Coal56AB/Oscilloscope/README.md

# Oscill — двухканальный осциллограф

Самодельный осциллограф с интерфейсом 1024 × 600, сенсорным экраном и физическими энкодерами. Проект объединяет приложение на C, платформу Zynq-7020, контроллер управления STM32 и основную плату в Altium Designer.

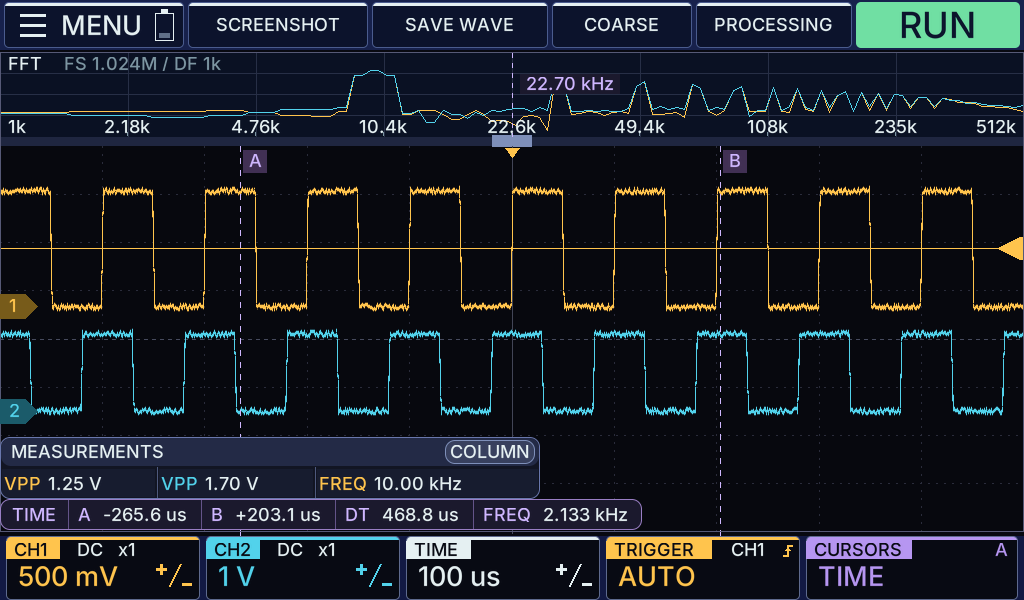
[picture p1: ZYNQ7020/gui/docs/images/preview.png]
Экран осциллографа


## Возможности

- два канала, запуск по фронту, режимы AUTO, NORMAL и SINGLE;
- измерения, курсоры, FFT и увеличение осциллограмм;
- управление касаниями, энкодерами и клавиатурой;
- сохранение и просмотр BMP и CSV;
- настольный симулятор для Windows и Linux.
- служебный задний OLED со страницами состояния по K1 ([описание](docs/HARDWARE.md)).

## Плата

Основная плата с установленным экраном, вид спереди

*3D-модель платы с установленным экраном, вид спереди: два BNC-входа и органы управления под экраном.*

## Состав проекта

- [`ZYNQ7020/`](ZYNQ7020/README.md) — приложение осциллографа, Linux и FPGA.
- [`STM32/`](STM32/README.md) — контроллер кнопок и энкодеров.
- [`TERMINAL/`](TERMINAL/README.md) — ПК-приложение для USB–UART, управления осциллографом и просмотра SD.
- [`PCB/`](PCB/) — схемы, печатная плата и файлы изготовления.

Описание интерфейса — в [README GUI](ZYNQ7020/gui/README.md), устройство платы — в [README PCB](https://github.com/Coal56AB/OscilPCB/blob/eee4854651807f123bbf42ff2ac2b7066b95e3b1/README.md), сборка — в [документации разработчика](docs/BUILD.md).
