Coal56AB/Oscilloscope/docs/CONTROL_PROTOCOL.md

# Панель управления

Панель STM32 передаёт в Zynq действия кнопок и энкодеров, а также получает команды состояния и входных диапазонов. В штатной системе приложение автоматически ищет USB–UART панели и восстанавливает связь после переподключения.

Формат сообщений и правила обмена нужны при изменении прошивки панели или приложения; они находятся в [описании протокола](agents/CONTROL_PROTOCOL.md).
