Coal56AB/Oscilloscope/docs/agents/zynq7020/BOARD.md

# Аппаратный аудит ZYNQ MINI rev B

Источник: [оригинальная схема, 12 листов](../../zynq7020/ZYNQ_MINI_REVB%20Schematic.pdf). Номера ниже — страницы PDF, начиная с 1. Текст сверён с изображениями соответствующих страниц.

## Подтверждённые сведения

| Узел | Схема, компонент, сигналы | Вывод |
|---|---|---|
| Zynq | с. 2–6, U8; символы `xc7z010-clg400`, в DDR-секции `Zynq 7010/7020` | **На фактической плате XC7Z020: подтверждено владельцем 08.10.2026.** В схеме использован символ 7010. Корпус CLG400 указан в схеме; полный суффикс и speed grade не установлены. |
| DDR | с. 6, U1 `MT41J256M16`, U8D; DQ0…15, DQS0/1, DM0/1, A0…14, BA0…2 | 256M × 16 бит = 512 МиБ, одна микросхема, **шина 16 бит**, питание 1,5 В. DQ16…31 Zynq не подключены. Speed bin памяти и настроенная частота не указаны. |
| QSPI | с. 8, U15 `W25Q128FVSIG`; с. 4 U8B MIO1…6 | 128 Мбит = **16 МиБ**, 3,3 В; CS, DQ0…3, CLK. Объём по схеме, JEDEC ID фактической платы ещё не считан. |
| Загрузка | с. 4 SW1, PR7/PR8, MIO4/5; с. 8 подписи TF1/QSPI | Переключатель задаёт boot straps: подписи схемы `10` для QSPI, `11` для TF1; положения ON и порядок битов проверять по схеме/измерению, не по виду переключателя. JTAG — отдельный путь восстановления. |
| PS clock | с. 4 X2 `33.333M/20PPM`, U8B E7 | PS_CLK_33D333M. |
| PL clock | с. 5 X1 `50M/10PPM`, U8G K17 | PL_CLK_50M, bank 35, 3,3 В. Это не подтверждённая частота АЦП. |
| HDMI | с. 5 U8G и с. 11 J1, PR15/16, Q1/Q2 | TMDS прямо из PL. Отдельного ADV7511 или другого передатчика нет. Данные: D0 P/N D19/D20, D1 C20/B20, D2 B19/A20; clock H16/H17. HDMI_OUT_EN H18 управляет питанием J1 через Q1/Q2. |
| HDMI DDC/HPD | с. 11 J1 pins 15/16/19 | DDC CLK/DATA не подключены к Zynq; HPD только через R36 100 кОм на землю. EDID и hotplug нельзя рассчитывать получать по этой схеме. Нужен фиксированный проверенный видеорежим. |
| USB Host | с. 10 U19 `USB3320C-EZK_6`, P3, X6 24 МГц, Q3 AO3407, Q4 AO3400 | PHY ULPI на PS USB0, с. 4 MIO28…39. CPEN U19 pin 17 → USBCP_EN → Q4/Q3 → VCC_USB_5.0. Есть аппаратный путь питания периферии. |
| USB reset | с. 4 U8C MIO46 D16, с. 10 U19 pin 27 | USBPHY_nRSET, active low, R66 к 1,8 В. |
| USB-C особенности | с. 10 P3 CC1/CC2 → USB_ID | Type-C CC подключены к входу ID PHY; отдельного контроллера CC и обычной схемы Rp/Rd не показано. Host Mode и совместимость конкретного переходника/кабеля требуют проверки. Это не свидетельство невозможности работы через подходящий переходник. |
| UART | с. 4 U8C MIO48 B12 TX, MIO49 C12 RX; с. 3 U9/U10 74LVC1T45, U11 CH340E, P1 | PS UART1 имеет уровни 1,8 В; U9/U10 преобразуют к 3,3 В для CH340E. **P1 несёт USB D+/D− CH340E, а не TX/RX UART.** |
| JTAG | с. 3 P2 → U12 FT2232HL → FPGA_TCK/TMS/TDI/TDO | Отдельный USB-интерфейс для JTAG; не PS USB Host и не USB-UART P1. |
| PS Ethernet | с. 4 U8C MIO16…27 (RGMII), MIO52/53 (MDC/MDIO); с. 7 U18 `RTL8211E-VL`, J3 `HR911130A` | Гигабитный порт подключён непосредственно к PS, уровни интерфейса 1,8 В. Для Linux можно использовать встроенный GEM без отдельного Ethernet MAC в PL; подключение и скорость фактической платы требуют проверки. |
| PL Ethernet | с. 5 U8G, bank 35, сигналы `PHY_*_PL`; с. 7 U17 `RTL8211E-VB`, J2 `HR911130A` | Второй гигабитный порт, интерфейс к PL 3,3 В. Не путать с PS-портом U18/J3. |
| TF1 | с. 4 MIO40…45; с. 8 TF1, U14 TXS02612RTWR | SD0, 4-bit, преобразование 1,8 → 3,3 В, загрузочный слот. CMD/SCK/D0…3. У слота нет подтверждённой линии card detect до PS. |
| TF2 | с. 4 MIO10…15; с. 8 TF2 | SD1, 4-bit, 3,3 В, второй слот для пользовательских данных; подпись схемы «не поддерживает загрузку». Сигнал INT слота не выведен к PS. |
| Расширение | с. 9 CAM1 40-pin, с. 5 U8F | 34 PL I/O: пары FPGA_GPIO_8P/N_34…24P/N_34, bank 34, 3,3 В; 6 оставшихся контактов — питание/земля. Это 34 отдельных сигнальных вывода, не 34 пары. |
| Занятые PL I/O | с. 5/7/9/12 | Bank 35: HDMI, PL Ethernet U17, I²C EEPROM U16, OLED J4, кнопки, 50 МГц. Bank 34: CAM1 и отдельные LED. Нельзя считать все выводы корпуса свободными. |

## OLED и служебные кнопки

OLED12864 J4: листы 5/12 подтверждают D0=E18, D1=E19, D/C=F16, RST=F17,
CS на земле. Листы 4/5/9: **K1=FPGA_PS_KEY1, PS MIO0 (E6)**;
K2=FPGA_PL_KEY1 (M20), K3=FPGA_PL_KEY2 (M19). Кнопки active low с
подтяжками PR9. Прежнее назначение K1=M19 было ошибкой чтения схемы;
владелец подтвердил, что этот вход физически переключается K3.
Размер 128×64 следует из обозначения J4; контроллер в схеме
не назван. Служебная индикация использует явный профиль SSD1306 из study;
его совместимость и измерения — отдельная проверка на плате. Реализация —
[STATUS_DISPLAY.md](../STATUS_DISPLAY.md).

## STM32 и АЦП основной платы

В `PCB/AnalExtend/AnalExtend.SchDoc` указаны `AD9288BSTZ-100`; в `Interfaces.SchDoc` — модуль `STM32F103RCT6` с двумя PBD 2×14. Владелец подтвердил STM32F103RCT6; назначения входов панели по схеме и выбранный UART — [STM32.md](../STM32.md). Электрическая связность фактической платы и установленный АЦП ещё не проверены.

[AD9288 Rev. C](https://www.analog.com/media/en/technical-documentation/data-sheets/AD9288.pdf) описывает две 8-битные ветви до 100 MSPS у версии -100. Два AD9288 дают четыре 8-битные шины, то есть 32 линии данных. Интерливинг двух ветвей одного канала при сдвиге тактов на половину периода — целевое решение; сам факт применения -100 не подтверждает корректность фаз, аналоговой полосы или gain/offset alignment.

По текущей основной схеме оставшиеся два I/O — общие CLK_A/CLK_B обеих микросхем. XS1.3/4 соответствуют CAM1.39/2, P15/U15; попарная нумерация XS1 отличается от последовательных рядов CAM1 в PDF. S1=1, S2=0, DFS=0. Полная карта и выбранный приём — [ADC_CAPTURE.md](../ADC_CAPTURE.md). Соединения и фазы на установленной плате измерением ещё не подтверждены. UART панели идёт через USB и контактов CAM1 не занимает.

Владелец подтвердил путь панели: UART STM32 → USB–UART мост на модуле STM32 → USB hub вместе с сенсором → PS USB Host P3 Zynq. Linux включает драйверы CH341, CP210x и CDC ACM, GUI автоматически ищет панель среди USB serial устройств. Точная маркировка моста не установлена. P1 Zynq остаётся загрузочной консолью. Физический обмен панели с Zynq ещё требует проверки на устройстве.

## Перед первым запуском платы

Handoff и FSBL получены из `ZYNQ7020/build.ps1`: DDR ×16, 512 МиБ, заданные 400 МГц; CPU 600 МГц. Режим HDMI — 1024×600, pixel clock 50 МГц, totals 1344×620. Первый тест запускается с TF1 по [BRINGUP.md](../BRINGUP.md).

На плате проверить DDR training и тест памяти; ULPI reset/clock/CPEN и VBUS; USB enumeration и два независимых tracking ID сенсора; видеорежим дисплея. Для последующих аппаратных этапов нужны маркировки U8/U1/U15, подключение STM32, распиновка АЦП и фазы. Резервная копия QSPI нужна перед её изменением. Эти проверки не заменяются успешной компиляцией.

Справочные источники: [AMD UG585](https://docs.amd.com/r/en-US/ug585-zynq-7000-SoC-TRM/Introduction), [параметры HP-портов](https://docs.amd.com/r/en-US/ug585-zynq-7000-SoC-TRM/Performance-Optimization-Summary), [пин-группы Linux Zynq](https://github.com/Xilinx/linux-xlnx/blob/xlnx_rebase_v6.6_LTS_merge_6.6.70/drivers/pinctrl/pinctrl-zynq.c).
