Coal56AB/Oscilloscope/ZYNQ7020/gui/README.md

# OscilGUI

Интерфейс двухканального осциллографа для LCD 1024 × 600. Отрисовка написана на C и формирует готовый кадр RGB888, поэтому её можно встроить в проект прибора или запустить как настольный симулятор в Windows и Linux.

Основной экран OscilGUI

## Возможности

- два канала с независимыми масштабом, положением и связью AC/DC;
- режим XY: CH1 по горизонтали, CH2 по вертикали, включение в DISPLAY → MODE;
- развёртка от 10 нс/дел до 5 с/дел; на приборе в AUTO свыше 100 мс/дел — прокрутка ROLL;
- длина записи 10K–1M точек в PROCESSING с автоматической частотой отсчётов;
- запуск по фронту в режимах `AUTO`, `NORMAL` и `SINGLE`;
- до десяти измерений, временные и амплитудные курсоры;
- FFT с логарифмической шкалой, сглаживание, окраска по плотности и увеличение сохранённого захвата;
- управление с сенсорного экрана, клавиатуры или отдельной панели энкодеров;
- сохранение последних настроек и пять пресетов с выбором состояния при включении;
- измерение АЧХ и независимая амплитудная коррекция каналов;
- просмотр BMP и CSV, сохранение снимков экрана и отсчётов сигнала;
- сглаженный шрифт Inter.

## Управление

Нижние карточки открывают настройки каналов, развёртки, триггера и курсоров. Масштаб и положение меняются энкодерами или жестами на графике. Верхняя панель содержит меню, снимок экрана, сохранение CSV, обработку сигнала и `RUN/STOP`.

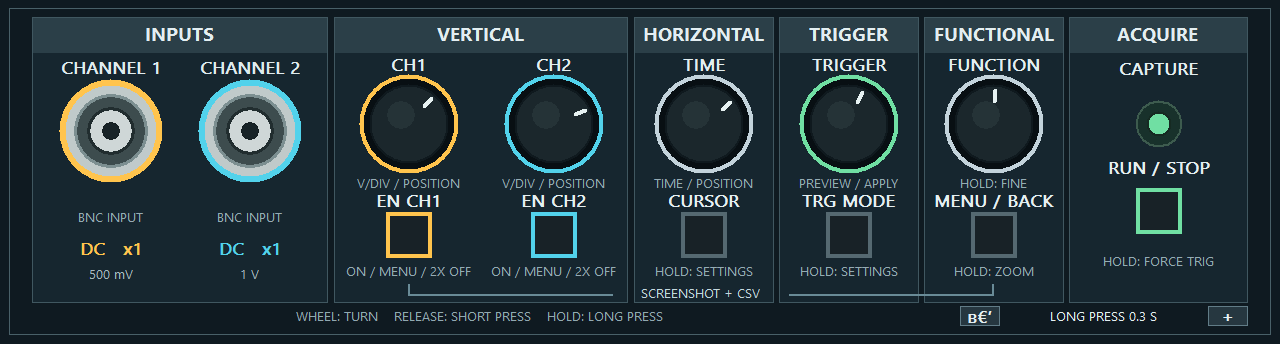
[picture p2: ZYNQ7020/gui/docs/images/panel_preview.png]
Панель энкодеров и кнопок


Короткое нажатие энкодера выбирает действие, удержание вызывает дополнительную функцию. В симуляторе колесо мыши вращает энкодер, а клик имитирует нажатие. Основные действия также доступны клавишами `1`, `2`, `C`, `T`, `M`, `Space`, `Enter`, `F2` и `F3`.

Пресеты находятся в MENU → SETUP → PRESETS, выбор состояния при включении — в SETUP.
Настройки, сохранение и калибровка — в [описании работы с прибором](../../docs/USAGE.md).

## Сборка

### Windows

Нужны [MSYS2](https://www.msys2.org/), UCRT64 и CMake. Сборка использует WinAPI; команды приведены в [документации разработчика](../../docs/agents/BUILD.md#windows).

Приложение автоматически использует отдельный дисплей 1024 × 600, если он подключён в режиме «Расширить». Панель управления остаётся на основном мониторе.

### Linux

Нужны CMake и SDL2. Команды для настольного Linux и ARM — в [документации разработчика](../../docs/BUILD.md).

Флаг `--windowed` принудительно включает оконный режим, а `--kiosk` открывает только LCD на весь экран.

## ASUS Tinker Board

Для Tinker Board собирается переносимый пакет ARM32/ARM64. Распакуйте его на накопитель и запустите `START.desktop` — компилятор на плате не нужен.

Инструкция по самостоятельной сборке находится в [`tinker_board/BUILDING.md`](tinker_board/BUILDING.md).

## Встраивание

Отрисовку интерфейса можно подключить к приложению прибора.

Описание структур данных и пример вызова приведены в [`DEVELOPMENT.md`](DEVELOPMENT.md). Сборка для Zynq — в [документации проекта](../../docs/BUILD.md).
