Coal56AB/Oscilloscope/docs/FPGA_DSP.md

# Обработка сигнала в ПЛИС

В `ZYNQ7020/fpga/` находятся модули подавления шума, сглаживания, измерений, определения фронтов и управления триггером. Они обрабатывают отсчёты АЦП независимо от протокола исследуемого сигнала.

Перенос обработки в ПЛИС выполняется поэтапно. Состав модулей, их подключение и оставшиеся границы обработки описаны в [техническом документе](agents/FPGA_DSP.md).
