Coal56AB/Oscilloscope/docs/agents/ADC_CAPTURE.md

# Захват AD9288 на Zynq

## Запланированные доработки ПЛИС

По поручению владельца от 30.10.2026 следующие задачи сохранены для будущей
реализации. Обе задачи открыты; приведённые ниже требования не описывают
возможности текущего bitstream.

- [ ] **PL-TRIGGER — расширенный аппаратный триггер.** Добавить запуск по
  длительности импульса (короче/длиннее заданной), неполному импульсу
  (runt: пересечение первого порога без достижения второго), выходу из окна
  напряжений и пропаданию импульсов по тайм-ауту. Условия проверять по входным
  отсчётам до прореживания, чтобы событие между сохранёнными точками не
  терялось. Передавать в запись тип события и его положение с однозначной
  привязкой к исходной и сохранённой временным шкалам. До реализации
  определить границы сравнений, полярность, гистерезис, повторный взвод и
  влияние фильтрации. Проверить события на границах DMA-блоков, порогов и
  заданной длительности, а также короткие события внутри интервала
  прореживания; согласовать поведение AUTO/NORMAL/SINGLE, holdoff и FORCE.
- [ ] **PL-PRETRIGGER — аппаратная предыстория на всю выбранную глубину.**
  Реализовать управляемое ПЛИС кольцо записи в DDR с настраиваемой долей
  предыстории, накоплением заданного участка после события и аппаратной
  фиксацией законченной записи. Память выделяет Linux-драйвер; готовая
  запись защищена от перезаписи до возврата владения. ARM получает запись
  с точным положением события, фактическими длинами до/после него и
  признаками неполной предыстории или потери данных. Определить поведение
  события до заполнения предыстории и крайних положений триггера.
  Проверить SINGLE с большой долей предыстории, переход через конец кольца,
  все поддерживаемые глубины и частоты выборки, Peak Detect, RUN/STOP,
  повторный взвод и одновременную работу HDMI.

Эти изменения развивают захват и триггер. Существующее разделение
ПЛИС/драйвер/обработка/GUI сохраняется; аппаратные параметры и достижимые
характеристики подтверждаются расчётом и измерениями при реализации.

## Запуск и DEBUG

Штатный Linux запускает GUI с `--adc /dev/oscill-capture`; путь задаёт
`ADC_DEVICE` в `/etc/default/oscill`. Для настольного Linux остаются прежний
деморежим без аргументов, `--raw-demo` и `--capture FILE`. Windows работает
прежним настольным симулятором.

DEBUG → SIMULATION по умолчанию ON. АЦП тактируются, FPGA принимает их шины,
DMA записывает данные в DDR, драйвер выдаёт завершённый блок. Только после
этого обработчик формирует отдельную запись
симулируемого сигнала. CH1 WAVE, CH2 WAVE и FREQUENCY в GENERATOR действуют
на следующий полученный блок. Выбор формы использует тот же генератор, что
настольный GUI; для периодических форм применяется таблица из 1024 значений.
К периодическим DEBUG-формам добавляется псевдослучайный шум −1/0/+1 код
(при номинальной шкале DEBUG — до ±20 мВ). Шум меняется между отсчётами
и аппаратными блоками; повторная обработка того же блока даёт те же значения.
NOISE остаётся отдельной формой генератора. Закончившийся DMA остаётся
условием каждого нового блока,
но CPU не перечитывает по байту значения, которые будут заменены.

SIMULATION OFF копирует значения АЦП из DMA-памяти в историю для обработки.
Ни отсутствие устройства, ни timeout, ни ошибка DMA не запускают запасной
программный генератор. В STOP удерживается прежняя запись; масштаб, позиция,
ZOOM и FFT работают с ней. Смена SIMULATION/GENERATOR в STOP не меняет её.
FORCE получает новые аппаратные блоки даже в STOP и ждёт полного
экранного интервала.

Клоки АЦП работают постоянно. STOP останавливает получение новых записей GUI,
а не преобразования: драйвер продолжает обмен и может переиспользовать только
блоки, которыми приложение не владеет. AUTO показывает полный интервал без
найденного фронта, NORMAL ждёт пересечения уровня, SINGLE удерживает первый подходящий
интервал. В bitstream с DSP фильтрация и определение фронта выполняются
в ПЛИС, номер события передаётся в TRG1. Приложение собирает запись вокруг
этого номера без повторного поиска. Для прежнего bitstream и специальных
режимов сохраняется программный путь. Аппаратного кольцевого pretrigger
на всю память в этой реализации нет.

RISING требует подтверждённого перехода снизу вверх через шумовую полосу,
FALLING — сверху вниз. Её полуширина — не менее двух кодов АЦП, увеличивается
по соседним разностям отсчётов и ограничена четвертью наблюдаемого размаха и
расстоянием уровня до его границ в программном пути; DSP использует полосу
в два кода после фильтрации. После подтверждения метка остаётся на
пересечении выбранного порога. Короткий возврат на исходную сторону не является
фронтом. При начале разрешённого интервала состояние восстанавливается по
предыдущим отсчётам. В BOTH допускаются оба направления с тем же условием.
Если выбран FILTER канала, поиск использует ту же симметричную фильтрацию,
что и видимая кривая; исходная запись не изменяется.
Если экранный интервал помещается в историю, поиск фронта начинается после
необходимой предыстории. Маркер вычисляется из позиции найденного отсчёта
и экранного интервала, поэтому перемещается вместе с сигналом при PAN и ZOOM.
FFT рассчитывается в потоке обработки при включённом спектре. Используются
первые последовательные отсчёты видимого участка: степень двойки от 1024 до
1048576, не больше доступного участка; короткий участок дополняется нулями.
Окно — Ханна, среднее удаляется;
выборка через всю запись для FFT не выполняется. Шкала начинается с 0 Гц,
переходя к логарифмической по закону `DF × expm1(log1p(Fs/2/DF) × x)`;
DF=Fs/N, подписи, группировка и курсор используют один N. Нули при дополнении
не увеличивают физическое разрешение короткой записи.
Исходные суммы и квадраты кодов сохраняются отдельно для ZERO/NOISE и оценки
шума при калибровке АЧХ. Measurements использует обработанные отсчёты канала.

PROCESSING → CH1/CH2 FILTER сглаживает отсчёты выбранного канала перед
построением экранной кривой. LOW, MEDIUM и HIGH — симметричное скользящее
среднее по 5, 17 и 65 сохранённым отсчётам; окно не зависит от увеличения
остановленной записи. Сглаживаются кривая, её границы, попадания COLORING
и соединения. У фильтра нет фазового сдвига; фронты становятся положе,
короткие импульсы и высокие частоты ослабляются. Это частоты относительно
Fs сохранённой записи, а не постоянная аналоговая полоса.
Нативные Peak Detect экстремумы с неизвестным временем внутри интервала
не накладываются поверх отфильтрованного канала. Исходная запись и FFT
не меняются; измерения напряжения, частота, период и duty вычисляются по
обработанной кривой. OFF полностью возвращает
прежнюю кривую. В STOP смена фильтра пересчитывает ту же запись без захвата.
Длина записи выбирается в PROCESSING → RECORD LENGTH; TIME отсутствует
в главном меню, настройки развёртки открываются нижней карточкой TIME.

Обычный след и INTENSITY COLORING используют реальные попадания сохранённых
отсчётов в каждый пиксель временного окна; при FILTER берутся сглаженные
значения тех же отсчётов. Плотность нормируется по максимуму
канала. В обычном режиме она задаёт яркость жёлтого/голубого; в COLORING
редкие попадания синие, наиболее частые красные. Соединение отсчётов тонкое,
без дополнительного контура, и не увеличивает счётчики. Для аппаратной записи
обработчик отдельно растеризует отрезки между всеми последовательными
сохранёнными отсчётами с пересечением временных границ пикселя. Кривая из
одного выбранного отсчёта на колонку для этого не используется. Покрытие
отрезков задаёт яркость соединения: максимум каждой колонки имеет полную
яркость независимо от сжатия; редкое покрытие ослабляется по корневой шкале
с нижним уровнем 96 из 255. Карта реальных попаданий накладывается
поверх; в COLORING соединение синее и имеет минимальную видимую яркость.
Ни покрытие отрезков, ни Peak Detect не добавляют попаданий в гистограмму.
Сплошной заливки
между минимальным и максимальным шумовым отсчётом нет.

Peak Detect хранит границы двухотсчётных интервалов, но не время и порядок
самих экстремумов. Выходящий за диапазон равномерных отсчётов размах
показывается отдельной полупрозрачной полосой своего интервала. Её яркость
нарастает с величиной пропущенного отклонения и достигает заданного уровня
при четырёх кодах АЦП; малые выбросы сохраняются с меньшей яркостью.
При увеличении полоса плавно ослабевает на трёх двукратных шагах плотности:
полная яркость при четырёх отсчётах на пиксель, две трети при двух,
треть при одном и ноль при половине отсчёта на пиксель. Используется
частота сохранённой записи. Различимые точки соединяются яркой тонкой
линией; фон не перекрывает их на сильном увеличении.
В сжатом виде видны покрытие настоящих отрезков, полоса пропущенного размаха
и сами попадания, без кривой по прореженным опорным точкам и без выдуманных
треугольников. Подавление такой опорной кривой не разрывает реальные фронты.
Равномерные отсчёты и min/max не подменяют
друг друга. Увеличение показывает сохранённые точки; отброшенные до записи
отсчёты по одним min/max восстановить нельзя.
В STOP запись и плотность сохраняются;
ZOOM пересчитывает их из той же записи. BMP/CSV сохраняют прежние форматы.

## Измерения времени и обновление экрана

FREQ, PERIOD и DUTY используют обработанные отсчёты видимого интервала до
экранного сжатия. Уровень находится между 5-м и 95-м процентилями; при узком
импульсе используется полный размах. Переход подтверждается через полосу
не менее двух кодов АЦП или 15% оценённого размаха. Время пересечения уровня
интерполируется между соседними отсчётами, отдельно от момента подтверждения.

Частота усредняется по полным периодам между подтверждёнными нарастающими
фронтами. DUTY — отношение суммарного положительного времени к длительности
этих периодов; незавершённые участки на краях окна исключены. Периоды,
отличающиеся от медианы более чем на 20%, отбрасываются, согласованными
должны быть не менее 75%. При более чем 4096 периодах используется потоковая
оценка среднего и дисперсии с допустимым относительным разбросом 20%; память
оценки ограничена. При недостаточном размахе, отсутствии полного периода или
нерегулярном сигнале выводится `--`. Межкадрового сглаживания чисел нет.
Vpp, RMS, среднее и экстремумы рассчитываются по тем же обработанным
отсчётам видимого интервала, что и кривая, до сжатия до 1024 колонок.
Vpp — разность наибольшего и наименьшего значения, включая видимые выбросы;
он может превышать разность уровней, выбранных курсорами на полках меандра.
MIN/MAX учитывают нативные Peak Detect экстремумы только тогда, когда их
передаёт используемый источник кривой. Для RMS и среднего используются
равномерные отсчёты: неизвестная длительность нативных пиков не выдумывается.
Автоматическое подавление шумовой огибающей решает отдельно для каждого
нативного интервала; объединение интервалов не возвращает подавленные пики.
В STOP смена FILTER пересчитывает числа из удерживаемой записи.

FILTER применяется только к видимому участку с полным запасом соседних
отсчётов для обоих фильтров. Для триггера окно начинается перед ещё не
проверенным интервалом и расширяется вперёд по необходимости; состояние
гистерезиса восстанавливается назад даже через длинный участок внутри полосы.
Автоматическая шумовая полоса оценивается по текущему окну поиска. Фронт
принимается только с полным запасом фильтра за отсчётом подтверждения.

Перед полной фильтрацией поиск проверяет границы кодов порциями по 256
отсчётов. Подавление шума рассчитывается только там, где исходные границы
допускают пересечение уровня; соседние отсчёты берутся с полным запасом.
Оба фильтра сохраняют значение внутри диапазона своих входов, поэтому
отсутствие необходимых уровней позволяет сразу отклонить блок тишины.
Окно поиска начинается у первого возможного перехода. После проверенного
участка можно перейти к следующему кандидату, если нет незавершённого
пересечения; иначе окно расширяется до его подтверждения. Метка события
остаётся меткой исходного пересечения, даже при долгом ожидании выхода
из полосы гистерезиса.

Скрытый канал не строит кривую и карты, но его исходные амплитудные статистики
и запрошенный FFT сохраняются. Плотность хранит только занятые ячейки
гистограммы при расчёте и нормируется общим максимумом канала. Пустые блоки
карт пропускаются растеризатором NEON. Новый захват сначала строит слой графика;
композиция интерфейса запускается после его готовности. Запросы состояния
через remote API не инициируют повторное построение графика.

## Текущие коды и стартовая проверка

DEBUG на HDMI содержит строки ADC CH1 и ADC CH2. На OLED текущие коды
показаны одной строкой `CH1:… CH2:…` на существующей странице Capture.
Значения 0…255 берутся из последней пары полученного DMA-блока до
подмены SIMULATION. Масштаб, положение луча и щуп их не меняют.
До первого блока, при ошибке и спустя три секунды без новых данных
показывается прочерк. В STOP новые блоки не считываются; удерживаемая
осциллограмма не используется для обновления диагностических кодов.

При запуске с `--adc` проверяются заданная USB-панель, карта
данных при `--require-data-device`, затем физические такты и поток АЦП.
При отказе показывается причина и проверка повторяется; осциллограф и remote API
запускаются после успеха. Сенсор необязателен, его поиск и переподключение
выполняются во время работы GUI.
Порядок, частоты и границы этой проверки — [STARTUP_CHECKS.md](STARTUP_CHECKS.md).

## Вертикальный масштаб

Для SIMULATION OFF коэффициент кодов АЦП задаёт аппаратная ступень реле,
подтверждённая панелью STM32. Общая таблица — `input_range.h`; номинальный
пересчёт равен `0,004 × (1 МОм + Rниж) / Rниж` В/код до учёта щупа.
Значение 0,004 следует из номинальных 1,024 Vpp и 256 кодов AD9288;
сопротивления и ступени описаны в [STM32.md](STM32.md). Это расчёт по схеме,
без калибровки незавершённого аналогового тракта.

Измеренный в CALIBRATE → ZERO ноль вычитается при совпадении аппаратной ступени
и щупа. Поправка меняет метаданные представления записи: исходные коды и их
номинальный ноль сохраняются. Кривая, измерения и поиск триггера используют
одну поправку. В STOP переключение APPLY CALIBRATION пересчитывает ту же запись,
сохраняя измеренные нули и шум для последующего включения.
При измерении ZERO/NOISE используются коды до этой поправки, поэтому повторная
калибровка нуля не измеряет остаток предыдущей.
Для каждой из трёх рабочих ступеней хранится отдельная калибровка. Автоматическое
сглаживание по измеренному шуму применяется перед ручным FILTER. Оно учитывается
Measurements; FFT и отдельная исходная статистика калибровки не сглаживаются.
Описание прохода и обработки — [CHANNEL_RESPONSE.md](CHANNEL_RESPONSE.md).

В/дел отдельно задаёт вертикальное увеличение записи. В пределах одной
аппаратной ступени увеличение В/дел уменьшает высоту прежних кодов на экране,
сохраняя их напряжение. Щуп ×10 меняет единицы напряжения, сохраняя высоту
следа в RUN. В STOP применяется коэффициент сохранённой записи; переключение реле
не переписывает уже принятые отсчёты. DEBUG сохраняет собственную шкалу генератора.

## Подключение

Источники: `PCB/AnalExtend/AnalExtend.SchDoc` и листы 5/9
`docs/zynq7020/ZYNQ_MINI_REVB Schematic.pdf`. XS1 основной платы имеет
попарную нумерацию, CAM1 в PDF — последовательную по каждому ряду:
`XS1 2*k = CAM1 k`, `XS1 2*k-1 = CAM1 41-k`. Соответствие проверено по
питанию: XS1 1/2 — 5 V/GND, 37/38 — GND, 39/40 — 3,3 V.

Пины ниже перечислены от D0 до D7. ADC0 соответствует CH1, ADC1 — CH2.

| Шина FPGA | Сети схемы | Контакты XS1, D0…D7 | Выводы Zynq, D0…D7 |
|---|---|---|---|
| adc0_a | ADC0_D0B…D7B | 11, 12, 9, 10, 7, 8, 5, 6 | Y19, W18, Y18, V18, V17, U17, V15, W15 |
| adc0_b | ADC0_D0A…D7A | 14, 13, 16, 15, 18, 17, 20, 19 | U19, W19, U14, N17, Y14, W14, V16, P16 |
| adc1_a | ADC1_D0B…D7B | 27, 28, 25, 26, 23, 24, 21, 22 | R18, W20, W16, R17, T16, T17, R16, U18 |
| adc1_b | ADC1_D0A…D7A | 30, 29, 32, 31, 34, 33, 36, 35 | V20, P19, U20, P18, T20, N18, P20, N20 |

`adc_clk_a` подключён к CLK_B схемы: XS1.3 → CAM1.39 → P15;
`adc_clk_b` — к CLK_A: XS1.4 → CAM1.2 → U15. Имена A/B в FPGA обратны
обозначениям схемы одновременно для данных и тактов. Это различие имён само
по себе не означает перепутанные такты и данные. В диагностике чётные отсчёты
обозначены FPGA A (физическая B), нечётные — FPGA B (физическая A).
В частности, `adc0_b[5]` — физический ADC0_D5A, XS1.17, W14 Zynq;
по таблице выводов AD9288 это вывод 42 АЦП.
ADC0_D3A проходит через вывод 40 АЦП, XS1.15 и N17 Zynq. Эти две линии
различаются по исходной схеме разъёма MINI: CAM1.32 — GPIO8P/W14,
CAM1.33 — GPIO23P/N17. Связность всех 32 линий данных сверяется отдельно
от логических имён ветвей.

Два общих выхода PL тактируют обе микросхемы. В схеме DFS=0, S1=1, S2=0:
offset binary, обе ветви включены, выравнивание выходов отключено.

## Такты и данные

По [AD9288 Rev. C, таблица 1 и раздел Timing](https://www.analog.com/media/en/technical-documentation/data-sheets/AD9288.pdf)
версия -100 рассчитана на 100 MSPS на ветвь; выход обновляется после фронта
её собственного encode. FPGA задаёт A/B 100 МГц со сдвигом 180° через ODDR.
Приёмные регистры IOB тактируются фазой 148,5° и её противоположным фронтом;
следующая ступень соединяет пару A/B в хронологическом порядке.
Конфигурация даёт целевые 200 MSPS на канал, 400 МБ/с полезных данных.
Это заданные частоты, не измеренная производительность платы.

В XDC учтены tV(min)=2 нс и tPD(max)=6 нс из datasheet и расчётный запас
1,5 нс на путь по платам. Захватывается слово предыдущего периода encode:
setup проверяется через 14,125 нс, hold — относительно следующего encode.
Выходы такта настроены LVCMOS33, DRIVE 4, SLEW FAST; фаза выбрана с учётом
задержек ODDR/OBUF и входных IOB. Задержки и перекос реальной разводки не измерены.
DEBUG проверяет загрузку цифрового тракта; подмена значений сама по себе
не подтверждает правильность принятых кодов, фазовое согласование аналогового
интерливинга или точность входного тракта.

Диагностическое деление encode сохраняет приёмный такт 100 МГц. Пару A/B
разрешает положение счётчика `(period/2 + 3) & (period - 1)`: дополнительные
циклы учитывают передачу такта к АЦП, его tPD и возврат данных к входным
регистрам. Изменение encode само по себе не увеличивает эту задержку.
Тест `ad9288_settle_tb` проверяет принадлежность A/B одному циклу при
возвратной задержке 6 и 13 нс для всех семи частот encode. Эти задержки —
модели проверки, а не измерение электрических задержек платы.

`ad9288_input` → `axis_capture_decimate` → упаковка 32→64 бит → FIFO 2048 × 64 → `axis_capture_frame` → AXIS CDC →
AXI DMA S2MM/SG → PS HP0 → DDR. HDMI продолжает читать через HP2.
FIFO отдаёт до 64 бит за такт при среднем входе 32 бита за такт: после
вставки заголовка накопившиеся отсчёты передаются с удвоенной скоростью.
При включении потока reset снимается с AXIS IP сразу после синхронизации
enable; отсчёты начинают передаваться через 32 такта. За это время
преобразователь ширины, FIFO и CDC выходят из reset и поднимают READY.
Переполнение входа защёлкивается и останавливает публикацию корректных
данных до повторного открытия устройства. Драйвер обнаруживает флаг либо
отсутствие завершений в течение секунды и возвращает ошибку.
Первую причину ошибки драйвер записывает в `dmesg` с префиксом `capture:`:
overflow, отсутствие завершений, ошибка DMA, неверный заголовок или
невозможность поставить буфер в очередь.

## Память и измерения

Драйвер выделяет 16 × 2 МиБ coherent DMA-памяти; CMA задана 64 МиБ.
Шаг между буферами фиксирован, длина передачи — 64 байта заголовка и
8…1 048 576 байт payload. GUI выбирает размер не более 40 мс сигнала.
Аппаратное прореживание уменьшает поток в DDR, не останавливая такты АЦП.

TIME задаёт длину записи на канал: 10K, 50K, 100K, 500K или 1M точек;
по умолчанию 100K. Частота автоматически выбирается из ряда 200, 100, 50,
20 MSa/s и далее 1–2–5 до 100 Sa/s. Для обычной развёртки запись вмещает
не менее двух видимых интервалов, для ROLL — один. В TIME показана фактическая
частота. При прореживании каждая опорная точка — среднее всех исходных
A/B за соответствующий интервал. Делитель 1…1 000 000 задаёт от 2 до
2 000 000 входных отсчётов на точку. Остаток деления переносится в следующую
точку, исключая постоянное смещение от округления. Обе фазы АЦП имеют
одинаковый вес. Режим 200 MSa/s передаёт
исходные A/B без усреднения. Рядом с двумя опорными точками FPGA сохраняет
min/max обоих каналов за весь соответствующий интервал исходных A/B. Поэтому длинная
развёртка сохраняет размах меандра и короткие выбросы между выбранными точками.
Прямоугольное усреднение N точек имеет характеристику
`|sin(πNf/Fadc)/(N*sin(πf/Fadc))|`, где Fadc=200 МГц и N=2*divider.
Это ограничивает полосу до прореживания; для независимого белого шума RMS
уменьшается примерно в sqrt(N) раз до влияния квантования. Фильтр не является
идеальной защитой от alias: сигналы выше новой частоты Найквиста всё ещё
могут влиять на FFT и измерение частоты. Нативные экстремумы не усредняются.

Диапазон развёртки — 10 нс/дел…5 с/дел. В AUTO длиннее 100 мс/дел включается
ROLL: новые отсчёты приходят справа, история заполняется за реальное время.
NORMAL и SINGLE сохраняют привязку к триггеру; завершённый интервал требует
накопления предыстории и участка после события. Обычная развёртка, включая
10/20/50/100 мс/дел, обновляется целым кадром после накопления полного
интервала. До этого сохраняется предыдущий кадр; правило действует также
после пропуска данных и смены масштаба. При ZOOM сначала накапливается
полный основной интервал. STOP сохраняет исходные
отсчёты для PAN/ZOOM. Пустая часть при начальном заполнении ROLL или выходе за
границы остановленной записи не подменяется повторением сигнала.

DEQUEUE/RELEASE защищают leased-блоки от DMA. Драйвер поддерживает очередь
дескрипторов, переиспользуя самые старые READY-блоки, когда обработчик
отстаёт. Пропуски обнаруживаются по аппаратному sequence/first_sample;
DEBUG сохраняет эти метаданные и подменяет значения только после завершения
DMA. Перед чтением payload проверяется аппаратная сводка: диапазоны исходных
значений и окон из 17 точек, а при поддержке MMX3 — возможность достижения
обеих сторон порога тем же адаптивным подавлением шума. Тихие блоки не
распаковываются целиком; хвост контекста сохраняется. Возможный фронт вместе
с необходимой предысторией проходит общий программный детектор без привязки
к протоколу сигнала. Точная проверка остаётся программной. В обычной развёртке
история вмещает выбранную глубину и один дополнительный payload;
при DSP нужны два payload из-за задержки заголовка события и posttrigger.
DSP удерживает до пяти тихих блоков контекста, вместе с текущим — до шести leases.
Если событие уже вышло из истории, оно учитывается в `capture_dsp_missed`
и выполняется новый взвод. Программный поиск читает непрерывное
кешируемое представление истории без полного снимка. После принятия события
копируется только выбранная глубина вокруг него; пары Peak Detect выровнены.
ROLL хранит только выбранную глубину. История, три принадлежащие обработчику
записи и рабочая память DEBUG ограничены 24 194 304 байт суммарно
(поровну отсчёты и экстремумы), плюс до 32 МиБ кешируемой распаковки leased DMA-блоков и около 8 МиБ кадров отображения (три слота обработчика и кадр GUI). Для обзора ZOOM временно выделяется ещё один кадр около 2 МиБ. При разрыве последовательности история начинается заново,
чтобы не склеивать несмежные интервалы времени. Генератор DEBUG поддерживает
1 Гц…1 МГц; для проверки длинных развёрток подходят низкие частоты.

AUTO, NORMAL и SINGLE проверяют триггер после каждого блока DMA.
Ограничение свободного хода AUTO до одного представления за 40 мс применяется
после поиска и не пропускает поиск событий. Захват и поиск выполняются отдельно
от обработки принятой записи через общее кольцо с заменой ожидающего кадра.
Обработка удерживает собственную запись для STOP; DMA lease возвращается
до поиска и построения графика. На Cortex-A9 суммы, квадраты и экстремумы
обрабатываются NEON; накопители ограничены по размеру порции,
целочисленные результаты совпадают с переносимым расчётом.

AXI DMA выдаёт IRQ после каждого блока. Возвращённые дескрипторы добавляются
к активной SG-цепочке с обновлением tail, пока последующие блоки ещё принимаются.
Ожидание окончания всей партии перед запуском следующей создаёт паузу,
которую FIFO 16 КиБ при расчётных 400 МБ/с покрывает лишь примерно на 41 мкс.
Патчи драйвера хранятся в `linux/board/patches/linux/`; таймауты ожидания
регистров используют задержку 1 мкс между чтениями.

ПЛИС вычисляет границы равномерных кодов одновременно с передачей блока
и помещает результат в следующий заголовок. Acquisition использует их
как необходимое условие фронта, до чтения и распаковки полного payload.
Тихий контекст удерживается до решения о следующем блоке; возможное
событие проверяется общим фильтрованным детектором с предысторией и
posttrigger. Эта ступень не меняет глубину записи или поток DMA в DDR.

Коэффициент реальных данных — номинальные восемь делений выбранного масштаба
на 256 кодов, zero=128, с учётом щупа. Это пересчёт по номиналам, не
индивидуальная калибровка. Debug использует собственный коэффициент
генератора; его вольты не относятся к входному тракту.

Для проверки на плате включить `DIAGNOSTICS=1`, наблюдать blocks, dropped,
source_error и время обработки при включённом HDMI. Затем выключить
SIMULATION и проверить коды от известного сигнала или постоянного уровня.
Короткие проверки на плате подтвердили непрерывный приём около 400 МБ/с
и неизменность удерживаемого буфера; условия и пропуски читателя описаны
в [TESTING.md](TESTING.md). Длительная нагрузка и достоверность аналоговых
кодов остаются отдельными проверками. Формат ABI и заголовка —
[CAPTURE_INTERFACE.md](CAPTURE_INTERFACE.md).
