Coal56AB/Oscilloscope/docs/agents/CHANNEL_RESPONSE.md

# Калибровка каналов

Удерживайте кнопку CH1 или CH2 и выберите CALIBRATE. В нём три раздела:
ZERO, NOISE и FREQUENCY RESPONSE. Все действия доступны энкодером этого канала
и FUNC; удержание энкодера или BACK возвращает на предыдущий уровень.

Для ZERO замкните вход щупа на его землю и нажмите MEASURE ZERO.
Прибор автоматически переключит три рабочие ступени реле, усреднит по четыре
новые записи на каждой и применит соответствующее смещение к кривой,
измерениям и уровню поиска триггера. APPLY CALIBRATION → OFF отменяет её применение,
сохраняя измеренные нули; ON возвращает ту же поправку.
Применение и сброс работают также в STOP над сохранёнными исходными отсчётами.
Подписи 100/200 мВ, 500 мВ/1/2 В и 5 В используют соответственно три аппаратные
ступени; повторно измерять одинаковое положение реле для разных В/дел не нужно.
После завершения или отмены восстанавливается исходный диапазон.

С тем же замкнутым входом NOISE → MEASURE NOISE независимо измеряет RMS собственного шума по четырём
новым записям на каждой из тех же трёх ступеней. После полного прохода включается
автоматическое сглаживание по измеренной мощности шума: плато сглаживаются,
выраженные фронты сохраняются. Ручной FILTER в настройках канала применяется отдельно
после него. Слабые детали на уровне шума тоже могут ослабляться.
Измеренный шум также учитывается при сборе АЧХ. APPLY CALIBRATION → OFF в NOISE
отключает автоматическое сглаживание и учёт шума при сборе АЧХ. ON повторно
применяет сохранённые результаты всех ступеней без нового прохода.
Применение нуля и шума переключается независимо для каждого канала и сохраняется
в последних настройках и пресетах; измеренные данные остаются общими для пресетов.
Отмена незавершённого прохода сохраняет все прежние результаты.
Завершённое новое измерение автоматически включает его применение.
При отсутствии соответствующей калибровки переключатель серый.

Ноль и шум привязаны к аппаратной ступени диапазона и коэффициенту
щупа. При другом коэффициенте нулевая поправка не применяется; в её разделе
показано OTHER RANGE / MEASURE. Для измерения АЧХ шум нужно измерить на текущей
ступени либо отключить его применение.

FREQUENCY RESPONSE открывает график АЧХ выбранного канала. START запускает
набор точек; RUN или короткое нажатие FUNC останавливает и возобновляет его.
MENU открывает управление этим режимом; BACK возвращает в CALIBRATION.

Подайте синус и меняйте его частоту, сохраняя амплитуду на входе прибора.
Первая принятая точка задаёт 0 дБ. Каждая следующая показывает подъём или спад
относительно неё; повторные измерения близкой частоты уточняют ту же точку.
В начале график пуст. Прибор добавляет точки по мере получения пригодных записей.
STOP сохраняет кривую, следующий START продолжает её уточнение.
Красная CLEAR POINTS удаляет точки для нового прохода.

CLEAR POINTS сохраняет измеренные ноль и шум.

Выберите развёртку, на которой помещается несколько периодов входного сигнала.
Если точек пока нет, проверьте TIME и амплитуду: перегруженный вход, шум без
выраженного тона и частота ниже разрешения текущего FFT не принимаются.
В режиме калибровки частота определяется по основному спектральному пику;
используется окно Ханна и уточнение положения пика по соседним значениям.
Изменение амплитуды самого источника тоже попадёт в измеренную АЧХ.

После набора хотя бы двух частот можно включить AMPLITUDE CORRECTION.
Коррекция применяется к кривой, её измерениям и FFT в пределах измеренного
диапазона; за его пределами усиление остаётся единичным. Между точками
используется интерполяция в логарифмическом масштабе частоты. Предельная
поправка — ±24 дБ. Подъём ослабленной полосы усиливает и находящийся в ней шум.
Во время набора АЧХ коррекция обходится, чтобы измерять исходный тракт.

Это относительная амплитудная калибровка. Она не измеряет фазу и не заменяет
калибровку абсолютного напряжения. Для каждого канала сохраняется своя кривая;
измеренные кривые, ноль и шум общие для пресетов, а включение коррекции входит
в пресет. Ноль и шум сохраняются при выключении прибора.

## Проверка в SIMULATION

При включённой SIMULATION режим сам перебирает 13 частот от 100 Гц до 1 МГц.
Для CH1 моделируется ФНЧ с частотой среза 100 кГц, для CH2 — 300 кГц.
На плате измерение проходит через обычный генератор отсчётов и обработчик захвата;
настольный симулятор использует тот же закон ослабления. После набора кривой
модель канала сохраняет это ослабление, и включение коррекции позволяет увидеть
его компенсацию на обычном сигнале генератора.

Кривые, ноль и шум SIMULATION хранятся отдельно от реальных данных обоих каналов.
Переключение SIMULATION останавливает текущий набор; тестовый проход не заменяет
измеренную характеристику. Обе пары кривых сохраняются при выключении прибора.

## Обработка

Канал хранит до 96 частотных точек; попадания в пределах 2% уточняют существующую
точку. Калибровка принимает выраженный тон, содержащий не менее трёх периодов
на интервале FFT, ниже 0,4 частоты отсчётов и без насыщения кодов АЦП.

Ноль и шум каждой ступени определяются по среднему и сумме квадратов четырёх
различных записей; повторно показанный кадр не увеличивает число измерений.
Переключение ждёт подтверждения панели после установки реле; кадры прежней
ступени не считаются новым измерением. Промежуточные диапазоны прохода
не заменяют пользовательский диапазон в сохраняемых настройках.
Автоматическое сглаживание использует локальные среднее и дисперсию окна
17 отсчётов и измеренную шумовую мощность. При локальной дисперсии не менее
девяти шумовых мощностей отсчёт сохраняется. FFT, исходная запись и статистика
ZERO/NOISE и калибровки АЧХ не проходят через это сглаживание. Measurements
и триггер используют обработку кривой. Отдельные raw_mean/raw_rms кадра
сохраняют несглаженную оценку для калибровки независимо от FILTER.
Сильные нативные Peak Detect выбросы с размахом более восьми RMS шума сохраняются,
чтобы автоматическое сглаживание не скрывало неразрешённый быстрый сигнал.
При оценке тона постоянная составляющая удаляется до FFT, поэтому смещение
нуля не становится частотной поправкой. Для RMS шума σ и FFT из N отсчётов
из квадрата амплитуды вычитается оценка шумовой мощности 6σ²/N для окна Ханна.
Это оценка для некоррелированного шума, а не удаление отдельных помех или
гармоник источника. Записи с дисперсией не выше 1,25σ² не добавляют точку АЧХ.

Коррекция выполняется обработчиком захвата над производной копией всей записи.
Данные дополняются отражением концов, преобразуются общим radix-two FFT,
умножаются на обратную амплитудную характеристику и возвращаются обратным FFT.
Исходная запись и источник триггера сохраняются; STOP и ZOOM пересчитываются
из той же записи. Затем применяется выбранный FILTER. У интервалов Peak Detect
неизвестно время экстремумов, поэтому они не проходят через частотную коррекцию
и не накладываются поверх исправленного следа.
