Coal56AB/Oscilloscope/docs/agents/FPGA_DSP.md

# Поточная обработка сигнала в ПЛИС

## Общий численный код

`signal_number_finite` проверяет binary32 по экспоненте IEEE-754.
Это исключает различие флагов Windows fpclassify и библиотеки HLS:
NaN/Inf не становятся допустимыми значениями при синтезе. Для double
на ПК сохраняется стандартный isfinite. Проверка общая для фильтров,
измерений и параметров аппаратного задания.

`signal_filter_trace` применяет тот же Wiener и ручной FILTER плитками по
256 отсчётов с полным соседним контекстом. Границы плиток не становятся
границами фильтра: учитываются радиусы обеих последовательных стадий.
Вход допускает коды со stride либо физические значения, выход всегда в
физических единицах. Рабочая память ограничена размером плитки, включая
записи 1M. `SignalNumber` выбирает double на ПК и float при синтезе.
Сдвиг окна добавляет и удаляет по одному отсчёту; обратные размеры окон
1..65 заданы константами. Циклы оценивания конвейеризованы без изменения
порядка накопления и правила сохранения фронтов.
Число элементов окна хранится в uint8_t: после удаления уходящего отсчёта
оно не превышает 65. Сумма байтов Wiener хранится в uint16_t;
даже промежуточное окно до удаления содержит не более 18×255=4590.
Длина всей записи и индексы от этих ограничений окна не зависят.

`SignalIndex` оставляет size_t в настольном API и использует uint32_t при
аппаратном повторном проходе. Синтез на 64-битном Windows не расширяет
индексы ограниченной записи до 64 бит. Целые моменты амплитуды сохраняют
uint64_t, а положение фронта по-прежнему вычитается до перехода во float.

`signal_measure.h/c` задаёт независимый от GUI API для экстремумов,
среднего, RMS, частоты и duty. `SignalTrace` описывает байтовые отсчёты
со stride и калибровкой либо массив значений в физических единицах.
Память рабочих периодов предоставляет вызывающая сторона; внутри
численного ядра нет malloc, qsort и указателей на функции.
Детектор из `signal_edges.h` сохраняет исходную пару пересечения и
вычисляет дробное время только после подтверждения фронта.

Настольная модель использует double. Для аппаратного повторного прохода
`SIGNAL_NUMBER_FLOAT` выбирает float в том же алгоритме: исходные моменты
сначала центрируются в целых числах относительно калиброванного нуля,
а суммы физических значений используют компенсированное накопление.
Это сохраняет малые уровни и RMS при ограниченном ресурсе ПЛИС.
В измерениях времени целые номера пересечений вычитаются до добавления
дробных частей. Абсолютный номер около 1M не округляется во float;
компенсированное накопление периодов и длительностей предотвращает дрейф duty.

`record_measure.c` синтезирует этот же численный модуль в ядро повторного
прохода по DDR. Явный формат выбирает uint8 со stride либо float в физических
единицах; адрес ноль не служит признаком формата. Ядро возвращает min/max,
среднее, RMS, частоту, duty, clipping и признак завершённого расчёта.
Нулевая частота выборки запрашивает только амплитудные статистики.
Операция FILTER возвращает Wiener и ручной FILTER в том же ядре,
используя общий `signal_filter_trace`. Первые восемь float результата
сохраняют заголовок завершения, затем следуют физические значения записи.
`record_trace` загружает байтовый блок 1024 байта либо 256 значений float
перед арифметическим циклом. Смешанная разрядность портов общего AXI
отключает автоматические burst для байтовых кодов; загрузка плитки
не гарантирует объединения этих чтений в burst. Состояние детектора и сумм сохраняется
между блоками, кэш сбрасывается для каждой новой записи.
Коды, физические значения и результат используют один AXI master к HP1:
ядро загружает плитку, обрабатывает её и записывает результат последовательными
фазами. SmartConnect с одним входом согласует ширину и AXI4/AXI3 без
арбитража трёх интерфейсов. Захват использует HP0, HDMI — HP2.
Частота ядра 100 МГц; карта регистров и численные операции не меняются.
Компаратор float имеет явную задержку 3 в HLS: регистры разделяют
сравнение и последующую управляющую логику. Значение 1 недостаточно для
этого ядра 2019.1 и оставляет сравнение комбинационным.

`depth=4096` задаёт размер адаптера RTL-стенда, чьи записи не превышают
1000 отсчётов. Это не ограничение адресов DDR или длины задания: runtime
и UAPI поддерживают прежние 1M. Полные записи отдельно проверяются
в C-модели и на устройстве.

Сборка `ZYNQ7020/build.ps1` сначала создаёт HLS IP, затем полную схему и FSBL.
Отдельное сравнение C/RTL запускается через
`vivado_hls -f ZYNQ7020/fpga/synthesize_measure.tcl -tclargs <build> xc7z020clg400-1 verify`.
Обычная сборка выполняет C-модель и синтез без повторной RTL-симуляции.
`package_hls.tcl` ограничивает переполненную календарную ревизию упаковщика
2019.1 в сгенерированном Tcl; установленный Vivado не изменяется.

Драйвер `/dev/oscill-analysis` предоставляет BEGIN/FINISH и совместимый
синхронный MEASURE для одной записи до 1M отсчётов. BEGIN копирует вход
в coherent arena до возврата, FINISH получает результат после IRQ.
Между ними CPU готовит экранную проекцию; численные результаты и график
публикуются вместе. Один дескриптор удерживает одну задачу до FINISH или
close, повторный BEGIN возвращает EBUSY даже после завершения аппаратуры.
Коэффициенты и результаты — биты IEEE-754 binary32, вычислений с float
внутри Linux нет. Закрытие fd дожидается незавершённой задачи; arena
принадлежит устройству и не освобождается при аппаратном тайм-ауте.
Перед первым MMIO драйвер проверяет capability bits 2/3 capture GPIO:
ядро повторного прохода и амплитудный режим без частоты. Старый bitstream
возвращает ENODEV. Банк управления — `0x43c20000`, IRQ —
F2P[2]. `analysis_zynq` подключает ядро к численному интерфейсу обработчика
кадра. Измерения исходной записи и видимой обработанной кривой выполняются
на ПЛИС; преобразование double/float относится к передаче данных.
Отсутствующее ядро сохраняет прежний программный режим. Ошибка активного
аппаратного расчёта завершает обработку с source_error без подмены расчётом CPU.

Capability bit 4 capture GPIO добавляет FILTER_RECORD. Его ioctl содержит
исходный trace, адрес выходных float, уровень и мощность шума через RMS.
Рабочая coherent arena занимает 16 MiB: коды в начале, физический вход
со смещения 2 MiB, заголовок и выход со смещения 6 MiB. Массив входа
полностью скопирован до запуска, поэтому пользовательские вход и выход
могут совпадать. Копирование выхода остаётся под блокировкой владельца.
Фильтрация синхронная; BEGIN/FINISH остаются численным асинхронным API.
Поле operation очищается при каждом MEASURE/BEGIN. Старый bitstream
не получает обращений к отсутствующим дополнительным регистрам.
GUI передаёт фильтрацию видимого интервала вместе с соседним контекстом
аппаратному executor. Его ошибка не заменяется программным фильтром.

Вычислительные модули находятся в `ZYNQ7020/fpga/`. Они работают в кодах
АЦП и не зависят от масштаба GUI, напряжения на щупе и протокола сигнала.
`valid` обозначает принятый входной отсчёт или группу. Паузы не добавляют
отсчётов; reset очищает историю и отменяет результаты в конвейере.
Настройки фильтров постоянны до следующего reset.

## Подавление шума

До формирования равномерного прореженного потока `axis_capture_decimate`
усредняет весь интервал исходных A/B. Деление суммы выполняется восемью
конвейерными шагами; глобальная остановка сохраняет все незавершённые точки.
Остаток переносится между результатами, поэтому дробный средний код не
создаёт сдвига нуля. Независимые min/max исходных точек передаются прежним
форматом Peak Detect. При полной частоте входные A/B остаются неизменными.

`signal_wiener` принимает uint8-код центра, сумму 17 точек и величину
`17*sum(x*x)-sum(x)*sum(x)`. Шумовая мощность имеет формат Q16.16,
результат — Q8.16. Для дисперсии не выше шумовой мощности используется
среднее. При дисперсии не ниже девяти шумовых мощностей сохраняется
исходный отсчёт. Между ними применяется тот же вес Wiener, что в
`signal_filter_denoise_u8`; вес вычисляется с 24 дробными разрядами.
Модуль принимает один отсчёт за такт, без изменения последовательности.

## Ручной FILTER

`signal_boxcar` принимает две или четыре последовательные точки одного
канала в Q8.16 и абсолютный номер первой точки. Уровни 0…3 означают
длины окна 1, 5, 17 и 65. В истории сохраняются предыдущие точки,
скользящая сумма обновляется для каждой точки группы. Выходной номер
уменьшен на радиус окна: аппаратная задержка не смещает время сигнала.
Точки без полного левого контекста исключаются маской `result_mask`.
Оставшиеся значения округлены к ближайшему разряду Q8.16.

`signal_mean` выполняет деление суммы на выбранную длину окна. Общий
конвейер radix-4 используется всеми четырьмя точками группы; каждая точка
имеет отдельный экземпляр делителя. Непрерывный поток не ожидает окончания
деления предыдущей группы.

## Фронты и взвод триггера

`signal_edges` подтверждает переход через обе стороны гистерезиса,
сохраняя исходную пару точек пересечения уровня. До четырёх событий группы
выдаются по порядку. Время события представлено точной дробью
`base + numerator/denominator`. Долгое пребывание внутри полосы не меняет
первоначальное пересечение. Разрыв абсолютных номеров очищает состояние;
пауза передачи при смежных номерах его сохраняет.

`signal_trigger` соединяет Wiener, ручной FILTER и поток фронтов одного
выбранного канала. Новый `arm_id` разрешает одно событие выбранного
направления с номером не меньше `minimum_sample` и с учётом holdoff от
предыдущего принятого события. Пересечение округляется к ближайшему
исходному отсчёту. Результат удерживается до нового взвода; более поздние
фронты его не заменяют. Кандидаты несут ID взвода через конвейер, поэтому
результат старого взвода не может завершить новый.

## Настройки DSP

`capture_dsp_config` содержит восемь staging-регистров AXI-Lite. Они задают
режим, шумовую мощность, уровень, гистерезис, начальный отсчёт и holdoff.
Запись нового `arm_id` в COMMIT фиксирует все восемь слов и переносит их
в домен АЦП одним обновлением. Пока подтверждение не вернулось, повторный
COMMIT отвергается; редактирование staging не меняет уже передаваемый набор.
Каналы адреса и данных AXI принимаются независимо.

Linux UAPI `OSC_CAPTURE_SET_DSP` передаёт этот набор без изменения DMA-буферов
и допускает взвод при существующих leases. Перед доступом к дополнительному
банку драйвер проверяет capability bit 1 прежнего capture GPIO. Старый
bitstream оставляет его нулевым: дополнительного MMIO-чтения не происходит,
а ioctl возвращает ENOTTY. Отображение MMIO само по себе не обращается к PL.

`axis_capture_frame` подключает этот тракт к статистике входного потока.
При включённом DSP заголовок TRG1 содержит ID взвода, его настройки и
зафиксированный номер первого разрешённого пересечения. Заголовок целиком
фиксируется до передачи первого слова и не смешивает разные взводы.
Банк AXI-Lite расположен по `0x41220000`; capture GPIO и DMA сохраняют адреса.

В аппаратном режиме acquisition использует номер из TRG1 без программного
поиска фронтов. Тихие payload удерживаются как контекст; перед показом
распаковывается полная выбранная запись с предысторией и участком после фронта.
Взвод следующего события не останавливает DMA. Две стадии подготовки и показа
не позволяют следующему событию заменить ещё не показанное.
Если выбранная глубина больше payload, перед первым массовым декодированием
удерживается достаточная смежная цепочка encoded leases. Проверяются sequence,
абсолютные номера, Fs и формат пиков; уже декодированная смежная история
тоже учитывается. Это исключает бесконечный срыв неполной записи, когда
распаковка одного payload медленнее прихода следующего. AUTO и FORCE
используют тот же сборщик полной аппаратной записи.

MMX1/2/3 и программный детектор остаются для прежнего bitstream, настольных
источников и специальных режимов. Основные численные Measurements подключены
к ядру DDR replay вместе с Wiener/FILTER принятой записи. Расширение экстремумов
native Peak Detect, коррекция АЧХ, FFT и экранная проекция пока остаются
на ARM. Наличие аппаратного триггера и измерений не завершает весь перенос.
