Coal56AB/Oscilloscope/ZYNQ7020/gui/DEVELOPMENT.md

# Интерфейс отрисовки

`scope_screen_render(uint32_t *pixels, int stride, const ScopeScreen *screen)` рисует весь кадр. `stride` — количество 32-битных пикселей в строке, минимум 1024. Слово пикселя имеет формат `0x00RRGGBB`; для контроллера с другим порядком байтов нужен перевод при передаче кадра.

Каждый массив `ch1_samples` и `ch2_samples` содержит ровно `SCOPE_PLOT_WIDTH` (`1024`) значений `int16_t`. Элемент соответствует одному горизонтальному пикселю области графика. Значение 0 находится у её верхней границы, `SCOPE_PLOT_HEIGHT - 1` (`479`) — у нижней. Значения за границами при отрисовке прижимаются к краям. Указатель может быть `NULL`, если сигнал ещё не получен. Флаги `ch1_enabled` и `ch2_enabled` управляют видимостью каналов. `ch1_min_samples`/`ch1_max_samples` и аналогичные поля CH2 задают диапазон Y каждого столбца. При наличии обоих массивов рендерер рисует вертикальный отрезок диапазона и соединяет только непересекающиеся соседние диапазоны; отдельная линия средних значений не добавляется. В raw-процессоре минимум и максимум берутся из всех исходных отсчётов интервала столбца, включая неполные интервалы по краям. Демо-генератор вычисляет диапазон непрерывной формы по границам интервала и её экстремумам, поэтому медленная развёртка не требует перебора множества периодов. ZOOM сохраняет диапазоны вместе с обзорным кадром.

Строковые поля структуры должны существовать до завершения вызова. Рендерер поддерживает латинские заглавные буквы, строчные `u s k z m x n` для единиц измерения, цифры и знаки `. : - + / * _ %`. Остальные строчные буквы отображаются заглавными. Поле `font_index` выбирает `SCOPE_FONT_PIXEL` или `SCOPE_FONT_INTER`. Сглаженный атлас Inter встроен в `src/scope_font_smooth.h`; исходный TTF и лицензия лежат в `src/fonts/`, а `src/fonts/generate_font.py` пересоздаёт заголовок. При работе на устройстве нужны только готовый заголовок и C-рендерер. `src/demo_signal.c` создаёт демонстрационные данные и хранит текущую логику меню и управления; приложение Zynq использует эту логику через SDL frontend.

Рендерер использует стандартную библиотеку C без вызовов Windows. Он получает готовое состояние каналов, меню, курсоров и триггера через `ScopeScreen`. Оконное приложение и изображение физических органов управления находятся в `src/preview_win32.c` и `src/panel_win32.c`; `src/demo_signal.c` моделирует их действия и создаёт демонстрационные отсчёты. Win32-приложение принимает прямые события WM_POINTER на LCD и оставляет мышь для панели управления и настольной проверки касаний. Оно ищет отдельный неосновной дисплей ровно 1024×600, размещает на нём окно LCD без рамки, а окно управления — на основном мониторе. Win32 frontend и панель не входят в приложение Linux; `demo_signal.c` остаётся частью его интерфейса. Измерения и аппаратные данные в интерфейс передаёт вызывающая сторона.

`trigger_y` задаёт применённый уровень. Пока `trigger_preview` установлен, `trigger_preview_y` показывается пунктиром и применяется нажатием энкодера TRIGGER или отпусканием касания указателя справа. `trigger_source_channel` выбирает цвет обеих линий, а `trigger_edge_falling` и `trigger_edge_both` — знак фронта в карточке триггера. `trigger_locked` указывает, что фронт найден и выровнен по `trigger_marker_x`; без него в AUTO индицируется свободный ход. `cursor_a` и `cursor_b` относятся к горизонтальным координатам в режиме времени и к вертикальным в режиме напряжения; напряжение рассчитывается для обоих каналов.

`menu_labels` и `menu_values` содержат до `SCOPE_MENU_ITEMS` строк при открытом меню; `menu_options`, `menu_option_count` и `menu_option_selected` задают варианты в сегментированных переключателях, а `menu_stepper` отмечает числовой пункт с кнопками изменения. `menu_x` и `menu_y` задают фактическую позицию перетаскиваемого окна. Каждое открытие меню или подменю центрирует окно по его текущей высоте. Перетаскивание действует до следующего открытия; настройки и подтверждения рисуются после графика, измерений и обеих панелей.

`measurement_menu` разворачивает каталог на всю область графика. `measurement_count`, `measurement_labels` и `measurement_values` задают до `SCOPE_MEASURE_SLOTS` (10) измерений каналов в переносимой таблице. `measurement_clear_confirm` и `measurement_clear_choice` управляют подтверждением очистки списка. `measurement_hidden` закрепляет шапку таблицы снизу, сохраняя набор выбранных измерений и прежнее положение развёрнутой таблицы. Её координаты и компоновку задают `measurement_x`, `measurement_y` и `measurement_horizontal`; `scope_screen_measurement_bounds()` возвращает фактический прямоугольник с учётом краёв. `scope_screen_measurement_bottom()` ограничивает низ таблицы верхом строк курсоров только при пересечении по горизонтали. Справа от них таблица опускается до `SCOPE_MEASURE_BOTTOM_Y`; при расширении поднимается над курсорами. Вертикальная таблица ограничена шириной содержимого, горизонтальная занимает ширину графика при пяти измерениях, при меньшем числе сжимается и распределяет доступную ширину пропорционально содержимому столбцов. `cursor_measurement_count` и `cursor_measurement_labels` задают столбцы, `cursor_measurement_rows` — число строк, а `cursor_measurement_values[row][column]` — значения. В режиме напряжения выводится общая таблица из двух строк CH1/CH2 с A, B и ΔV, общей внешней рамкой, внутренним разделителем и узкой первой колонкой с подписями CH1/CH2; в режиме времени — одна с A, B, ΔT и частотой 1/ΔT. Первая колонка содержит TIME либо CH1/CH2; подписи и линии курсоров имеют единый фиолетовый цвет. Режим напряжения в интерфейсе называется VERTICAL. `scope_screen_cursor_measurement_bounds()` возвращает общий прямоугольник строк для отрисовки и hit zones; ширина столбцов одинакова в обеих строках и учитывает самое длинное значение. `cursor_selected` выбирает A, B или FFT. При включённом FFT короткое нажатие FUNC проходит цикл A → B → FFT → A, иначе A → B → A. Вращение двигает выбранный курсор; для FFT шаг составляет 8 позиций, в FINE — одну. При выключении FFT или курсоров выбор FFT возвращается к A. В карточке сохраняется режим TIME/VERTICAL, отдельно справа от заголовка отображается выбор A/B/FFT. Касание спектра перемещает и выбирает существующий курсор FFT; курсоры A/B остаются независимыми. Числовые показания A/B, ΔT/ΔV и частоты выводятся с четырьмя цифрами и подходящей единицей: `2.000 us`, `22.00 us`, `222.0 us`, `0.625 V`. При нулевой разности времени частота остаётся `--`.

`fine_mode` замедляет относительные перемещения энкодерами и сенсором, но не меняет шаг выбора пунктов меню или масштаба. `status_visible` включает краткое сообщение `status_message`; `status_warning` задаёт красный цвет ошибки, а `status_alpha` — прозрачность при исчезновении. Минимальный масштаб шрифта интерфейса — `SCOPE_MIN_TEXT_SCALE`. Поля `ch_position_mode`, `time_position_mode` и `horizontal_position` управляют индикацией режима энкодеров и положения захвата.

Для окраски по плотности `history_ch1_samples` и `history_ch2_samples` указывают на последовательные кадры по `SCOPE_PLOT_WIDTH` отсчётов; `history_count` задаёт их число. При `intensity_coloring` рендерер строит для каждого столбца взвешенную гистограмму по высоте из накопленных кадров. Необязательные `history_ch1_min_samples`/`history_ch1_max_samples` и поля CH2 содержат диапазоны в том же порядке кадров. Вес максимален внутри диапазона (либо в точке отсчёта без этих массивов) и линейно снижается снаружи в радиусе 18 пикселей; вертикальные перепады тоже вносят небольшой вклад. Значение гистограммы нормируется на число кадров и отображается палитрой от синего для редких участков до красного для частых. В режиме ZOOM `capture_ch1_samples` и `capture_ch2_samples` указывают на полный кадр, а `ch1_samples` и `ch2_samples` — на текущий увеличенный фрагмент. Координаты `zoom_window_start` и `zoom_window_end` задают выделение в верхнем обзоре полного кадра. Все массивы содержат `SCOPE_PLOT_WIDTH` отсчётов. При `fft_enabled` верхняя область использует `fft_ch1_bins` и `fft_ch2_bins` по `SCOPE_FFT_BINS` значений 0–255 и девять подписей `fft_frequency_labels` поверх нижней части графика без выделенной полосы, привязанных к делениям оси частот. Логарифмическая ось частот идёт от Fs/1024 (первой положительной частотной точки FFT) до Fs/2; DC в эту ось не входит. Подписи содержат число и приставку (`1k`, `2.18k`, `512k`). `demo_signal_set_fft_range()` задаёт предел и строку `fft_sampling_info`: FS — частота дискретизации, DF — расстояние между частотными точками FFT, равное Fs/1024. Для демо Fs = 1024 / (10 × time/div), для raw-захвата адаптер использует фактическую частоту дискретизации. При 100 us/div демо показывает 1k–512k, FS 1.024M и DF 1k. Если заданная основная частота демо-генератора достигает Fs/2, появляется отметка ALIAS; увеличение скорости развёртки повышает предел. Это условие относится к основной частоте, не ко всем гармоникам формы. Общий `spectrum_bins.h` задаёт логарифмические позиции шкалы и распределяет все 512 положительных частотных точек между 128 отображаемыми позициями. Внутри каждой группы берётся максимум, поэтому узкие пики не теряются. Когда промежуток между позициями меньше шага FFT, используется ближайшая частотная точка.

В режиме TIME курсор FFT вертикальный: `fft_cursor_x` задаёт позицию, частота вычисляется по той же логарифмической шкале; подпись располагается сверху справа или слева от линии. В режиме VERTICAL курсор горизонтальный: `fft_cursor_level` задаёт уровень 0–255, соответствующий −80…0 dB; подпись располагается у правого края. `scope_screen_fft_level_at()` преобразует экранную координату Y в уровень по геометрии спектра. `fft_cursor_visible` вычисляется из включённого FFT и режима курсоров TIME/VERTICAL: линия появляется вместе с курсорами и скрывается при OFF. Касание при OFF её не включает. `fft_cursor_value` задаёт показание с четырьмя цифрами. Линии занимают всю высоту/ширину области FFT. При касании и перетаскивании вызывается `demo_signal_ui_move_fft_cursor()`; разделитель, таблицы и открытое меню сохраняют приоритет. Для демо амплитуда FFT вычисляется как 20 log10(A/Amax) отдельно для каждого канала, где 0 dB — максимум его спектра. Для raw 0 dB соответствует полной шкале АЦП, окно Ханна учитывается в нормировке. Среднее значение удаляется до FFT, поскольку DC не отображается. `split_height` задаёт высоту верхней области от начала графика и используется для ZOOM и FFT; приложение ограничивает её 70–250 пикселями. FFT рассчитывается по 1024 отсчётам с окном Ханна и radix-2 FFT: в `src/demo_signal.c` — по текущим демо/CSV-отсчётам, в `capture_processor.c` — по первым 1024 raw-отсчётам выбранного окна, с дополнением нулями короткого окна. DF обозначает шаг FFT, а не гарантированное разрешение двух близких пиков; окно и объединение частотных точек влияют на их разделение.

В подписях `measurement_labels` префиксы `CH1 ` и `CH2 ` определяют цвет измерения, но не выводятся в переносимой таблице. Расчёт ширины столбцов использует эту же сокращённую подпись. В каждом столбце ширина области названия берётся по самому длинному названию; значения начинаются на одной вертикали без видимого разделителя.

Просмотр BMP использует `browser_visible`, `browser_title` и `browser_pixels` размером 1024×600. Пиксели копируются без масштабирования, а нижняя строка содержит кнопки перелистывания и выхода. CSV загружается в `DemoWaveCapture` через `wave_file_read()`, затем `demo_signal_ui_show_wave()` показывает его в обычном режиме осциллографа с остановленным захватом. `waveform_loaded` переключает подпись RUN на BACK; исходные отсчёты остаются в `loaded_wave`, а экранные отсчёты пересчитываются при перемещении, масштабировании и ZOOM. Смещение CSV хранится в пикселях экрана и переводится в координаты исходных отсчётов с учётом текущего масштаба. Нажатие BACK возвращает снимок состояния живого режима, сохранённый Windows-приложением перед открытием файла. Развёртка выбирается по ряду 1–2–5 от 500 ns/div до 1 s/div. При открытии CSV физическое значение `time_us_per_div` определяет масштаб независимо от прежнего индекса `time_index`. `wave_file_write()` сохраняет отсчёты и метаданные; чтение также принимает прежний CSV с одним заголовком и строками отсчётов. Меню PC CONNECTION в симуляторе не открывает транспорт и всегда показывает `NO LINK`.

`channel_zero_y[0]` и `[1]` задают координаты меток 0 В на левой кромке графика. Они не вычисляются из отсчётов сигнала: при изменении фазы метки остаются неподвижными, а вертикальное смещение канала передаётся вызывающей стороной через эти координаты.

Демо-генератор предлагает 1, 2, 5, 10, 20, 50, 100, 200, 500 kHz и 1 MHz для обеих форм каналов.

В симуляторе `src/demo_signal.c` при наличии пересечения применённого уровня выбранным фронтом формирует окно вокруг этого пересечения и ставит фронт на `trigger_marker_x`. Уровни сглаживания в `src/demo_signal.c` применяют скользящее среднее отдельно к CH1 и CH2; история из восьми кадров даёт данные для окраски по плотности. К отсчётам при каждом новом захвате добавляется детерминированный шум в пределах ±3 пикселей; при остановке массивы не меняются. В режиме AUTO без пересечения осциллограмма идёт без синхронизации; NORMAL и SINGLE оставляют предыдущий кадр и ждут. Принудительный запуск формирует один несинхронизированный кадр. В ZOOM отсчёты берутся из полного кадра, который обновляется во время RUN, а положение его триггера сохраняется отдельно. Демонстрационный каталог содержит 16 расчётов по каналам в двух колонках; одновременно можно добавить десять. Амплитудные статистики вычисляются из текущих отсчётов, временные и курсорные — из параметров развертки и положения курсоров; частота, период и заполнение соответствуют заданному генератору прямоугольного сигнала.

## Zynq и исходные выборки

Переносимые raw источники, кольцо, обработчик, UART и Linux backend описаны в [архитектуре устройства](../../docs/agents/ARCHITECTURE.md). API и форматы — в [CAPTURE_INTERFACE.md](../../docs/agents/CAPTURE_INTERFACE.md) и [CONTROL_PROTOCOL.md](../../docs/agents/CONTROL_PROTOCOL.md). Обязательные данные платы и границы подтверждённых функций — в [BOARD.md](../../docs/agents/zynq7020/BOARD.md) и [DECISIONS.md](../../docs/agents/DECISIONS.md).

Linux frontend сохраняет рассчитанные демо/CSV min/max при отсутствии raw capture; перед отрисовкой он привязывает соответствующие массивы вместо перехода к одиночным точкам. Это же поведение проверяется через `draw_all()` на 10 ms/div, включая возврат из raw frame.

`linux_storage.c` отвечает за доступ к каталогу экспорта. В штатном Linux-запуске `--require-data-device` требует файловую систему на присутствующем блочном устройстве: каталог в initramfs/tmpfs не подходит. Открытый directory fd удерживается на всё сохранение; BMP/CSV открываются через `/proc/self/fd/`, поэтому размонтирование не перенаправляет запись в подлежащий каталог RAM. После закрытия файлов выполняется `syncfs()`; успех показывается только после него. Без носителя выводится `NO DATA CARD`, при ошибке записи — `SAVE FAILED`. Обычный SDL-предпросмотр без этого флага сохраняет в выбранный каталог, Windows не затронут.

## Скругление и заставка

`SCOPE_PANEL_RADIUS` задаёт 5 px для карточек верхней и нижней панелей, `SCOPE_WINDOW_RADIUS` — 10 px для окон, их серых заголовков и кнопок. `rounded_box.c` сохраняет фон только в углах виджета. После обычной отрисовки содержимого применяется маска с 8×8 субпиксельным покрытием и однопиксельная рамка. Рамка и цветные полосы используют геометрию всего виджета; координаты содержимого и hit zones от радиуса не меняются. Вложенный виджет завершается раньше родительского. Радиус ограничен половиной ширины/высоты, максимум 32 px. RUN/STOP полностью заполняются зелёным/красным, BACK при просмотре CSV — жёлтым.

Исходное положение Measurements и начало строки Cursor — x=0; переносимая таблица по-прежнему свободно перемещается. При изменении геометрии строки hit zone в обоих frontend должна совпадать с `scope_screen_cursor_measurement_bounds()`.

`logo/boot_splash.c` рисует логотип на фоне `BOOT_SPLASH_BACKGROUND` без выделения памяти и платформенных вызовов. Один модуль используется FSBL и Windows-предпросмотром. FSBL запускает видео в `FsblHookAfterBitstreamDload()` после снятия reset PS/PL, до чтения U-Boot; повторный вызов перед handoff не перезапускает VDMA/VTC. На время заполнения framebuffer включается D-cache, затем данные сбрасываются в DDR и восстанавливается исходное состояние кеша. Маркер `SPLASH_READY` в UART обозначает готовый видеопоток; время обнаружения HDMI самим монитором измеряется отдельно. Исходный PNG сохранён без изменений в `logo/boot-logo.png`; `logo/generate_logo.py` с Pillow компилирует маску в `logo/boot_logo_data.h`. Обычная C-сборка не требует Python/Pillow и не обращается к исходному PNG.

Для визуального сравнения Windows frontend принимает `--windowed`, `--fft`, `--cursors`, `--menu main|debug|measurements|processing|ch1`, `--snapshot <путь.bmp>` и `--splash`. Повторный `--cursors` включает режим напряжения с двумя строками. `--splash` показывает заставку 3 секунды перед GUI; с `--snapshot` сохраняет заставку сразу. Эти параметры не меняют обычный запуск с отдельным LCD.

Курсор FFT в FINE перемещается касанием в четыре раза медленнее; дробный остаток движения сохраняется до следующего события. Первое касание выбирает курсор без скачка к пальцу. Общий расчёт в demo_signal_ui_drag_fft_cursor используется WinAPI и SDL; энкодер сохраняет шаг 1 вместо 8.
