Coal56AB/Oscilloscope/TERMINAL/requirements-build.txt

-r requirements.txt
Nuitka==2.8.10
ordered-set==4.1.0
zstandard==0.21.0
