Coal56AB/Oscilloscope/docs/PERFORMANCE.md

# Производительность

Скорость обновления зависит от частоты выборки, глубины записи, режима обработки и частоты событий триггера. Уменьшение видимого участка по времени само по себе не означает уменьшения всей записи или потока данных.

Расчёт пропускной способности и памяти находится в [техническом бюджете](agents/PERFORMANCE.md), условия и результаты выполненных замеров — в [журнале проверок](agents/TESTING.md). Расчётные пределы и аппаратные измерения в этих документах указаны отдельно.
