Coal56AB/Oscilloscope/docs/agents/TESTING.md

# Выполненные проверки

## 27.10.2026 — ширина ROLL и повторная матрица режимов

На приборе при 500 мс/дел и 100K начальное заполнение выросло до 1024
валидных колонок. Положения −420/−210/0/210/420 и 12 быстрых перемещений
между краями сохранили все 1024 колонки, без source_error и новых пропусков
DMA во время перемещений. Снимки обоих крайних положений просмотрены.
Аппаратный mock воспроизводит разрыв последовательности и запрещает замену
полного кадра коротким хвостом; после накопления истории вывод возобновляется.
Проверены также начальное заполнение, смещение и STOP на сохранённой записи.

Linux Release: 17/17; Windows Release: 9/9. ASan/UBSan фильтров и анализа,
затем аппаратного backend прошли. После добавления проверки граничных
значений time_position повторно прошли frontend и backend.

После исправления NaN два полных прохода на приборе включали все пять
глубин, 20/50/100/200 мкс/дел, четыре FILTER, CH2, FFT и RUN/STOP.
FILTER → OFF после смены глубин в обоих проходах не завис. Возврат FILTER
в STOP восстановил тот же экранный CSV. source_error оставался нулевым.
Снимки четырёх развёрток просмотрены: прежнего резкого увеличения шума
на промежуточном масштабе не наблюдалось.

При 100K, CH1, FILTER MEDIUM, FFT OFF и NORMAL/FALLING средний интервал
показа за отдельные 10 секунд без промежуточного опроса составил:
20 мкс/дел — 111,98 мс; 50 — 141,19 мс; 100 — 116,16 мс; 200 — 111,22 мс.
Это измерение текущего входного сигнала, не гарантия для любого режима.
Цель не более 100 мс на всех развёртках ещё не достигнута; DMA-пропуски
на старших частотах остаются, аппаратные задания анализа не пропускались.

## 27.10.2026 — классификация float в HLS

Проверка binary32 заменила Windows isfinite в общем численном коде.
Отдельный набор, воспроизводивший распространение NaN, прошёл C/RTL;
полный набор из 24 транзакций тоже прошёл. Он включает отказ NaN/Inf
в параметрах и постоянный уровень с пропусками в 0/255/256.
Полная реализация при 100 МГц: setup +0,075 нс, hold +0,013 нс,
43 686 LUT после размещения.

На плате FILTER_RECORD прошёл оба канала, все уровни, форматы raw/physical,
1..1M, края плиток, NaN в 255/256/4096 и DC. Максимальная ошибка относительно
независимой double-модели — 9,918105e−7 В; на DC ошибка нулевая.
После FILTER_RECORD прежний набор Measurements прошёл 1K..1M, оба канала,
малый DC, дробный duty 64,352943%, BEGIN/FINISH, владение и повторное открытие.

## 27.10.2026 — конвейер сравнений и ограничение окна

После FCmp latency=3 и ограничения размеров окна полная реализация
дала setup +0,147 нс и hold +0,014 нс при прежних 100 МГц. Размещение —
43 980 LUT. Предыдущие варианты с setup −0,206 и −0,475 нс отклонены.
17 прежних C/RTL транзакций прошли, на плате Measurements прошли
1K..1M, оба канала, физический вход, малый DC и асинхронное владение.

Аппаратная проверка FILTER_RECORD обнаружила NaN вне исходного пропуска:
на физическом входе 257 точек с NaN в 255/256 уже точка 247 стала NaN.
Добавленный отдельный RTL-набор с постоянным 0,125 и пропусками 0/255/256
тоже не прошёл, тогда как C-модель прошла. Макрос Windows isfinite
использует бит 0x0100 результата fpclassify; классификация библиотеки HLS
имеет другие значения. Исправление этой проверки проверяется отдельно.

Проход развёрток и глубин прошёл; при первом переключении FILTER OFF
после глубин не было трёх новых показов за 8 с. Отдельный повтор OFF
дал непрерывные показы без source_error. Причина единичного останова
не подтверждена; полную матрицу необходимо повторить после исправления NaN.

## 27.10.2026 — общий AXI интерфейс ядра записи

Вариант с единым record_memory прошёл C/RTL для всех 17 транзакций:
сырые коды, физические значения, Measurements, Wiener и четыре FILTER.
Карта управления сохранена. Полная схема с тремя интерфейсами после
уменьшения индексов разместилась в 46 753 LUT, но маршрутизация осталась
сильно перегруженной; её запуск остановлен до получения bitstream.
Объединение интерфейсов проверяется полной реализацией отдельно.

## 27.10.2026 — разрядность индексов и конвейер окон

Первая полная реализация FILTER_RECORD не разместилась: при размещении
понадобилось 56 765 объединённых LUT и 1367 control sets. Такой bitstream
не загружался. В аппаратном повторном проходе индексы отделены от size_t
Windows; окна обновляются одним добавлением и удалением, коэффициенты
1/count берутся из таблицы для допустимых размеров 1..65.

Повторное C/RTL сравнение — PASS для всех 17 транзакций. В этом наборе
максимальная задержка сократилась со 159 869 до 57 269 тактов; это
симуляция, не замер скорости экрана. Отдельный синтез ядра дал 17 725 LUT
вместо 20 583. Linux Release — 17/17; ASAN фильтра и аппаратного backend —
2/2. Полная реализация и замеры прибора проверяются отдельно.

## 27.10.2026 — фильтрация принятой записи в ядре DDR replay

FILTER_RECORD соединяет общий Wiener и ручной FILTER в ПЛИС. C/RTL
сравнение завершило 17 транзакций, включая прежние Measurements и оба
формата фильтра. Регистры operation/level/noise в экспортированном IP:
0x58/0x60/0x68. Рекламирование legacy/Measurements/FILTER и синхронный
overflow проверены отдельным capture_status_tb.

На ПК сопоставлены значения обоих каналов, записи до 1M, края плиток,
NaN, малый DC, Peak Detect, плотность, обработанный физический вход и
отказ фильтра. Численные допуски прежние; для координат фильтрованного
сигнала допускается один пиксель при попадании float по другую сторону
целочисленной границы. Нефильтрованные координаты совпадают точно.
Linux Release — 17/17, Windows Release — 9/9, ASAN — 15/15.
Аппаратные замеры FILTER_RECORD фиксируются отдельно после загрузки ядра.

## 27 октября 2026 — непрерывное обновление AUTO на 1M

Строгий проход режимов выявил остановку показов на 1M/AUTO/200 MSa/s:
за 12 с счётчики входных блоков росли, новых кадров не было. Декодирование
отдельного неполного payload приводило к потере следующих блоков и сбросу
истории раньше набора полной записи. Теперь перед массовой распаковкой
удерживается смежная цепочка leases достаточной длины; разрывы не склеиваются.

В mock добавлены пропуски входных sequence после каждого большого decode.
Полная запись 1M собирается в AUTO/FORCE, raw/peak; прежние проверки первого
фронта, предыстории, позднего фронта и старого источника проходят. Выбранная
серия ASan/UBSan прошла. На плате 1M/AUTO при 200 MSa/s за 12 с дал около
44 новых показов, source_error=0; это устранение остановки, не 100 мс на 1M.
Повторный проход всех пяти глубин, четырёх развёрток, FILTER, CH2 и FFT
дожидался трёх новых показов и нужной Fs с правильным raw/Peak Detect.
STOP → FILTER OFF/HIGH/OFF вернул побайтово тот же CSV, RUN возобновился.

## 27 октября 2026 — параллельные измерения и подготовка графика

BEGIN/FINISH проверены в C-модели обработчика: проекция выполняется между
запуском и получением результата, вход остаётся действителен до FINISH.
Проверены исходные/обработанные массивы до 1M, ошибки запуска и получения,
без нового кадра и без программной подмены. Linux 17/17, Windows 9/9,
ASan/UBSan 15/15. На плате запуск 1M вернулся за 4,6 мс; изменение входного
массива после BEGIN не повлияло на результат. Повторные BEGIN/MEASURE до
FINISH дают EBUSY, лишний FINISH — EAGAIN, close дожидается своей задачи.

Четыре десятисекундных интервала при 100K дали 111/122/114/106 мс
на 20/50/100/200 мкс/дел против 112/145/126/111 мс синхронного пути.
source_error=0; на 200 MSa/s отмечено три dsp_missed. Цель ≤100 мс во всех
этих режимах пока не достигнута, захват всех событий не подтверждён.
Шесть DMA-прогонов параллельно с двенадцатью полными сериями вычислений:
399,62–400,14 МБ/с при 200/100 MSa/s и 200,06–200,07 МБ/с при 50 MSa/s.
Leases неизменны, аппаратный overflow не установлен; первый прогон
200 MSa/s содержит 6 sequence gaps, остальные пять — без пропусков.

## 27 октября 2026 — точность duty на полной обработанной записи

Дополнительный случай 1M с FILTER выявил 64,368370% вместо 64,352941%
в модели double. Целые позиции пересечений теперь вычитаются отдельно
от дробных частей, суммы периодов, ширин и квадратов накапливаются
с компенсацией. Полный случай прошёл интеграционное сравнение float/double;
отдельный C-стенд с дробным фронтом на 1M также прошёл с допуском 0,0001%.
Полная Linux-серия после исправления — 17/17. Дополнительное сравнение
C/RTL с дробным фронтом прошло; полная FPGA дала WNS 0,018 нс, WHS 0,024 нс.
На плате для 1M получено duty 64,352943% при ожидаемом 64,352941%.

## 27 октября 2026 — ядро повторного прохода по DDR

HLS C-модель и RTL co-simulation сопоставлены на DC, меандре 11 кГц/33%,
сыром и независимом обработанном массиве, частоте Найквиста, большом числе
периодов, шумовом входе, пустом диапазоне и недопустимой длине. Для RTL
используются 1K точек, C-модель дополнительно охватывает 10K. После
возврата из RTL численные проверки C повторно прошли; один статус
симулятора без сравнения результатов не считается подтверждением.
Штатный HLS-путь без co-simulation также сформировал IP и ready-маркер,
включая локальное исправление переполненной календарной ревизии 2019.1.

Linux с новым драйвером запущен на плате с прежней ПЛИС: открытие
`/dev/oscill-analysis` вернуло ENODEV, захват продолжил работу. После
перезагрузки и восстановления PL USB-панель потребовала переподключения
драйвера ci_hdrc.0 через sysfs; после этого перечисление USB и GUI
восстановились. Это обслуживание отладочной смены PL, не изменение
пользовательского запуска. При 100K общий численный модуль дал интервалы
115/128/115/108 мс на 20/50/100/200 мкс/дел за десятисекундные замеры,
source_error=0; на двух старших частотах по одному dsp_missed.

Первая полная реализация ядра измерений прошла timing WNS 0,147 нс,
WHS 0,019 нс. На плате получены правильные min/max, среднее, RMS,
11 кГц, duty 33/67% для двух каналов и независимого обработанного массива
на всех глубинах 1K/10K/100K/1M. Проверены малый калиброванный DC,
пустой диапазон, границы ioctl, exclusive open, IRQ и повторное открытие.
Измеренная задержка этой первоначальной реализации — 123–142 мс на 100K
и 1,23–1,34 с на 1M: индивидуальные чтения DDR ограничивали скорость.
После блочного доступа C/RTL co-simulation снова прошла. Полная схема
дала WNS 0,047 нс, WHS 0,018 нс. На плате с остановленным GUI правильные
результаты повторены на 1K…1M: 100K занимают 36,2–36,5 мс для кодов,
54,4 мс для физических значений и 3,65 мс без поиска периодов. Для 1M
получены 360/540/36 мс соответственно. Условия нагрузки отличаются от
первоначального замера с работающим GUI; сравнение полного показа приведено ниже.

GUI с аппаратными измерениями проверен на Windows 9/9, Linux 17/17 и
санитайзерной сборке 15/15. Float-модель ядра включена в интеграционную
проверку: оба канала, 1K/100K/1M, четыре FILTER, подавление шума, малый DC,
clipping, скрытый канал и пустой видимый участок. Числа совпадают в заданных
допусках, координаты кривой и исходные коды неизменны. Отказ ioctl в pipeline
даёт source_error без нового кадра и без программного повторного расчёта.
На приборе за десятисекундные интервалы при 100K получены 112/145/126/111 мс
на 20/50/100/200 мкс/дел, source_error=0, dsp_missed=0. Синхронный расчёт
в ПЛИС пока последователен с подготовкой графика и не ускоряет весь показ.

## 27 октября 2026 — общий численный модуль измерений

После выделения `signal_measure` и общего детектора: Windows Release 9/9,
Linux Release 16/16, санитайзерная сборка 14/14; изменённые модули
скомпилированы ARMv7/NEON. Сохраняются проверки стабильной частоты,
напряжений, узких импульсов, шумового входа и больших записей.

## 27 октября 2026 — шум на переходах развёртки

Прореживание проверено общей серией из 20 RTL-стендов и отдельным сквозным
стендом decimator → статистика → Wiener/FILTER → TRG1. Проверены все
19 прореженных частот, максимальные суммы, дробный DC, обе ветви АЦП,
экстремумы и остановки потока; сквозной стенд охватывает оба канала,
направления, четыре уровня FILTER и наличие/отсутствие шумовой мощности.
На независимом тестовом шуме RMS для divider 1/2/5/10/20/50/100/200 равен
6,70/4,67/2,92/2,07/1,47/1,03/0,76/0,62 кода. Timing: WNS 0,147 нс,
WHS 0,012 нс без ослабления ограничений. Санитайзерная сборка прошла
14 тестов; большой mock-захват требует большего ожидания под инструментированием.

На приборе при прежнем подключении CH1 соседняя медианная разность
при 50/20 MSa/s уменьшилась с 12/3 до 8/1 кодов. В четырёх framebuffer-кадрах
с FILTER MEDIUM при 20/50/100/200 мкс/дел медианная толщина жёлтого следа
на плато составляет 10/8/6/4 пикселя. Это оценка экранного следа, не аналоговый
RMS: отбрасывались колонки с фронтами и чрезмерным вертикальным размахом.
Среднее обновление за отдельные трёхсекундные интервалы — 110/130/112/112 мс
при 100K; source_error=0. На 200 MSa/s отмечено одно событие без нужной истории,
поэтому отсутствие потерь всех триггеров не подтверждено.

При остановленном GUI восемь трёхсекундных DMA-прогонов: 200 и 100 MSa/s
при 100K — около 400,12–400,14 МБ/с, 50 MSa/s при 100K и 1M — около
200,06–200,07 МБ/с. Пропусков sequence нет, удерживаемые leases неизменны.
Четыре выходных файла прошли проверку BOOT/FIT/QSPI; GUI, извлечённый из FIT,
совпадает с ARM-сборкой, работающей на приборе.

## 27 октября 2026 — аппаратный триггер DSP

Linux Release: 16/16 CTest, Windows Release: 9/9. В аппаратном mock-источнике
проверены все пять глубин, оба канала и направления, события у начала payload,
сборка 1M из нескольких блоков и сохранение первого кадра до показа.
В этих сценариях вызов программного поиска фронта завершает тест ошибкой.
Общая RTL-серия из 18 стендов завершилась успешно; отдельный стенд TRG1
проверил смену arm_id посреди передачи заголовка, raw/peak и паузы DMA.

Полная реализация xc7z020clg400-1: WNS 0,147 нс, WHS 0,015 нс; ограничения
тактов и внешнего АЦП сохранены. На подключённом приборе с глубиной 100K,
100 мкс/дел, 50 MSa/s за 300 опросов получено 4926 DSP-блоков и 129 кадров:
медианный интервал 123,3 мс при активном опросе, source_error и dsp_missed — 0.
Есть пропуски непрерывного потока, поэтому это не подтверждает захват всех
событий и не является замером без нагрузки от удалённого опроса.

До изменения прореживания измерены исходные коды CH1 на том же подключении:
медианная соседняя разность 5/7/12/3 кода при 200/100/50/20 MSa/s.
Проверка выявила зависимость структуры шума от выбора пар A/B; стабильность
шума на переходах развёртки этим вариантом ещё не обеспечена.

## 26 октября 2026 — направление FUNC для курсоров VERTICAL

- В режиме VERTICAL положительный шаг FUNC поднимает выбранный курсор A/B,
  отрицательный опускает. Проверены обычный и точный шаг, оба курсора и
  остановка у верхней/нижней границ. Направление TIME и FFT проверено
  существующими и дополненными тестами.
- Linux x86-64 Release: 16/16 CTest; Windows x64 Release: 9/9 CTest.
  Изменённый модуль GUI скомпилирован для ARMv7 Cortex-A9 штатным toolchain.
  По указанию владельца прибор не перепрошивался; физическое вращение
  энкодера с этим исправлением на приборе не проверено.

## 26 октября 2026 — вертикальный сдвиг при смене Time/div

- На подключённом приборе до исправления средние коды CH1 при 200 MSa/s
  составили A = 137,430 и B = 132,149; при 100 MSa/s обе опорные точки
  имели среднее около 137,487. Выбор только A при прореживании менял
  постоянную составляющую относительно полного потока. При неизменных
  5 V/div и позиции +40 среднее экранных точек CH1 менялось примерно
  с 223 до 200 пикселей. Это измерение текущего входа, не проверка
  абсолютной точности напряжения или калибровка нуля.
- RTL-тест до исправления не прошёл проверку опорных точек A/B. После
  исправления прошли все девять тестов `simulate.tcl`: дополнительно
  проверены сохранение среднего при различных нулях фаз, нечётные суммы,
  делители 1/2/5/100, исходные экстремумы и непрерывная передача /2.
- Linux x86-64 Release: 16/16 CTest; Windows x64 Release: 9/9 CTest.
  Затем новая проверка `scope_filter` отдельно прошла на обеих платформах:
  постоянный сигнал сохраняет координату при интерполяции и сжатии,
  дробном нуле, всех уровнях фильтра, с шумоподавлением и без него,
  Raw/Peak Detect, в картах плотности и соединений.
- Полная сборка FPGA, FSBL, ARMv7 GUI и Linux завершена. Vivado:
  WNS = 0,147 нс, WHS = 0,015 нс, нарушений setup/hold нет.
  Проверены заголовок Zynq, длина FIT и состав QSPI без области настроек.
- BOOT.BIN и image.bin записаны через UART с проверкой чтением. После
  перезагрузки SHA-256 обоих файлов повторно совпали с содержимым QSPI;
  GUI и захват запустились. Контрольная сумма документа настроек и текущие
  параметры перед записью сохранены. В ходе проверки временно менялись
  развёртка и CH1 V/div, затем восстановлены последние настройки владельца.
- После записи среднее CH1 в полном потоке — 134,521 кода, при
  100/50/20 MSa/s — 135,007/135,011/134,969; CH2 — 127,323 против
  127,331/127,386/127,330. Опорные точки больше не выбирают только A.
  Повторная проверка при 5 V/div, позиции +40 и прежнем фильтре дала
  средние координаты CH1 222,46 и 220,24 пикселя при двух проходах
  200 MSa/s; 221,36 при 100 MSa/s, 220,52 при 50 MSa/s и 221,51 при
  5 MSa/s (по три кадра). Прежний скачок около 23 пикселей отсутствует;
  наблюдаемый разброс порядка двух пикселей остаётся и без смены частоты.

## 26 октября 2026 — редкие пачки при 100 мкс/дел

- До исправления тест `scope_zynq_capture` воспроизвёл пропуск одиночной
  пачки в середине настоящего по размеру DMA payload при глубине 10K.
  После исправления проверены все глубины 10K/50K/100K/500K/1M и режимы
  AUTO/NORMAL/SINGLE: пачка в середине блока, на стыке и в конце с ожиданием
  участка после события из следующего блока. Проверяются точная метка
  триггера, её положение, полный интервал без пустых столбцов и Peak Detect.
  Дополнительно проверены оба крайних положения маркера и нечётная позиция
  фронта в паре Peak Detect.
- Linux x86-64 Release: 16/16 CTest; Windows x64 Release: 9/9 CTest.
  Тест аппаратного адаптера также прошёл с ASan/UBSan без ошибок.
  ARMv7 GUI и Linux FIT собраны штатным Buildroot toolchain. Обновлены
  `image.bin` и `qspi.bin`; проверены заголовок Zynq, длина FIT, состав
  разделов QSPI и отсутствие области настроек. На плату эти образы
  не записывались; задержка обновления экрана на Zynq не измерялась.

## 24 октября 2026 — полный кадр AUTO и шум DEBUG

- `scope_zynq_capture` с подменой драйвера воспроизводил публикацию неполной
  истории до исправления. Теперь для 10/20/50/100 мс/дел проверяет отсутствие
  нового кадра до полного интервала и наличие данных во всех столбцах после
  накопления. Те же условия проверены после пропуска блоков, для основного
  интервала ZOOM и после расширения развёртки. Существующие проверки
  NORMAL/SINGLE, FORCE, STOP и ROLL проходят.
- `scope_runtime` проверяет шум периодического DEBUG в пределах ±1 кода,
  изменение между отсчётами и sequence, повторяемость того же блока,
  независимость каналов, сохранение отдельной формы NOISE, обработку хвоста
  и границы выходного буфера. Подмена не изменяет аппаратные метаданные.
- Linux x86-64: 11/11 CTest; Windows x64 Release: 5/5 CTest. Это программные
  проверки; поведение обновлённого образа на Zynq ещё не проверено.
- ARMv7 Release собран штатным Buildroot toolchain. Обновлены `image.bin`
  и `qspi.bin`; проверены заголовки, размеры, размещение и совпадение
  составляющих QSPI с исходными образами. FPGA и ядро этим изменением не менялись.

## 24 октября 2026 — глубина записи, ROLL и обработка на Cortex-A9

На плате с FPGA `16f0ac3b430c` и Linux #14 проверены все 27 развёрток
10 нс/дел…5 с/дел при 100K точек. Частота записи менялась аппаратно;
DEBUG заменял значения после настоящего DMA. В AUTO свыше 100 мс/дел
история заполняет экран за реальное время. При 5 с/дел проверены все
глубины 10K/50K/100K/500K/1M: после накопления все 1024 столбца содержат данные.

Ниже короткие измерения счётчиков приложения за 3–5 секунд после заполнения
истории. «Графики» — новые обработанные записи, GUI — отрисованные кадры;
это разные счётчики. Время отдельного кадра меняется под нагрузкой.

| Режим | Графики/с | GUI, кадров/с |
|---|---:|---:|
| 100K, все развёртки, FFT OFF | 16–25 | 27–48 |
| 1M, 200 мкс/дел, DEBUG | 13,6 | 27,0 |
| 1M, 1 мс/дел, FFT | 13,0 | 30,8 |
| 1M, 100 мс/дел, FFT и послесвечение | 15,6 | 28,2 |
| 1M, 100 мкс/дел, два NOISE, FFT и послесвечение | 12,2 | 21,2 |
| 1M, 5 с/дел, ROLL и FFT | 10,8 | 42,6 |
| 1M, 200 мкс/дел, SIMULATION OFF | 13,2 | 28,8 |
| 100K, 100 мкс/дел, SIMULATION OFF | 23,8 | 41,6 |

В перечисленных прогонах `source_error=0`, экран заполнен по ширине.
SIMULATION OFF подтверждает обработку кодов из DMA, но не точность
аналогового тракта: он не распаян. Пропуски читателя на быстрых режимах
учитываются отдельно; это не длительная непрерывная запись без потерь.

После оптимизаций повторно проверены RUN/PAN (маркер x=512/352/672),
STOP/PAN с сохранёнными отсчётами, ожидание NORMAL при недостижимом уровне,
FALL и остановка SINGLE. Linux CTest 11/11, Windows Release CTest 5/5,
RTL 7/7. Отдельный ARM runtime-тест выполнен на Zynq: скалярный контроль
сумм, RMS, частоты и скважности на 1 000 003 точках; импульсы у границ
столбцов, SIMD-порций и конца записи; положительный, отрицательный и
нулевой gain. Обнаруженная задержанная публикация программного источника
после STOP устранена повторной проверкой состояния перед публикацией.

Окончательные BOOT (2 997 880 байт) и FIT (7 221 060 байт) записаны
через вкладку прошивки Oscill Terminal, COM3, 1 000 000 бод, без бэкапов.
Каждый записанный блок проверен чтением. После перезагрузки из QSPI
подтверждены FPGA `16f0ac3b430c`, Linux #14 и SHA-256 установленного GUI:
`44c20b2bdfbb215acce939b4a90b995c22c7c82ce51bc6f1d9b864be95014400`.
Счётчик IRQ DMA вырос 3429 → 3626 за примерно две секунды, статус
`0xADC30000`, сообщений `capture:` в dmesg нет. Повторно проверены полный
экран ROLL, STOP с переносом и изменением масштаба без изменения записи;
возвращены RUN, AUTO, 100K и 100 мкс/дел.

В асинхронном тесте смены частоты ожидание учитывает допустимый промежуточный
кадр сохранённой записи: тест ждёт первый кадр с новой частотой DMA.
Linux suite прошёл 11/11, затем этот тест прошёл 20 последовательных повторов.

## 23 октября 2026 — перенастройка аппаратной записи

На FPGA `16f0ac3b430c`, Linux #14 после дополнительного сброса S2MM
проверены 200M, 100M, 1M, 10K и 100 Sa/s. На каждой частоте выполнены
два прогона по три секунды с повторным открытием; повреждений заголовка
и изменения удерживаемого lease нет. Закрытие занимает 14–89 мс.
На 200 MSa/s доставлено 399,42–399,44 МБ/с, по два READY-блока пропущены
читателем во время проверки lease. На остальных частотах пропусков нет.
HDMI работает во время теста. Это короткая проверка реального DMA;
аналоговый тракт, точность кодов и длительная запись без потерь не проверены.

## 23 октября 2026 — скорость просмотра и маркер триггера

- На подключённой плате, DEBUG SIMULATION, два меандра, 100 мкс/дел,
  FFT OFF: до изменения обработка блока занимала 235–271 мс, поступало
  около 4 новых графиков/с, GUI рисовал около 20 кадров/с. После изменения
  короткий десятисекундный замер дал 50–57 мс, около 19 новых графиков/с
  и около 30 кадров GUI/с. Это измерение конкретного режима, не гарантия
  такой частоты при любой глубине записи, FFT или форме NOISE.
- В RUN через реальный GUI проверены позиции 0, +160 и −160: маркер
  находился в x=512, 352 и 672, фронт — в пределах двух экранных столбцов
  от маркера. На этой развёртке вся ширина заполнена отсчётами, включая
  предысторию. STOP сохраняет запись при горизонтальном переносе;
  NORMAL с заведомо недостижимым уровнем ждёт без смены кадра, FALL привязывает спад,
  SINGLE останавливается после захвата. Статус FPGA `0xADC20000`.
- Linux CTest 10/10 и Windows Release CTest 4/4: дополнены проверки
  координат триггера, PAN/ZOOM удерживаемого блока, диапазона обзора,
  предыстории, отключения FFT и статистики при положительном, отрицательном
  и нулевом коэффициенте преобразования. ARM GUI и FIT собраны;
  BOOT/FIT/QSPI прошли проверку структуры и размеров.
- При UART-передаче на 1 Мбод зарегистрирован `input overrun`: повреждённая
  команда завершилась синтаксической ошибкой до записи flash. Терминал
  повторяет такую ошибку для блока с фиксированным смещением, максимум
  четыре попытки; команда записи flash остаётся однократной. Тесты
  терминала 20/20, включая единичный сбой и исчерпание повторов без flash.

## 23 октября 2026 — UART-обновление и непрерывная очередь DMA

- Плата обновлена через вкладку прошивки Oscill Terminal на COM4, 1000000 бод.
  Перед записью сохранены и проверены полные копии QSPI; BOOT и FIT переданы
  отдельными файлами, каждый записанный блок прочитан обратно. После загрузки:
  `fpga=ca8de307a67b`, Linux `#11 SMP PREEMPT Fri Oct 23 21:29:24 MSK 2026`.
- В `capture_smoke.c` выполнены два аппаратных прогона по 3,003 с: по 571
  полученному блоку, 398,74 и 398,73 МБ/с доставленного payload. По два
  READY-блока были переиспользованы, пока читатель считал хеш удерживаемого
  блока; это пропуски читателя, не заявление о без потерь сохранённом потоке.
  Удерживаемая LEASED-память оставалась неизменной. Закрытие захвата заняло
  1545 и 1547 мс; повторное открытие прошло.
- После возврата GUI счётчик DMA вырос с 14861 до 16778 за примерно 10,04 с;
  статус FPGA `0xADC20000`, сообщений об overflow или ошибке DMA нет.
  Короткий прогон подтверждает приём около 400 МБ/с с работающим HDMI,
  но не длительную нагрузку или запас пропускной способности DDR.
- Через управление GUI проверены STOP, смещение CH1 и смена развёртки с
  повторным построением удерживаемой записи. Получен снимок физического
  framebuffer с работающими DEBUG-графиками. Завершение GUI — 2,125 с.
  Аналоговый входной тракт и точность кодов АЦП этими проверками не оценивались.
- Linux CTest 10/10, Windows Release 4/4, RTL 5/5. Стенд RTL включает
  Xilinx FIFO, преобразователь ширины и CDC. Текущая FPGA: WNS 0,147 нс,
  WHS 0,010 нс. BOOT/FIT/QSPI прошли проверку структуры и размеров.
- Терминал: 19 тестов протокола, загрузки, проверки файлов и GUI; отдельный
  EXE запускается без Python с пятью вкладками. Проверены отказ записи при
  неверном SHA, ожидание нового login после reboot и сохранение bootargs
  при RAM-загрузке. BACKUP выводится после остановки GUI перед чтением QSPI.

Аппаратный тест собирается ARM-компилятором с include-каталогом `gui/src`
из `linux/tests/capture_smoke.c`; запускать при остановленном GUI.

## 23 октября 2026 — консоль 1 Мбод и выбор 2 Мбод

- Linux CTest **9/9**, Windows MSVC Release **4/4**. Проверка UART через PTY
  проходит 115200 → 1000000 → 2000000, отклоняет неподдерживаемую скорость
  и сохраняет предыдущий выбор при ошибке открытия порта.
- Vivado принимает настройку 1000000, но ps7_init содержит делители 124/6
  для 115200. В FSBL добавлена явная установка 20/4 для UART clock 100 МГц;
  ARM-сборка и дизассемблирование подтверждают вызов и запись регистров.
  Проверены CONFIG_BAUDRATE=1000000 в собранном U-Boot, таблица скоростей
  до 2000000, bootargs/stdout-path DT и getty со скоростью 0 (сохранение).
- FPGA собрана вместе с исправлением старта AXIS: WNS=0,147 нс,
  WHS=0,019 нс, нарушений setup/hold нет. ARM GUI, ядро, U-Boot и FSBL
  собраны; проверка BOOT/FIT/QSPI прошла. В выдаче только четыре файла.
- Обмен на 1/2 Мбод через установленный CH340E и устранение capture error
  на физической плате после этой сборки ещё не проверены.

## 23 октября 2026 — запуск приёмного AXIS после reset

На плате владелец получил `PL=0xADC20001`, `enable=1`,
`S2MM_DMACR=0x00107003`, `S2MM_DMASR=0x00100008`, счётчик IRQ DMA=0.
Это подтверждает защёлкнутое переполнение входа при включённом потоке;
аппаратные биты ошибок DMA в этом снимке не установлены.

В `ad9288_input_tb` подключён настоящий `axis_dwidth_converter` Xilinx
1.1 вместо всегда готового получателя. До исправления стенд воспроизводит
остановку с `ADC not read`: первый TVALID совпадал со снятием reset, когда
IP ещё не выставил READY. После отделения reset от 32-тактовой выдержки
прошли все четыре RTL-стенда, включая порядок слов после преобразования,
намеренный overflow и повторный запуск. Повторная проверка исправления
на установленной плате ещё требуется.

## 23 октября 2026 — AD9288 и DEBUG после DMA

- Linux CTest **9/9**, Windows MSVC Release **4/4**. Дополнительно расширен
  `scope_zynq_capture`: read-only mmap, несколько leases, границы payload,
  отсутствие кадров DEBUG без завершения DMA, смена режима на следующем блоке,
  сохранение записи STOP, NORMAL, FORCE в STOP, SINGLE и повторное взведение,
  ошибка источника без перехода на программный генератор.
- XSim: **4/4** стенда. Проверены упаковка, заголовки, sequence/first_sample,
  порядок A/B и каналов, backpressure/TLAST, остановка при overflow и повторный
  запуск. Непрерывный тест передаёт 256 блоков с паузами получателя через FIFO
  на 32 слова; максимальное заполнение — 6 слов, потерь нет. Это модель RTL,
  а не измерение AXI/DDR на плате.
- Buildroot собрал ARM GUI, ядро с `oscill_capture` и Device Tree. Проверены
  `CONFIG_XILINX_DMA=y`, CMA 64 МиБ и автозапуск с `/dev/oscill-capture`.
  Три теста QSPI-layout прошли.
- Vivado 2019.1 собрал bitstream и FSBL для `xc7z020clg400-1`. После
  трассировки WNS=0,147 нс, WHS=0,018 нс, нарушений setup/hold нет;
  все 32 входа АЦП имеют min/max input delay. Это STA с бюджетом платы,
  не измеренный запас. Проверка готовых BOOT.BIN/FIT/QSPI прошла;
  выдача содержит только BOOT.BIN, image.bin, qspi.bin и fsbl.elf.
- Физический захват, правильность кодов АЦП и скорость с HDMI пока не
  измерены. Порядок проверки и расчётные параметры — [ADC_CAPTURE.md](ADC_CAPTURE.md).

## 23 октября 2026 — масштаб времени в STOP за пределами записи

- Linux CTest **9/9**, Windows MSVC **4/4**. Проверены изменение развёртки
  энкодером, сенсорным API и меню в STOP, сжатие записи вдвое/впятеро,
  пустые области по краям, возврат исходного изображения, неизменность source,
  sequence и временной привязки. ZOOM после сжатия использует правильный шаг.
- Новый тест renderer сравнивает пустые области и внутренний разрыв с фоном
  без канала: ни обычная линия, ни min/max, ни послесвечение не рисуют там
  ложный сигнал. Фильтр не заполняет отсутствующие точки, Vpp не включает
  маркер пропуска. CSV прежнего формата сохраняет пропуски при повторном чтении,
  позволяет сжать сохранённую запись и вернуть исходный вид.
- Raw processor проверен с экранным интервалом шире памяти, частичным столбцом,
  полностью отсутствующим пересечением и невалидными параметрами. Импульс остаётся
  на физическом месте. Потоковый pipeline после STOP меняет отображение без
  новых блоков и без смены sequence. В статистику входят только реальные точки.
- На изображениях настоящего renderer 1024×600 визуально проверены исходная
  запись 100 мкс/дел, сжатие до 500 мкс/дел и горизонтальное перемещение:
  десять периодов занимают пятую часть сетки, за границами запись отсутствует.
  Это программная проверка; на физической плате изменение ещё не испытано.

Изменение затрагивает GUI Zynq/Windows/Linux, исходники STM32 не менялись.
Buildroot собрал ARM GUI и итоговый FIT; `image.bin` и `qspi.bin` обновлены.
Проверены исходники ARM build, вложенный rootfs и побайтное совпадение ELF
из конечного `image.bin` с установленными файлами сборки. BOOT/FIT/QSPI payload
и резервные области прошли `verify_release.py`. BOOT.BIN и FSBL не изменялись;
для обновления достаточно `image.bin` по адресу QSPI `0x520000`.

## 23 октября 2026 — температура STM32 и простые страницы OLED

- STM32 CTest **6/6** на Linux GCC и Windows MSVC. Проверены раздельные
  ADC9/16/17, выбор ранга/времени выборки, Poll без ожидания, ошибки настройки,
  старта, опроса и таймаут через wrap uptime. Расчёт температуры проверен для
  разных VDDA, нуля, отрицательных значений, верхней границы и ошибочных raw.
- Сквозной PTY-тест с настоящим serial worker прошёл в обоих режимах
  `STM32_STANDALONE_DEBUG=0/1`: отрицательная температура доходит в snapshot,
  INT32_MIN отменяет значение, после перезапуска transport оно не сохраняется.
  Частичные записи/EAGAIN и прежние команды масштабов/RUN продолжают работать.
- Keil Arm Compiler 6.19 слинковал HEX/AXF: **0 ошибок, 0 предупреждений**.
  `check_project.py` — PASS. Периферия CubeMX не изменялась; новые измерения
  добавлены в существующий прикладной драйвер ADC.
- GUI Windows CTest **4/4**, Linux **9/9**. Общий кодек принимает TEMPERATURE,
  отрицательные значения и sentinel, отбрасывает неверный ID/диапазон.
  Frontend передаёт температуру и её возраст в status IPC. OLED проверен на
  свежесть ровно 3000 мс, истечение на 3001 мс, сумму возрастов и UINT64_MAX,
  отсутствие/ошибку замера, нулевую температуру и пагинацию с зарезервированной
  строкой STM32. Во всех страницах проверено отсутствие STALE/UNAVAILABLE/N/A/AGE.
- Реальные SDL GUI и отдельная служба прошли heartbeat, SIGSTOP/TIMEOUT,
  восстановление SIGCONT и штатное завершение. Настоящие буферы OLED 128×64
  всех восьми страниц и температуры без данных просмотрены визуально; значения
  тестовые, это не показания платы. Подписи помещаются, число заменяется `-`.
- Buildroot собрал ARM-приложение, службу и FIT. Выдача обновлена в
  `ZYNQ7020/output/linux/`; проверки заголовка BOOT/FIT, длины, payload и
  резервов QSPI прошли. Исходники в ARM build сверены с рабочими файлами.
  ARM-приложение и служба, извлечённые из initramfs внутри итогового FIT,
  побайтно совпали с установленными ELF из этой сборки.

Новая телеметрия требует обновления и STM32, и Zynq. Автоматической прошивки
нет. Физическая температура, точность типовых коэффициентов и работа ADC на
установленной плате в этой сессии не измерены; тесты на ПК этого не доказывают.

## 23 октября 2026 — запуск энкодера между щелчками и настоящая K1

- Владелец воспроизвёл мёртвую зону после включения с энкодером между фиксациями.
  Предыдущая привязка к стартовому снимку была недостаточна. Добавленный сценарий
  с физической опорой 11 и стартом в 00 провалился на первом обратном щелчке.
  Теперь `Encoder_Init` получает фазу отдельным параметром; в прошивке задана
  программная опора 11. Тесты проходят для четырёх опор и четырёх начальных
  состояний, обоих направлений доводки/реверса, дребезга и 2/4 переходов на шаг.
  STM32 CTest **6/6** на Windows и Linux. Keil 6.19: HEX/AXF слинкованы,
  **0 ошибок, 0 предупреждений**. Конкретная фаза механических фиксаций на
  установленной детали ещё не измерена; значение 11 — настройка, не измерение.
- Визуально повторно проверены листы 4/5/9 оригинальной схемы: K1 — PS MIO0/E6;
  K2 — PL KEY1/M20; K3 — PL KEY2/M19. Старый код читал M19, что соответствует
  наблюдению владельца о реакции на K3. Новый транспорт K1 выбирает gpiochip с
  label `zynq_gpio` и запрашивает только line 0 как input/active-low. Тест
  подтверждает пропуск PL-контроллера, правильные offset/flags, нажатие/отпускание,
  занятую линию, потерю устройства, закрытие fd и повторное открытие.
- Linux GUI/служба собраны, CTest **9/9**. Интеграционный тест реальной службы и
  SDL GUI прошёл heartbeat, SIGSTOP/TIMEOUT, SIGCONT и штатное завершение.
  В текущем ядре проверены GPIO_ZYNQ, GPIO_CDEV и GPIO_CDEV_V1; последние два
  параметра добавлены явно в kernel.fragment. FPGA/FSBL для исправления K1
  не меняются. Физическое переключение страниц новой прошивкой ещё не испытано.
- Новый транспорт K1 собран отдельно с `-std=c11 -Wall -Wextra -Werror`, тест
  прошёл. Windows GUI собран, CTest **4/4**; проверка структуры CubeMX/Keil
  `check_project.py` — PASS. Buildroot собрал ARM-службу и итоговый FIT;
  в штатной выдаче обновлены BOOT.BIN, image.bin и qspi.bin, сохранён fsbl.elf.
  Проверены BOOT/FIT, размещение payload и резервов QSPI; служба, извлечённая
  из initramfs внутри FIT, побайтно совпадает с установленной ARM-службой.

## 23 октября 2026 — реверс энкодеров и удержание кнопок меню

- Новый `stm32_encoder` воспроизвёл прежнюю ошибку: скачок сразу обеих фаз,
  несколько полных шагов вперёд, затем полный шаг назад без события. С фиксацией
  границы детента к начальной фазе тест проходит. Проверяются четыре начальные
  фазы, оба направления, реверс каждого щелчка, дребезг, частичный поворот с
  возвратом, повреждение на каждом участке цикла и восстановление в обе стороны.
  Режимы 1/2/4 перехода проверены; настройка платы 4 перехода сохранена.
- STM32 host CTest **6/6** на Windows MSVC и Linux GCC. В Keil Arm Compiler
  6.19 полностью слинкован `STM32/output/oscill_controls.hex`: 0 ошибок,
  0 предупреждений. Изменён общий декодер в субмодуле `AllLibs/PeriphGeneral`;
  SCALE/POSITION и физическая карта GPIO этим исправлением не менялись.
- Для CH1, CH2, CURSOR, TRG MODE и MENU/BACK проверено закрытие открытого меню
  удержанием отдельной кнопки, включая незавершённое редактирование триггера.
  SDL frontend проверяет порог и отпускание всех пяти кнопок: после удержания
  нет короткого действия, переключения канала, курсоров, режима триггера или ZOOM.
- DOUBLE CLICK по умолчанию **300 мс**: оба канала выключаются на границе
  300 мс и остаются включёнными при 301 мс. Долгое нажатие очищает последовательность
  двойного клика. Старый сценарий включения ZOOM из открытого меню обновлён:
  первое удержание MENU закрывает меню, следующее включает ZOOM.
- Итоговые GUI CTest: Windows **4/4**, Linux **8/8**. Buildroot пересобрал
  ARM GUI и FIT с этими изменениями и значением 300 мс; в штатной выдаче обновлены
  `BOOT.BIN`, `image.bin`, `qspi.bin`, сохранён соответствующий `fsbl.elf`.
  Проверены заголовки, размеры, резервные области и вложенные payload QSPI;
  исходники сборки совпадают с рабочими файлами, GUI, извлечённый из FIT/initramfs,
  побайтно совпадает с установленным ARM-приложением.
- Проверки электрических последовательностей выполнены через fake GPIO с
  настоящим библиотечным `Encoder_Update`; измерения A/B на панели не проводились.
  В первой версии фаза при инициализации считалась положением фиксации;
  это ограничение устранено в следующей проверке выше. Точное исполнение
  EC11E и число переходов на щелчок требуют проверки установленной детали.

## 23 октября 2026 — энкодеры, DEBUG и остановленный кадр

- После настольных проверок пересобран пакет GUI в Buildroot 2025.02.12,
  rootfs/initramfs и FIT; обновлены `ZYNQ7020/output/linux/BOOT.BIN`, `image.bin`
  и `qspi.bin`, рядом сохранён `fsbl.elf`. FPGA/FSBL не изменялись, повторная
  упаковка BOOT сохранила его SHA-256. В выдаче только четыре штатных файла.
  Проверены заголовок BOOT, длина FIT, размеры разделов, payload и заполнение
  QSPI. Исходники пакета GUI сравнены с рабочими файлами; GUI, извлечённый из
  initramfs внутри FIT, побайтно совпадает с установленным ARM-приложением и
  содержит LONG PRESS / DOUBLE CLICK. Keil Arm Compiler 6.19 собрал полную
  прошивку `STM32/output/oscill_controls.hex` / `.axf`: 0 ошибок, 0 предупреждений.
  Устройства не прошивались.
- Windows MSVC Release: GUI собран, CTest **4/4**. Linux GCC 7.5 / SDL2 2.0.8
  с framebuffer/Zynq adapters: GUI собран, CTest **8/8**; после добавления
  проверки удержания повторно выполнен `scope_linux_frontend` — PASS.
- Проверены обратное направление SCALE обоих каналов и прежнее направление
  POSITION; DEBUG со скрытым выбором шрифта, шаг/границы LONG PRESS и DOUBLE CLICK,
  интервал двойного клика на границе и на 1 мс позже. SDL frontend проверяет
  удержание до/на пороге 800 мс, отпускание с пропущенным timer tick и отсутствие
  короткого действия после длинного. Изменение порогов действует до перезапуска.
- При STOP применение уровня через кнопку TRIG, сброс уровня удержанием,
  смена источника и фронта сохраняют исходные отсчёты, обе кривые и min/max
  побайтно; проверки повторяются с ZOOM. Смена развёртки в STOP не создаёт
  новую запись; FORCE получает новый кадр. Прежний тест адаптивной записи
  теперь явно вызывает FORCE для проверки новой частоты дискретизации.
- STM32 host-тесты **5/5**; сквозной PTY-обмен с настоящим serial worker — PASS
  в обычном и автономном вариантах. Изменённый `panel_state.c` скомпилирован
  Arm Compiler 6 для Cortex-M3 в обоих вариантах с `-Wall -Wextra -Werror`.
- ARM Linux Cortex-A9 GUI с framebuffer/Zynq adapters полностью собран и
  слинкован Buildroot GCC 13.3.0. Это проверки на ПК и кросс-компиляция;
  управление физическими энкодерами и работа на плате в этой проверке не испытаны.

## 22–23 октября 2026 — служебный OLED

- Windows MSVC 19.29 / VS2019: Release GUI и переносимые OLED/страницы собраны;
  CTest **4/4**. Linux GCC 7.5 / SDL2 2.0.8, framebuffer и Zynq adapter:
  Release собран, CTest **8/8**. Новые Linux-модули службы отдельно собраны с
  `-std=c11 -Wall -Wextra -Werror` без предупреждений.
- Проверены версия/размер datagram, отказ oversized-пакета, отсутствие и
  перезапуск получателя, неблокирующий отказ при полной очереди; GUI heartbeat,
  таймаут запуска/зависания, новый старт, K1 с дребезгом и без повтора при
  удержании, температурные подстраницы и исчезновение датчиков, устаревшее питание.
- Температурные fixtures: hwmon, IIO raw с индивидуальными и общими scale/offset,
  готовый IIO input с приоритетом над raw, thermal, отрицательные значения и
  ошибка чтения. CPU/MemAvailable и отсутствие отдельного накопителя проверены
  независимо от реальной платы. Отдельный frontend-тест подтверждает возраст
  напряжения по CLOCK_MONOTONIC UART, а не по SDL_GetTicks.
- `test_status_service.py` запускает настоящий SDL GUI с dummy video и отдельную
  службу: READY → SIGSTOP созданного GUI → GUI TIMEOUT → SIGCONT → восстановление
  → штатный STOP. Служба остаётся работающей, после завершения убирает сокет.
- Serial OLED transport проверен по фронтам SCLK: первый полный кадр 1024 байта,
  неизменный кадр не передаётся, изменение строки отправляет только её диапазон.
  Реальный PBM framebuffer 128×64 от службы просмотрен визуально; текст и
  инверсный заголовок помещаются без обрезания.
- Vivado 2019.1: полный проект с OLED/PL-кнопками K3/K2 собран, timing проходит:
  **WNS 1,114 нс, WHS 0,021 нс**. SDK 2019.1 собрал FSBL и diagnostic;
  OLED запускается после снятия PS/PL reset, перед инициализацией HDMI.
- В собранном Linux ядре подтверждены `CONFIG_UIO`, `CONFIG_UIO_PDRV_GENIRQ`,
  `CONFIG_IIO`, `CONFIG_XILINX_XADC`. В DTB проверены имя UIO `oscill-oled` и
  bootarg привязки драйвера; shell-синтаксис init/post-build проверен.
- Полный Buildroot 2025.02.12 с ARM hard-float toolchain собран. Хеши исходников
  модели, frontend и sysfs-сборщика в локальном пакете совпадают с рабочей копией.
  ARM-модель страниц/heartbeat/K1/OLED прошла в `qemu-arm -cpu cortex-a9`;
  ARM-служба запущена с `--once --text`. Старый qemu-user сообщает о неподдержанных
  новых syscalls, но эти два прогона завершаются успешно; это не проверка загрузки
  полной системы или аппаратного GPIO.
- Итоговая выдача в `ZYNQ7020/output/linux/` содержит только `BOOT.BIN`
  (2 431 872 байта), `image.bin` (7 148 476), `qspi.bin` (16 777 216),
  `fsbl.elf` (1 025 772). `verify_release.py` прошёл: checksum заголовка Zynq,
  длина FIT, соответствие payload, расположение разделов и резервные области
  QSPI. Запас FIT-раздела — 3 206 212 байт. Запись на плату не выполнялась.

Физическая работа OLED/K1, показания температур и напряжения в этой сессии
не проверены. Компиляция и программные fixtures не являются измерениями платы.
Реализация и схема страниц — [STATUS_DISPLAY.md](STATUS_DISPLAY.md).

## Предыдущие проверки

Проверки выполнены 8 октября 2026 на Windows, Intel Core i5-14600KF (14 cores / 20 logical processors). Доступа к работающей Zynq/STM32 и сенсорному контроллеру в сеансе нет. Результат ARM compilation не является проверкой на устройстве.

## Сборки и функциональные тесты

| Проверка | Результат |
|---|---|
| Корневой CMake, Release, llvm-mingw 20240619 / Clang 18.1.8 | Windows WinAPI frontend и все переносимые targets собраны |
| CTest Windows | 4/4: `scope_simulator`, `scope_runtime`, `stm32_controls`, `stm32_controls_uart` |
| Windows MSVC 19.29 / VS 2019, текущая интеграция Linux | Release собран; CTest 4/4 |
| Linux GCC 11.4 / SDL2 2.0.20, framebuffer backend | Release собран; CTest 5/5, включая `scope_linux_touch` |
| Evdev с подменой системных вызовов | Single touch, один и два MT слота, поворот, чтение нескольких пакетов за кадр, SYN_DROPPED, отпускание при disconnect и восстановление активного контакта при reconnect; pointer-устройство отклоняется |
| Linux display/touch `-Wall -Wextra -Werror` | Без предупреждений |
| Раздельные каталоги результатов | GUI Windows собран в `ZYNQ7020/gui/output/windows`, CTest 2/2; STM32 host-тесты собраны в `STM32/output/tests/windows`, CTest 2/2; Keil output проверен скриптом проекта; Linux BOOT после переноса совпадает по SHA-256 |
| CubeMX 6.12.1 / STM32CubeF1 1.8.7 | Проект F103RCT6 сгенерирован; повторная генерация сохраняет USER CODE, прикладные файлы, группы/пути Keil, compiler и output |
| `python STM32/tests/check_project.py` | PASS: MCU, SWD, UART, clock, точки подключения приложения, исходники/include Keil и каталог результатов |
| Keil MDK 5.38 / Arm Compiler 6.19 | Все C-модули компилируются без предупреждений; assembler не запускается из-за `A9555E / R207(3): REGISTRY READ ERROR`, итогового Keil HEX/AXF нет |
| GNU Arm 15.2.1, Cortex-M3, `-Wall -Wextra -Werror` | Все C-файлы из Keil-проекта скомпилированы и слинкованы с официальным GCC startup F103xE; ELF/HEX созданы отдельно для проверки, это не результат линковки Keil |
| ARM Linux GCC 8.2.0, Cortex-A9 / NEON / hard-float | SDL frontend, runtime, Zynq adapter и evdev собраны и слинкованы в вариантах DRM и framebuffer; framebuffer собирается без libdrm |
| Target SDL2 2.30.12 | ARM static library собрана из исходников |
| Target libdrm 2.4.124, Meson 1.7.2 | ARM static library собрана из исходников |
| `readelf -h -A scope_preview` | ELF32 ARM little-endian, EABI5 hard-float, ARMv7-A, VFPv3, NEON |
| DRM/framebuffer/evdev translation units, ARM `-Wall -Wextra -Werror` | Скомпилированы |
| Vivado 2019.1, полный PS/VDMA/VTC/TMDS проект | Синтез, размещение и разводка завершены; WNS 1,298 нс, WHS 0,029 нс, timing проходит |
| SDK 2019.1, FSBL и диагностическое приложение | Собраны из полученного handoff; `BOOT.BIN` содержит FSBL, bitstream и приложение |
| U-Boot 2024.10, Bootlin GCC 13.3.0 | Собран `u-boot.elf` с Device Tree платы; запуск в QEMU 10.2.0 Zynq: 496 МиБ RAM, UART1, два SD-контроллера, адреса скрипта, два чтения и сравнение 16 МиБ эмулированной QSPI |
| ELF/BOOT layout | FSBL расположен в OCM, диагностическое приложение ниже 32 МиБ; magic и checksum Zynq boot header проверены, диапазоны разделов укладываются в файл |
| Vivado 2019.1, `axis_capture_pack_tb` | PASS: 32 AXI beats, порядок, TLAST, удержание при backpressure |
| `python ZYNQ7020/linux/tests/test_qspi.py` | 3/3: exact fit, превышение границы на байт, A/B budget, пустой image |
| `bash -n` | Linux build/start/card scripts и сохранённый Tinker build script проходят syntax check |
| `git bundle verify` | Полная сохранённая история GUI, bundle исправен |
| PCB working tree | Чистое |
| Документация и миграция | Оба исходных ТЗ сохранены целиком; исходные GUI файлы и PNG сохранены; локальные ссылки разрешаются |
| Buildroot 2025.02.12 / Bootlin GCC 13.3.0 | Полная сборка U-Boot, Linux 6.6.70, DTB, SDL2, ARM GUI и SquashFS завершена на Debian build host |
| QEMU 10.2.0, загрузка с SD и QSPI | U-Boot исполняет штатные скрипты, Linux монтирует SquashFS, создаёт framebuffer 1024×600 и автоматически запускает GUI; QSPI запуск выполнен без SD-устройства |
| ARM GUI в Linux | Процесс работает с `--fb /dev/fb0 --touch auto`; кадр прочитан из framebuffer и визуально проверен |
| `tests/verify_release.py` и чтение FAT32 через mtools | PASS: Zynq header/checksum, CRC скриптов, MBR/FAT32, все загрузочные файлы, rootfs, payloads и свободные области QSPI |

`scope_runtime` проверяет CRC16 known vector, фрагментацию/ресинхронизацию UART, duplicate/sequence wrap/gaps, queue overflow, правила владения raw buffers, все три full policies, сохранение узкого импульса min/max при уменьшении до экранных столбцов, raw read/write и CRC corruption, threaded acquisition/processing, STOP и смену масштаба после STOP. STM32 тест проверяет приём DOWN/UP и шагов энкодера, переполнение timestamps и TX overflow. Assertions в новых тестах действуют и в Release.

В timing report нет внутренних endpoints без ограничений или registers без clock. Внешние задержки приёмника HDMI не заданы; сигнал на разъёме ещё не измерен. В текущей сборке VDMA MM2S работает на 100 МГц, отдельный AXI clock converter передаёт поток в видео 50 МГц. Сборка `ZYNQ7020/oscill.xpr` после этого изменения прошла: WNS 1,307 нс, WHS 0,020 нс; SDK собрал FSBL и диагностический BOOT из нового HDF. Диагностический тест DDR использует отдельные адресные биты 2…28, walking data и два полных прохода 464 МиБ; перед чтением результатов выполняется ARM `dsb`.

Комплект с экранным журналом загрузки проверен в QEMU 6.2: U-Boot ELF читает FIT из полного QSPI-образа без SD, проверяет три SHA-256, Linux распаковывает initramfs и автоматически запускает штатные демосигналы с UART diagnostics. Для SD исполнен штатный `boot.scr` с корнем SquashFS. В обоих случаях активная консоль GUI — tty2; `S99oscill stop` завершает процесс и возвращает tty1. Кадры 1024×600 прочитаны из памяти framebuffer; визуально проверены сообщения ядра/rcS перед запуском GUI и сам QSPI GUI с двумя демосигналами. BootROM, FSBL, PL и USB-сенсор этот прогон не проверяет.

`stm32_controls_uart` проверяет HAL busy, неизменность активного буфера,
подтверждение только после TX complete, повтор ошибки с тем же пакетом,
потерянный IRQ, переполнение tick и callback во время запуска HAL.
ARM-проверка STM32 использует Flash 256 КиБ / SRAM 48 КиБ; аппаратных результатов
для панели, частоты HSI и USART пока нет.

## STM32 и двусторонний UART — 21 октября 2026

| Проверка | Результат |
|---|---|
| Keil MDK / Arm Compiler 6.19, полный Rebuild | Созданы `STM32/output/oscill_controls.hex` и `.axf`; 0 ошибок, 0 предупреждений. Прежнее ограничение assembler в этом запуске отсутствует |
| GNU Arm 15.2.1, Cortex-M3 | Полная компиляция и линковка обычного и `STM32_STANDALONE_DEBUG=1` вариантов; прикладные модули проверены с `-Wall -Wextra -Werror`. Предупреждения существующих субмодулей не скрывают ошибок приложения |
| CubeMX 6.12.1, повторная генерация | Сохранены прикладные `.c/.h`, USER CODE, группы/пути Keil, ADC9, реле и каталог выдачи; `check_project.py` проходит |
| MSVC / Windows, STM32 host-тесты | 5/5: события, UART TX/RX, масштабы, автономный режим, аппаратный adapter GPIO/ADC с fake HAL |
| MSVC / Windows, GUI | Сборка WinAPI frontend, CTest 3/3 |
| Linux GCC 11.4, SDL/framebuffer | Сборка GUI и всей переносимой части, CTest 13/13 |
| Linux PTY, настоящий serial worker + `panel_state` | В обоих вариантах `STM32_STANDALONE_DEBUG` проверены инициирование от STM32, отсутствие двойной обработки шага, абсолютный запрос масштаба, RUN, режим позиции, питание и восстановление масштабов после перезапуска transport. Принудительные частичные записи и EAGAIN не повреждают команды |
| Автопоиск USB serial, Linux PTY | Запуск без порта, подключение панели, чужой порт с неверным CRC без исходящих команд, DOWN/UP и RUN, отключение, смена ttyUSB и новая эпоха sequence |
| Автономный режим | Начальный запуск без GUI, штатные RUN/позиция при связи, переход к местному управлению через две секунды, восстановление связи, некорректные команды и переполнение tick |
| ARM Linux / Cortex-A9 | Текущий GUI с двусторонним transport собран и слинкован существующим ARM toolchain |
| Buildroot 2025.02.12 | Пересобраны ядро и ARM GUI; в итоговой конфигурации CH341/CP210x/CDC ACM включены в ядро, в rootfs установлен `SERIAL_DEVICE=auto` |
| Итоговые образы Zynq | `BOOT.BIN`, `image.bin`, `qspi.bin`; рядом в `output/linux/` находится `fsbl.elf` для SDK Program Flash. После переноса FSBL его SHA-256 сохранён, Bootgen и сборка QSPI выполнены повторно; `verify_release.py` проходит. Тесты QSPI-layout — 3/3. Проверены заголовки, длины, payload и свободные области |

Тесты проверяют границы масштаба, выбор каждой линии GPIO, замену цели во время
паузы реле, переполнение миллисекундного счётчика, RX-фрагменты/CRC/дубли/переполнение
кольца, восстановление приёма, отсутствие ожидания ADC и отказ замера.
Реальные GPIO, контакты реле, направление энкодеров, напряжение опоры и установление
аналогового тракта на устройстве в этом сеансе не проверялись. Таблица делителя —
расчёт по схеме, преобразование ADC использует заданное VREF+, а не измеряет его.

После удаления `WFI` владелец подтвердил обычное подключение и прошивку через ST-Link
без дополнительных действий.

## Направление энкодеров — 22 октября 2026

Инверсия TIME для масштаба и FUNC для выбора пунктов меню проверена в Windows
(3/3 CTest) и Linux (13/13). Проверки сохраняют прежнее поведение позиции,
курсоров, редактирования значений и сенсорного управления. Buildroot пересобрал
ARM GUI и образы; `verify_release.py` проходит. На устройстве направление
после этой правки ещё не проверялось.

## Сохранение изображения исходного GUI

Исходный GUI `16c10c6` и текущий WinAPI frontend собраны одним Clang toolchain. BMP получены отдельными тестовыми запусками `--snapshot` и `--panel-snapshot`; чужие работающие окна не закрывались. Пары совпадают побайтно по SHA-256:

- LCD: `C9DD4111EE8C02CF1F5B72BF9478FF0D0048E6812CC76F888C2B7A6824207B67`.
- Panel: `354536A0154A7EF9EB1BE7CC8C248545011C8998F08C584F7C93BB4457C65C5B`.

Это проверка начального состояния и отрисовки, а не всех интерактивных последовательностей. Исходный simulator regression suite также проходит.

## Программная нагрузка на ПК

Release `scope_benchmark RATE 3`: отдельные producer/processor/render потоки, 8 × 1 МиБ, producer копирует заранее подготовленный шаблон, processor выполняет raw statistics/min-max/FFT, renderer рисует CPU кадр. Память повторно используется и может находиться в cache. Здесь нет PL, DMA, USB или HDMI scanout. Частота захвата в metadata не является фактически выполненным ADC sampling.

| Цель, МБ/с | Опубликовано, МБ/с | Обработано, МБ/с | Блоки обработано/всего | Overwrite | Drop | Peak | FPS | Среднее processing, мс | CPU, % одного ядра |
|---:|---:|---:|---:|---:|---:|---:|---:|---:|---:|
| 100 | 100,31 | 99,95 | 287/287 | 0 | 0 | 1 | 60,00 | 2,887 | 25,9 |
| 200 | 200,28 | 199,70 | 573/573 | 0 | 0 | 1 | 59,67 | 2,724 | 40,5 |
| 400 | 400,21 | 398,35 | 1145/1145 | 0 | 0 | 2 | 59,67 | 2,539 | 95,9 |
| 500 | 499,82 | 412,15 | 1186/1430 | 244 | 0 | 7 | 60,00 | 2,541 | 99,9 |

Средняя отрисовка: 0,461–0,509 мс; максимальная: 0,785–1,052 мс. Максимальный промежуток между началами кадров: 17,588–17,836 мс. Нагрузка 500 МБ/с превышает возможности данного processor на этом ПК; overwrite ожидающих READY учитывается, CPU-owned блоки защищены. Processed rate включает время drain после завершения producer, published rate делится на заданные 3 с. FPS относится к вызовам CPU renderer, не к предъявлению HDMI кадров.

`corrupt=0` во всех четырёх прогонах — выборочная проверка байтов через 4096 байт, а не CRC всего потока. Полный CRC payload проверяется отдельно в файловом тесте. Для измерений DDR/DMA нужен аппаратный PL test pattern с sequence и проверкой полного payload.

## Невыполненные аппаратные и системные проверки

FSBL, HDMI bitstream и полный Linux-комплект собраны. GUI запущен в ARM Linux в QEMU с SD и QSPI. Эмулятор запускает U-Boot ELF напрямую на одном CPU: BootROM/FSBL/PL, реальная DDR, второй CPU, HDMI-разъём и USB3320/HID сенсора этим прогоном не проверяются. USB PHY в модели не отвечает; это не результат проверки USB платы. Tinker ARM32/ARM64 package не пересобирался; source list и shell syntax обновлены.

На устройстве предстоит проверить:

1. DDR handoff, UART console, восстановление и загрузку QSPI без карты.
2. HDMI mode/pixel clock и длительную работу около 60 Hz. Первый Linux-комплект копирует кадры в одну framebuffer-поверхность; page flip относится к отдельному DRM backend.
3. USB Host/VBUS, фактический HID single touch или multitouch, pinch при наличии двух контактов и отсутствие mouse duplicates; reconnect/SYN_DROPPED.
4. Физический UART STM32, последовательности encoder/down/up/hold/chord, повреждения и разрыв связи.
5. DMA PL pattern сначала без видео, затем с HDMI и обработкой: 100/200/400 МБ/с, повышенная нагрузка и soak. Полный контроль payload, FIFO/SG/queue counters и cache coherency.
6. STOP/pretrigger/posttrigger, масштабирование всей сохранённой raw записи, реальную задержку реакции интерфейса.
7. Raw export, SD speed/full/eject/reinsert и сохранность файлов.

До этих проверок нет подтверждения 400 МБ/с на Zynq с HDMI и 20–30% запасом. Расчёт потенциального DDR bottleneck — [PERFORMANCE.md](PERFORMANCE.md), оставшаяся реализация — [DECISIONS.md](DECISIONS.md).

## Скругление и заставка

`scope_rendering` проверяет сохранение фона снаружи углов, симметрию верхних и нижних углов, промежуточное покрытие пикселей, сохранение светлой рамки, выход виджета за границы кадра и рендер меню/карточек/просмотра файлов с фиксированными радиусами 5/10 px во всех режимах курсоров. Дополнительно проверяются симметрия BOTH, половинная ширина и центрирование RISING/FALLING, полная заливка RUN/STOP/BACK, отрисовка меню поверх нижних карточек, подписи оси FFT с графиком под ними, общая рамка таблицы курсоров, единый цвет CH1/CH2, диапазон и параметры шкалы FFT, положение подписи курсора FFT у обоих краёв, полная длина линий и горизонтальный режим dB, сохранение подписи TIME/VERTICAL при выборе A/B/FFT во всех шрифтах и обеих компоновках карточек и строчная `n` в обоих шрифтах. В `scope_simulator` проверяются диапазон 500 ns–1 s, масштаб старого CSV, две строки курсоров CH1/CH2, пристыковка Measurements справа от курсоров и подъём при расширении, центрирование меню после повторного открытия, четыре цифры курсоров на масштабах ns/us/ms и min/max фактически захваченных демо-отсчётов на медленной развёртке, частоты генератора до 1 MHz, спектральный пик синуса 1 MHz и отметка ALIAS при недостаточной частоте дискретизации, позиция и показания курсора FFT по логарифмической шкале при смене диапазона и выходе за границы, цикл FUNC A/B/FFT, автоматическое появление курсора FFT при включении FFT и курсоров в любом порядке, скрытие при OFF и отсутствие активации касанием или FUNC при OFF, FINE и уровни −80…0 dB. `scope_runtime` дополнительно проверяет одиночные импульсы в начале, конце и на границах интервалов при сжатии 4093 исходных отсчётов в 1024 столбца, полное покрытие положительных частот FFT и сохранение пиков между отображаемыми позициями вплоть до частоты Найквиста.

Для текущих исходников выполнены Windows Release (3/3 CTest) и Linux Debug с framebuffer/Zynq adapters (5/5, включая touch и SDL frontend). Windows-снимки текущего интерфейса находятся в `ZYNQ7020/gui/output/validation/interface/`, заставки — в `ZYNQ7020/gui/output/validation/rounding/splash.png`. Проверки simulator, rendering и runtime выполняют assert также в Release. Синтаксис GUI и видеозапуска проверен ARM Linux и bare-metal компиляторами. После просмотра Windows-версии владельцем пересобраны FSBL с логотипом, ARM GUI и Linux-образы; проверены заголовки, содержимое SD/QSPI, лимиты разделов, manifest SHA-256 и CRC архива. В доступном QEMU 6.2 прямая загрузка текущего ядра/initramfs доходит до login; framebuffer-модель не готова для запуска GUI, а параметр boot-mode для полной проверки QSPI этой версией не поддерживается. Сохранение заставки во время реальной загрузки, управление на плате и время старта пока не проверены.

`scope_linux_frontend` проверяет сохранение min/max на 10 ms/div в реальном `draw_all()` SDL frontend, восстановление привязки после raw frame, отказ экспорта BMP/CSV в tmpfs с сообщением `NO DATA CARD`, а также обычное сохранение и чтение файлов в настольном режиме. Ранний FSBL hook и работа D-cache проверены компиляцией и порядком вызовов в ELF; выигрыш времени и обнаружение HDMI требуют измерения на плате.

## Масштабирование исходного сигнала

`scope_runtime` проверяет сжатие одиночных импульсов и повторное построение увеличенного участка из того же raw-буфера, включая интерполяцию между исходными отсчётами и неизменность записи. `scope_simulator` проверяет сетку демо-шума на быстрой основной развёртке 500 ns/div, ограничение записи до 8192 отсчётов на канал, уменьшение частоты захвата при увеличении времени основной развёртки, изменение min/max шума между кадрами RUN и неизменность исходного буфера при ZOOM. `scope_rendering` проверяет цветной штрих толщиной 1 px при обычной развёртке и разных высотах окна ZOOM. Эти проверки выполняются на ПК; реальный захват АЦП ими не подтверждается.

## Диагностика UART

После пересборки с `DIAGNOSTICS=0` значение проверено в SquashFS и initramfs. Проверка `verify_release.py` прошла для SD/QSPI образов. В QEMU 6.2 выполнена прямая загрузка ядра, DTB и initramfs: подтверждены работа GUI, отсутствие `--diagnostics` в аргументах процесса и периодических строк `render_ms`/`touch_connected` в UART за шесть секунд наблюдения. Параметр эмулятора `mem=496M` оставляет верхние 16 МиБ для framebuffer, поскольку при прямой загрузке QEMU заменяет размер памяти из DTB. Этот прогон не проверяет загрузку через U-Boot, SD/QSPI и запуск на плате.

## Время загрузки

В конфигурациях удалены паузы U-Boot 2 секунды и запуска GUI 4 секунды; `loglevel=4` сохраняет вывод предупреждений и ошибок ядра в UART. QSPI-команда читает заголовок FIT, получает `totalsize`, проверяет пределы 40…0x9e0000 байт и читает только образ. Для собранного FIT размером 7 112 320 байт это исключает чтение 3 242 368 байт заполнения. Скрипт сборки обновляет Device Tree ядра/U-Boot и `boot.scr` также при повторной сборке.

Buildroot пересобрал ARM GUI, U-Boot и DTB; проверены параметры в U-Boot, DTB и SquashFS, shell syntax, три теста QSPI-layout и `verify_release.py`. В QEMU 6.2 U-Boot загружает Linux с SD и из FIT, GUI автоматически работает с `START_DELAY=0` и без периодической диагностики. Для FIT проверены чтение 40-байтового заголовка, получение длины, отклонение значений меньше заголовка и больше раздела, загрузка через `bootm` с проверкой SHA-256 всех трёх payload. В FIT-прогоне чтение выполняется из эмулированной SD: физический QSPI этим прогоном не проверяется.

Первоначальное наблюдение владельца при загрузке из QSPI: около 4 секунд от FPGA DONE до логотипа и ещё 5–6 секунд до GUI. После удаления программных пауз изображение появляется около `oscill login`; предоставленный UART-журнал содержит `FPGA Done!` и затем `SPLASH_READY` до передачи управления U-Boot, но не содержит временных отметок.

09.10.2026 владелец остановил загрузку на приглашении U-Boot: логотип появился без запуска Linux, примерно через те же 4 секунды. Это подтверждает работу заставки FSBL на плате и исключает необходимость Linux для её появления. Дисплей питается от отдельного источника; при reset платы его питание сохраняется. При отключении и повторном подключении HDMI уже работающего GUI изображение возвращается примерно через 2,5 секунды без reset платы. Дисплей вносит заметную задержку восстановления изображения; время выполнения FSBL и момент начала корректного HDMI-сигнала ещё не измерены. Оценки владельца приблизительные: разность этих двух наблюдений не является измерением времени FSBL.

## 24 октября 2026 — стартовые тесты и исходные уровни АЦП

- Linux CTest 11/11, Windows Release 5/5. Проверены обновление кодов до SIMULATION, чтение последней пары до RELEASE, независимость от содержимого освобождённого DMA-буфера, прочерки до первого блока и при ошибке, сроки актуальности OLED, передача через IPC и отсутствие редактирования новых строк DEBUG.
- Проверка АЦП проходит все семь физических частот в mock-драйвере; отдельно проверены прекращение подъёма при ошибке настройки на 25 МГц, ошибке DMA на 50 МГц и постоянном предельном коде CH2-B на первой ступени. Числа частот в этих тестах задаются моделью, а не измеряются на плате.
- На настоящем SDL frontend с dummy video проверены отсутствующий ADC device, отсутствие данных USB-панели и каталог в RAM вместо карты. Во всех случаях остаётся диагностическое состояние, remote socket не открывается; SIGTERM завершает приложение с ошибкой. На временной ФС проверены запись/чтение/удаление пробного файла и отказ записи в read-only каталог.
- RTL 8/8 в Vivado 2019.1, включая реальные Xilinx width/FIFO/CDC IP и новый стенд физического encode: семь частот 1,5625…100 МГц, непрерывные клоки в STOP, по одной новой стабильной паре A/B на период. Это симуляция, а не измерение выводов платы.
- FPGA синтезирована и разведена: итоговые WNS 0,147 нс, WHS 0,017 нс, все заданные timing constraints выполнены. Управление делителем регистрируется в домене encode перед декодированием; setup/hold входных шин не ослаблялись. ARM GUI, status service, Linux-драйвер и FSBL собраны; структуры BOOT/FIT/QSPI, размеры и заполнение разделов проверены `verify_release.py`.
- HDMI DEBUG, стартовый экран ошибки и строка CH1/CH2 существующей OLED Capture отрисованы программно и просмотрены. Эти изображения не подтверждают физический HDMI/OLED и реакцию аналогового тракта.
- Образы записаны в QSPI через UART штатным backend TERMINAL. После перезагрузки SHA-256 прочитанных BOOT.BIN и image.bin совпали с исходными; Linux сообщил FPGA `651edbe4413b`, регистр PL — `0xADC40000`.
- На плате стартовая проверка прошла USB-панель, сенсор и запись/чтение карты, затем остановилась с `ADC CH1-A AT 255 / 1.5625 MHz`. Владелец подтвердил отказ на первой ступени. Отдельное чтение через тот же драйвер на этой частоте получило четыре последовательных DMA-блока по 1 МиБ; во всём payload каждой из четырёх ветвей CH1-A/B и CH2-A/B оказалось по 1 048 576 кодов 255 без других значений. Флаг overflow отсутствовал. Частота взята из конфигурации, физические такты и уровни на выводах не измерялись; причина постоянных единиц не установлена. Повышение частоты после отказа не выполнялось.

## 24 октября 2026 — повторение стартовой проверки

- Linux CTest 11/11, Windows Release 5/5. В тесте SDL frontend USB-панель появляется после первой неудачной шестисекундной попытки, затем по одному разу отказывают проверка карты, проверка АЦП и создание захвата. Тот же процесс доходит до рабочего состояния только после успеха всех проверок, удаляет накопленные команды панели и допускает завершение ожидания флагом остановки или событием закрытия окна. Время и отказы задаются моделью; автоматическое восстановление на плате ещё не проверено.
- ARM GUI и Linux FIT пересобраны; `verify_release.py` подтвердил заголовок BOOT, длину FIT, содержимое и заполнение разделов QSPI. Образы сохранены в `ZYNQ7020/output/linux/`; в рамках этого изменения прошивка платы не выполнялась.

## 24 октября 2026 — необязательный сенсор

- Сенсор исключён из обязательной стартовой последовательности; поиск и восстановление оставлены в рабочем цикле GUI. Linux Debug с framebuffer/Zynq adapters: 12/12 CTest, включая повторение старта после ошибок и существующие проверки evdev; Windows Release: 5/5. ARM GUI и FIT пересобраны, состав BOOT/FIT/QSPI проверен `verify_release.py`.
- Плата прошита через COM4 штатным `FirmwareJob` из TERMINAL. После перезагрузки SHA-256 BOOT.BIN и image.bin, прочитанных из MTD, совпали с исходными; хеш `/usr/bin/scope_preview` совпал с ARM-сборкой. При пустом `/proc/bus/input/devices` и единственном внешнем USB-устройстве CH341 стартовая проверка прошла все семь ступеней АЦП. `oscill-remote ping` ответил `OSCILL REMOTE 1`, состояние GUI — `running:1`. Это проверка запуска без сенсора на плате; физическое переподключение сенсора в этом прогоне не выполнялось.

## 24 октября 2026 — вертикальный масштаб реального АЦП

- Тест SDL frontend проводит одинаковые коды через настоящий адаптер запроса и обработчик изображения на всех шести диапазонах. Проверены уменьшение высоты вдвое при переходах 100→200, 500→1000 и 1000→2000 мВ/дел, постоянство напряжения внутри ступени реле и сохранение высоты при щупе ×10. Linux CTest 12/12, Windows Release 5/5, STM32 host CTest 6/6; проверка проекта CubeMX/Keil прошла.
- ARM GUI и FIT пересобраны; BOOT/FIT/QSPI проверены `verify_release.py`. Keil собрал STM32 с нулём ошибок и предупреждений.
- Zynq прошит через COM4. После перезагрузки SHA-256 BOOT.BIN и FIT, прочитанных из MTD, совпали с исходными. В RUN с SIMULATION OFF, развёрткой 100 мкс/дел и частотой из состояния GUI 50 MSa/s получено по пять CSV экранных координат CH1 на 0,5/1/2 В/дел. Средний RMS относительно среднего следа: 8,428/4,553/2,338 пикселя; средний размах: 50,2/22,4/12,4 пикселя. Все три диапазона используют одну ступень реле; изменение высоты подтверждено на реальных кодах АЦП. Это проверка отображения шума незавершённого тракта, не калибровка входного напряжения. Исходный диапазон CH1 восстановлен, SIMULATION оставлена OFF.
- Две попытки Download STM32 в Keil завершились `ST-LINK USB communication error` до сообщений об успешной записи/проверке. Windows определяет один STM32 STLink без ошибки устройства. Новая прошивка панели собрана, её запись не подтверждена; аппаратные маски реле в общем модуле совпадают с прежними.

## 24 октября 2026 — TIME с панели, reset STM32 и фронты триггера

- Linux 12/12 и Windows Release 5/5. Проверены подписи длинной развёртки без суффикса при сохранённом режиме прокрутки, открытие TIME последовательностью MENU/BACK → поворот FUNC → нажатие FUNC и возврат назад. Обновлены проверки компоновки главного меню и меню сохранённой записи.
- Тест поиска фронта воспроизводит шумовые положительные переходы на спаде и проверяет RISING/FALLING/BOTH, а также начало разрешённого интервала после предыдущего пересечения. Дополнительно 32 реализации штатного шумного DEBUG-синуса 1 кГц при заданной частоте 1 MSa/s проверены по знаку производной исходной формы: без гистерезиса встречается неверный склон, с двумя кодами RISING и FALLING всегда выбирают нужный. Это программная проверка генератора и алгоритма.
- После подключения панели Keil успешно записал и проверил STM32. Reset and Run с включённой пакетной Debug Description давал сообщение Application running, но команда диапазона не подтверждалась панелью. После отключения Debug Description выполнены два отдельных Download с reset/run; оба раза GUI получил от STM32 подтверждение нового диапазона. Исходный диапазон восстановлен. Проверка настройки Keil включена в `check_project.py`.

## 24 октября 2026 — плотность, Peak Detect, FFT и увеличение STOP

- Linux Debug CTest 12/12, Windows Release 5/5, переносимые тесты STM32 6/6; `check_project.py` прошёл. Проверены распределение 7:1 по реальным пикселям без вымышленных попаданий внутри min/max, суммирование совпавших физических строк при разделении экрана, сохранение записи и увеличение без растянутых экстремумов, синее соединение точек coloring, отсутствие цифр в батарее и переключение SIMULATION одним нажатием. Фронты, FFT 10 кГц при Fs 50 MSa/s и нормировка плотности проверены численно.
- RTL 8/8, включая обе ветви АЦП, экстремумы отброшенных отсчётов, backpressure и непрерывный поток при делении на 2. FPGA собрана с WNS 0,147 нс и WHS 0,021 нс, все заданные timing constraints выполнены. ARM GUI, драйвер и FIT собраны; BOOT/FIT/QSPI проверены `verify_release.py`.
- На Zynq FPGA `df2d658da758`, ID `0xADC50000`: два трёхсекундных прогона на 200 MSa/s и два на 100 MSa/s с Peak Detect дали 399,42–399,44 МБ/с. В каждом прогоне читатель пропустил два READY-блока при удержании lease; удерживаемая память не менялась. На 10 MSa/s с Peak Detect получено 40,01 МБ/с без пропусков. Это проверка DMA, не аналоговой точности и не непрерывной записи без потерь.
- В DEBUG SINE 1 кГц, NORMAL CH1, уровень 0,6 В восемь кадров RISING имели нужный знак наклона около маркера, восемь FALLING — противоположный. В STOP при Fs 10 kSa/s проверено увеличение 50 мс/дел → 20 мкс/дел с coloring OFF/ON; частота сохранённой записи не изменилась. Возврат на исходный масштаб дал побайтно тот же экранный CSV. Снятые framebuffer просмотрены: вместо широких прямоугольников между редкими отсчётами остаётся соединяющая линия.
- При 1M, 10 мс/дел, Fs 5 MSa/s, DEBUG SQUARE 10 кГц, FFT 65536 и coloring отдельные обработки занимали 858–886 мс. При этом 100 локальных запросов ping дали среднее 78,50 мс, p95 132,39 мс, максимум 138,24 мс; 100 изменений уровня — 78,99/127,57/138,84 мс. Это время полного обмена remote API через два прохода GUI, а не измерение задержки физической кнопки. Средняя отрисовка в диагностике — 29,8–30,5 мс. В этом нагруженном режиме счётчик пропусков DMA рос; непрерывность захвата при такой обработке не заявляется.
- В SIMULATION OFF три последовательных чтения экранных координат дали разные SHA-256 и значения. Панель после Download/reset/run подтвердила команду диапазона; передавала свежие значения питания 0–3 мВ с возрастом 212–327 мс. Эти показания объясняют пустое заполнение индикатора при временной шкале 3,3–4,2 В; напряжение на физическом входе STM32 в этом прогоне не измерялось. Настройки после проверки восстановлены.
- Финальные BOOT.BIN (3 129 464 байта) и image.bin (7 231 212 байт) записаны через COM4. После перезагрузки SHA-256 чтения MTD совпали с исходными: BOOT `3b79a08534ef0a3829ce8603693df497d73420f852e1cccebe802f386f9702ad`, FIT `ed3b43beb701ace6fc68685da7b6e17a27cd6f18033486a1e521f4291af2a893`. SHA-256 запущенного GUI — `5ef73d2f578affe104110c7439377c3ff2185296fed59cc4e02cce3fac980c0c`, совпадает с ARM-сборкой. После этого STM32 снова прошита с Verify OK и reset/run; команда диапазона подтверждена GUI. В итоговом состоянии RUN=1, сенсор отсутствует, источник работает без ошибки.

## 24 октября 2026 — непрерывность вида при увеличении Peak Detect

- На присланной остановленной записи GUI сообщил Fs 200 kSa/s и глубину 10K. При 1 мс/дел в окно попадает 2000 равномерных отсчётов, при 500 мкс/дел — 1000; прежний порог один отсчёт на колонку объясняет резкое исчезновение всей огибающей.
- Linux CTest 12/12, Windows Release 5/5. Новая проверка проецирует середины интервалов независимо от алгоритма редукции на десяти масштабах, включая 1025/1024/1023 отсчёта на ширину экрана. При 2000/1000/64 отсчётах отображаются соответственно 1000/500/32 отдельные метки min/max. Одиночный скрытый выброс остаётся шириной в одну колонку при увеличении. Значения min/max измерений сохраняются, а экстремумы не прибавляют вымышленных попаданий к карте coloring. Дополненные проверки повторно пройдены на Linux и Windows.
- Программно отрисованы и просмотрены виды одной записи при 2 мс, 1 мс, 500 мкс, 200 мкс и 20 мкс/дел. ARM GUI/FIT собраны; состав BOOT/FIT/QSPI проверен. FPGA, драйвер и формат данных не менялись.
- На плате с SIMULATION OFF захвачена новая запись 10K при 2 мс/дел и Fs 200 kSa/s, затем в STOP пройдены 1 мс/500 мкс/200 мкс/20 мкс. Частота записи оставалась 200 kSa/s. Снятые framebuffer на 1 мс, 500 мкс, 20 мкс и 500 мкс с coloring просмотрены: размах экстремумов сохраняется на пороге, на сильном увеличении видны отдельные тонкие метки и соединённые отсчёты. Возврат к 2 мс дал идентичный CSV, SHA-256 `d2d5a9966e16f6e0fb70de1c057e0a078f28def55f3b5211f43f2d4971df4e03`. Исходные настройки восстановлены; GUI оставлен в STOP на 500 мкс/дел с coloring OFF.
- Zynq прошит через COM4; после перезагрузки чтением сверены BOOT и FIT. Новый FIT — 7 232 368 байт, SHA-256 `fd50d6bf917e6022239d4771f7ad8ad9d030f4d55db59d93dbb79d1df84829b4`; BOOT сохранил `3b79a08534ef0a3829ce8603693df497d73420f852e1cccebe802f386f9702ad`. SHA-256 запущенного GUI `4ab245d57c454d493676e0cc49594ffc4016a8be79e7921a9a42345c90b44519` совпал с ARM-сборкой. STM32 после обновления сброшена и запущена через ST-Link; команда диапазона получила подтверждение.

## 24 октября 2026 — ломаная через пропущенные пики

- Linux Debug CTest 12/12, Windows Release 5/5; ARM GUI/FIT собраны, BOOT/FIT/QSPI прошли `verify_release.py`. FPGA и формат захвата не менялись.
- На синусе, нарастающей и спадающей пиле, меандре и шуме с min/max, покрываемыми сохранёнными отсчётами, три массива экранных координат совпали с обычной отрисовкой побайтно. Проверены десять масштабов, включая 1025/1024/1023 отсчёта на экран, отрицательный коэффициент канала и пустые поля за границами записи.
- Для постоянных отсчётов с широкими скрытыми min/max проверены амплитуда на десяти масштабах, аналитическая форма соединения на увеличении и отсутствие полноразмерных вертикальных меток. Одиночный пропущенный выброс соединён внутри своего двухотсчётного интервала. Добавленные вершины не создают density hits; FFT, среднее, RMS и частота совпали с расчётами без экстремумов.
- В отдельной численной модели синус размахом 120 кодов АЦП проверен на 32 фазах. Peak Detect получал 32 исходных преобразования на сохранённый отсчёт, экран увеличен до 128 отсчётов на 1024 колонки. Максимальное изменение линии относительно интерполяции равномерных отсчётов: при 64/32 отсчётах на период — 0 кодов; при 20 — 1 код (0,83% размаха), при 10 — 3,875 кода (3,23%), при 4 — 18,25 кода (15,21%). Это результат данной модели и набора фаз, не универсальная погрешность восстановления и не измерение аналогового тракта.
- Zynq прошит через COM4. После перезагрузки SHA-256 чтения MTD совпали с BOOT `3b79a08534ef0a3829ce8603693df497d73420f852e1cccebe802f386f9702ad` и FIT `6375cad768d771c26c1f5f2fb7482d3879bcdd4413f678292f866175b67f0b2d` (7 234 092 байта). Запущенный GUI `6637bc33c6ffb8dd6c6ea82eedf0405fd478435b416e03be9688ef2549a937e6` совпал с ARM-сборкой. STM32 записана с Verify OK и reset/run; GUI получил подтверждение команды диапазона.
- На плате с SIMULATION OFF захвачена запись 10K при 2 мс/дел, Fs 200 kSa/s; в STOP пройдены 2 мс/1 мс/500 мкс/200 мкс/20 мкс/2 мкс. Fs оставалась 200 kSa/s, возврат к 2 мс дал идентичный CSV, SHA-256 `1d621bdadac83c814e1d89bfa89f2141047f44512428a33e814fbd19601f7df2`. Снятые framebuffer на 500 мкс, 2 мкс и с coloring просмотрены: на сильном увеличении пропущенные пики соединены наклонными отрезками. Исходные настройки и STOP восстановлены. Первый прогон не засчитан: между запросами состояние изменилось со STOP на RUN; причина не установлена, повторный полный прогон прошёл без этого изменения.

## 24 октября 2026 — яркость шума вместо толстого штриха

- Linux Debug CTest 12/12 и Windows Release 5/5. В обычном режиме с выключенным COLORING проверены разные яркости частого и редкого попадания, отсутствие сплошной заливки между ними и отсутствие контура вокруг однопиксельного соединения. При добавлении настоящего скрытого диапазона появляется отдельная полоса. Проверки выполнены в общем рендерере; существующие варианты разделения экрана, батареи, истории, пустых интервалов и курсоров прошли.
- На десяти масштабах min/max аппаратного интервала отделены от временных координат. Малый пропущенный выброс не отбрасывается, отображается слабее сильного; исходные равномерные точки сохраняются. Прежняя проверка синуса на 32 фазах теперь требует точного совпадения линии равномерных отсчётов независимо от наличия пиков. Карта coloring не получает вымышленных попаданий, а расчёты FFT и измерений не изменены.
- Программно просмотрены SINC и SIN с штатным шумом при Fs 200 MSa/s, увеличение до 100 отсчётов на экран и полностью алиасированный SIN при Fs 1 kSa/s. Шум показан точками и тонким соединением с разной интенсивностью; недоразрешённый размах — отдельной полосой, без условных треугольников.
- На плате проверены SINC и SIN 10 кГц с штатным шумом при Fs 200 MSa/s, обычной яркости и выключенном COLORING. В STOP увеличение 20 мкс/дел → 2 мкс/дел → 50 нс/дел сохранило Fs и запись; возврат дал прежний CSV, SHA-256 `15d9360b373c5d9734dfc0f6e517403316c430774e4616adc53b43b7ac4cb71e`. Это проверка программного DEBUG через работающий DMA, не аналогового входа.
- По присланному примеру дополнительно захвачена SINC-запись 100K при 10 мс/дел и Fs 500 kSa/s. В STOP проверены 1 мс/500 мкс/200 мкс/10 мкс/2 мкс; на просмотренном framebuffer 10 мкс/дел ступенчатой подложки нет, точки соединены тонкой линией. Возврат к исходному масштабу дал тот же CSV, SHA-256 `6d81a95c35eaf7605855185f3f07f907f88167fcf164817692fe5f752d330631`. Общий рендерер проверяет постепенное ослабление полосы на 4/2/1/0,5 отсчёта на пиксель, сохранение кривой и отсутствие подложки при дальнейшем увеличении.
- На 1M, 5 мс/дел, Fs 10 MSa/s, DEBUG SIN 10 кГц без FFT сто локальных запросов ping дали 200,00/290,76/309,91 мс (среднее/p95/максимум); сто изменений уровня — 208,38/280,82/316,35 мс. Измерен полный обмен через remote API, а не задержка физической кнопки. В этом режиме остаются задержки интерфейса до примерно 0,3 с; гарантированная реакция менее 100 мс не подтверждена.
- На окончательном образе повторён DEBUG SIN 10 кГц с Fs 5 kSa/s: при 100 мс/дел виден сохранённый аппаратный размах, при увеличении STOP до 50 мкс/дел остаётся тонкое соединение сохранённых точек без подложки. Снимки framebuffer просмотрены; обратный переход дал идентичный CSV, SHA-256 `888eb84145b56fcbd642936b3f4630c0997c55f7bfa79ba81ed561279cb16de9`. Первая автоматическая оценка стенки требовала заполнения более 95% области, включая шумовой диапазон обычных отсчётов; она дала 93% и не прошла. После проверки снимка области разделены: скрытый размах заполнен полностью, а диапазон обычных отсчётов по замыслу сохраняет отдельные попадания вместо заливки. Повторная проверка обеих областей и увеличения прошла.
- Через COM4 записаны BOOT.BIN (3 129 464 байта) и image.bin (7 234 008 байт). Первая передача FIT не прошла проверку SHA-256 в RAM до записи во flash; повреждённый блок передан повторно. После записи и перезагрузки чтение MTD совпало с исходными: BOOT `3b79a08534ef0a3829ce8603693df497d73420f852e1cccebe802f386f9702ad`, FIT `b2f9461cde34fb8fc1ac6dee33a759760b1af8a436cf9956a51f1968c112c93c`. SHA-256 запущенного GUI `603e2bef388fc685a163de42d5f7b5f466602f528783a89d56d86d71147590b8` совпал с ARM-сборкой. STM32 прошита с Verify OK и reset/run; подтверждение команды диапазона получено. Настройки восстановлены: SINC 10 кГц, 100K, STOP, Fs 20 MSa/s, 200 мкс/дел, COLORING включён, FFT выключен.

## 24 октября 2026 — фронты и сжатие без опорной ломаной

- Linux Debug 12/12 и Windows Release 5/5. Новый тест общего растеризатора проверяет стенку из полного периода в каждой колонке на четырёх степенях сжатия, сохранение числа фронтов разрешённого меандра при четырёх дробных сдвигах, непрерывное увеличение одного отрезка, обратный вертикальный масштаб, отсечение вне экрана и пустое окно вне записи. Проверена компактная карта соединения при разделении экрана. Прежний тест реальных попаданий сохраняет нулевое число попаданий между кодами, хотя отдельная карта соединения там заполнена.
- Тест рендерера проверяет оба канала с COLORING OFF/ON: разреженные попадания по фронту соединены без пустых строк, маска пропущенных экстремумов не стирает настоящий фронт, соседняя колонка без перехода не закрашивается. В COLORING проверена нижняя видимая яркость синего соединения.
- На Zynq через работающий DMA проверен DEBUG CH2 SQUARE 10 кГц, 100K, 500 мВ/дел: 50 мкс/дел при Fs 100 MSa/s, обычный и разделённый экран, COLORING OFF/ON. В каждом из четырёх сочетаний проверено девять фронтов; все строки проверенной центральной части соединены. Снимки framebuffer просмотрены. При 5 мс/дел (Fs 1 MSa/s) и 10 мс/дел (Fs 500 kSa/s) остаётся сжатый размах без крупной опорной волны; на 10 мс/дел вся проверенная внутренняя область покрыта стенкой. На 5 мс/дел около половины периода приходится на колонку, поэтому отдельные колонки могут содержать только часть перехода.
- В STOP после захвата на 10 мс/дел пройдены 5 мс/2 мс/1 мс/200 мкс/50 мкс/10 мкс/2 мкс. Fs оставалась 500 kSa/s; возврат дал тот же CSV, SHA-256 `d9c4e3556a1648ffc385cbdf8fb781f851436861159ae90c33d634d33650e3ee`. Дополнительно просмотрены SIN, SINC и NOISE на 20 мкс/дел при Fs 200 MSa/s. Это проверка DEBUG на плате, не аналогового входа; источник, FFT и измерения не изменены.
- В RUN на 1M, 5 мс/дел, Fs 10 MSa/s, DEBUG CH2 SQUARE 10 кГц, без FFT и COLORING: сто локальных ping дали 193,48/290,76/316,98 мс, сто изменений уровня — 191,90/297,40/327,33 мс (среднее/p95/максимум). Измерен полный обмен remote API; задержка физического органа управления этим тестом не измеряется. Ограничение до примерно 0,3 с из предыдущего прогона сохраняется.
- Окончательный ARM GUI собран; BOOT/FIT/QSPI проверены `verify_release.py`. Через COM4 записаны BOOT.BIN (3 129 464 байта) и image.bin (7 236 816 байт). Перед записью проверен SHA-256 RAM, после перезагрузки — чтения MTD: BOOT `3b79a08534ef0a3829ce8603693df497d73420f852e1cccebe802f386f9702ad`, FIT `0719b59472a7ad264c1b667540b3020966c0f3258178a1700abd61bafc491efd`. SHA-256 запущенного GUI `05f06af02b32b3cc4be70202ea5a5f42f6420bfc07d2e972437d560ee609e645` совпал с ARM-сборкой. STM32 прошита с Verify OK и reset/run; команда диапазона подтверждена. Исходные настройки сверены через API: RUN, CH1 OFF, CH2 SQUARE 10 кГц, 500 мВ/дел, 100K, 5 мс/дел, Fs 1 MSa/s, COLORING OFF, FFT OFF, уровень триггера 0,8 В.

## 24 октября 2026 — одинаковая максимальная яркость на разных масштабах

- Linux Debug 12/12 и Windows Release 5/5. Проверка общего растеризатора требует 255 у доминирующей строки при 512/1023/1024/1025/2048/8192/32768 отсчётах на экран. Редкое покрытие остаётся слабее максимума, пустые строки не закрашиваются. Прежние проверки геометрии, непрерывности фронтов и настоящих попаданий прошли.
- На одинаковых программно сгенерированных отсчётах и при одинаковой геометрии выполнены рендеры прежней и новой нормировки. Для SIN 20 мкс/дел число колонок с пикселем полного цвета канала выросло с 2 до 900 из 900; для SIN 500 нс/дел осталось 900 из 900. Просмотрены синус и широкополосный шум: изменена интенсивность, дополнительного контура или заливки пустых строк нет.
- На Zynq проверен DEBUG CH2 SIN 10 кГц, 100K, 500 мВ/дел, COLORING OFF: 500 нс/2 мкс/10 мкс/20 мкс/50 мкс/200 мкс/1 мс/5 мс/10 мс на деление. Перед снимком проверялись TIME и Fs готового кадра. Во всех девяти случаях каждая из 900 проверенных колонок имела пиксель полного цвета канала. На 20 мкс/дел полная яркость занимала 1–2 пикселя по высоте. Также прошли SQUARE на 50 мкс и 10 мс/дел и NOISE на 20 мкс/дел. Это проверка DEBUG на плате, не аналоговой точности.
- ARM GUI собран; BOOT/FIT/QSPI проверены `verify_release.py`. Через COM4 записаны BOOT.BIN (3 129 464 байта) и image.bin (7 236 792 байта). После перезагрузки чтение MTD совпало с исходными: BOOT `3b79a08534ef0a3829ce8603693df497d73420f852e1cccebe802f386f9702ad`, FIT `3fdf0055af1cb218de76cfa9ce2333cbcaef8f6d2605244cc6548bafc14627b5`. SHA-256 запущенного GUI `3c6e354ee59e5fd936a015d1bd756a3f71d727e92cff928daa748a55a825e153` совпал с ARM-сборкой. Подтверждение команды диапазона от STM32 получено, исходные настройки сверены через API.
- Три попытки Download/reset/run STM32 остановились на `ST-LINK USB communication error` до записи и проверки. Программатор определяется Windows, его программный перезапуск через PnP отклонён из-за прав доступа. Сброс STM32 в этом прогоне не подтверждён; панель продолжает отвечать на команды. Запрошено физическое переподключение ST-Link для повторения сброса.

## 25 октября 2026 — фильтрация кривой и меню PROCESSING

- Linux Debug 13/13 и Windows Release 6/6. Новый scope_filter проверяет единичное усиление постоянного уровня, симметрию отклика без смещения и выбросов, монотонный фронт, сохранение разрывов, последовательное подавление шума LOW/MEDIUM/HIGH, независимость каналов, фильтрованные карты соединений и плотности. На тестовом шумном меандре HIGH уменьшает среднеквадратичное отклонение экранных отсчётов на плато более чем в пять раз; это результат тестового набора, не характеристика любого входного шума.
- Проверены неизменность исходного буфера, аппаратных измерений и FFT при смене FILTER, отсутствие необработанной Peak Detect полосы поверх сглаженной кривой, чтение того же фильтрованного сигнала при увеличении. Отдельная проверка фонового pipeline в STOP требует нового представления с прежней sequence и без новых блоков; OFF точно восстанавливает координаты. SDL-проверка подтверждает передачу уровней фильтров в запрос обработки и сохранение remote-настройки record_depth_index после переноса RECORD LENGTH. Проверены меню PROCESSING с шестью строками и главное меню без TIME; выполнены рендеры шумного меандра OFF/HIGH и COLORING.
- На подключённом Zynq проверен реальный вход: SIMULATION OFF, CH1 OFF, CH2 2 В/дел, 1 мкс/дел, Fs 200 MSa/s, 100K, NORMAL/RISING по CH2. Одна остановленная запись показана с четырьмя уровнями фильтра; LOW/MEDIUM/HIGH последовательно сглаживают шум, HIGH также заметно растягивает фронты. По сравнению с OFF меняются 989/993/1010 из 1024 координат CH2; возврат OFF даёт побайтово тот же CSV. Снимки framebuffer подтверждают изменение именно видимой кривой. После проверки восстановлены RUN, SIMULATION OFF, исходные масштабы, позиции, фильтры и триггер. Это проверка работы фильтра на реальном сигнале, не калибровка аналогового тракта.
- ARM GUI и release собраны, BOOT/FIT/QSPI проверены verify_release.py. Через COM4 записаны BOOT.BIN (3 129 464 байта) и image.bin (7 237 760 байт); после перезагрузки SHA-256 чтения MTD совпали: BOOT `3b79a08534ef0a3829ce8603693df497d73420f852e1cccebe802f386f9702ad`, FIT `eac8bfe933a5da13ad4d3bd96070b8d469556de1326e9fa221410009da3b75a3`. Запущенный GUI `ecb18cf22eeb9e9d36827d45a7682f9354c88a74f0e60b8a8eb5dd2169f6d8cf` совпал с испытанной ARM-сборкой. После перезагрузки проверен ответ STM32 на команду диапазона, затем исходные настройки восстановлены и сверены через API. Попытка Download/reset/run STM32 завершилась ST-LINK USB communication error до записи; сброс не подтверждён, штатный обмен панели работает.

## 25 октября 2026 — настройки, управление, FFT и АЧХ

- Linux Debug 15/15 и Windows Release 8/8. Проверены все редактируемые строки каналов, триггера, курсоров, DISPLAY, TIME, PROCESSING, PC, DEBUG, генератора, SETUP и АЧХ через события FUNC: видимые варианты переключаются нажатием; числовые строки входят в EDIT, вращение не меняет подтверждённое значение до применения, BACK отменяет. Проверены переходы SETUP → PRESETS → слот → BACK, PC CONNECTION, TIME SETTINGS и CALIBRATE обоих каналов. Отдельные проверки требуют одинакового направления TIME в обычной развёртке и ZOOM и нового направления сдвига окна ZOOM.
- Снимок настроек переносится целиком; недопустимый или неполный документ не применяется частично. Проверены запись до закрытия процесса, независимость пяти пресетов, выбор LAST/пресета, сохранение кривых АЧХ и чтение прежнего документа версии 1. SDL отклоняет старый диапазон панели при восстановлении и принимает подтверждение выбранного значения; просмотр CSV сохраняет параметры живого измерения и выбор STARTUP.
- FFT проходит проверки сохранения узкого пика при сжатии и интерполяции без превышения настоящего максимума при увеличении. Запись 1M при Fs 50 MSa/s использует FFT 524288 и определяет тестовый тон 10 кГц с ошибкой менее 3 Гц; это тест программного набора. Проверены координаты FFT-курсоров и касаний после перестановки окон. Просмотрены рендеры большого спектра, компактного SETUP, PRESETS и графика АЧХ.
- ChannelResponse проверяет сортировку и уточнение точек, относительную нормировку, границы коррекции, независимость каналов и неизменность исходного буфера. Для двух тестовых тонов проверено раздельное усиление/ослабление и отсутствие дополнительного тона. Проверены оценка частоты и амплитуды по FFT, рост графика, STOP, включение коррекции и отдельные реальные/симулированные банки. SDL отвергает насыщенные записи и шум без выраженного тона; при сборе АЧХ коррекция обходится.
- На Zynq оба канала SIMULATION собрали по 13 точек от 100 Гц до 1 МГц. Точки 100 кГц и 1 МГц уложились в допуск теста 4% по частоте и 1,2 дБ относительно заданного ФНЧ; это проверка программного источника через обработчик платы, не измерение аналоговой АЧХ. На синусе 500 кГц включение коррекции изменило экранный размах CH1 с 78 до 385 пикселей и CH2 с 258 до 505; кривые и включение коррекции восстановились после перезапуска GUI. Максимум полного обмена 20 запросов ping через UART составил 204 мс; задержка физической кнопки этим не измерялась. Графики из framebuffer просмотрены.
- На плате сохранены и загружены все пять слотов с различными диапазонами, положением, развёрткой и фильтром. LAST восстановил параметры после обычного перезапуска и после SIGKILL без штатного закрытия. Перезагрузка Linux с STARTUP=3 восстановила третий пресет. Прогон выявил оставшийся после SIGKILL управляющий сокет; после исправления службы повторный запуск прошёл. По завершении проверок полный исходный документ пользователя восстановлен, значения сверены через API.
- STM32 прошита через подтверждённый владельцем ST-Link: Erase Done, Programming Done, Verify OK, Application running с включённым Reset and Run. Исходники STM32 в этой задаче не менялись.
- Итоговые BOOT.BIN (3 129 464 байта) и image.bin (7 253 552 байта) записаны через COM4. После перезагрузки SHA-256 чтения MTD совпали: BOOT `3b79a08534ef0a3829ce8603693df497d73420f852e1cccebe802f386f9702ad`, FIT `15b63b943b4ebd067f429ff6cb0ed1e2c1e53447b31de35d2a924b94f049061e`. SHA-256 запущенного GUI `082f6b164dfd4e5ff2c5eaf741f6b5400eb36438f4c91bf02e8a16b32edddbe2` совпал с ARM-сборкой. Release прошёл verify_release.py. После итогового обновления STM32 снова прошита с Verify OK и reset/run; GUI подтвердил смену диапазона и его возврат. Проверен framebuffer большого спектра с SIMULATION SINE, FFT 32768 и шкалой от нуля; полный исходный документ восстановлен и сверён через API.

## 25 октября 2026 — независимый интерфейс, доступность и индикация захвата

- Linux 16/16, Windows Release 9/9 и ARM-сборка. Новый тест намеренно останавливает построение графика и вывод дисплея: сто изменений органов управления завершаются независимо от них, ожидающие снимки объединяются, результат соответствует последнему состоянию. Проверены неизменность арендованных карт, перенос указателей и строк, отказ вывода и сохранение последнего обновления при удержании старых графических слотов. Метка показанной записи меняется только после подтверждения вывода, а не готовности графика.
- Модель меню проверяет недоступные строки и варианты, пропуск их энкодером, пустые пресеты, отсутствие коррекции без АЧХ, FILES, LAYOUT и удаление с подтверждением. Энкодеры CH1/CH2, TIME и TRIGGER проходят навигацию, EDIT, применение и BACK в своих меню; АЧХ сохраняет принадлежность каналу. Отдельно проверены яркость текущего следа и появление прошлых захватов при PERSISTENCE 4/8, цвета RUN/HOLD/STOP и отсутствие TIME в SETUP.
- На Zynq с реальным сигналом подтверждена дорогая повторная отрисовка PERSISTENCE 8: до разделения слоёв полный кадр занимал около 577–670 мс, из них вывод framebuffer около 13–15 мс. После разделения потоков во время листания меню измерены средние 53 мс в STOP и 58 мс в RUN для компоновки интерфейса вместе с выводом; локальный PING имел p95 24 и 29 мс. Пользователь менял масштаб в ходе последнего прогона; это наблюдение рабочего сценария, а не сравнение идентичных записей и не измерение задержки физической кнопки.
- На реальном входе три принудительных срабатывания в NORMAL проверены по независимым меткам приёма и вывода. Во всех случаях RUN включён, когда счётчик завершённой обработки ещё не вырос, и сохраняется до показа соответствующего графика. После подтверждения вывода возвращается HOLD. SINGLE останавливается после показа записи. Жёлтый HOLD и красный STOP сверены с framebuffer. Временные изменения масштаба и триггера после проверки возвращены.
- Итоговый release прошёл verify_release.py и содержит четыре предусмотренных файла. После записи через COM4 и перезагрузки чтением подтверждены SHA-256: BOOT `3b79a08534ef0a3829ce8603693df497d73420f852e1cccebe802f386f9702ad`, FIT `166ead7a683deab143c75ee35f393c9f9d6623d936e61f4a0ec03eb5b487260a` (7 291 880 байт). STM32 после обновления Zynq прошита через ST-Link: Erase Done, Programming Done, Verify OK, Application running с Reset and Run; исходники STM32 не менялись.
- SHA-256 запущенного GUI `38b4c88a4766d794e2f2490671f3546cf35a11f3c0156866d2399c027def102f` совпал с ARM-сборкой. После сброса STM32 проверены подтверждение другого диапазона и возврат исходного. При последующей сверке отличалась только развёртка; её не перезаписывали. Каналы, фильтры, глубина, триггер, SIMULATION OFF и RUN сохранились.

## 25 октября 2026 — выключенные каналы, фронты и ноль калибровки

- Linux с аппаратным адаптером 16/16, Windows Release 9/9, общий прогон GUI/STM32 22/22. SET_SCALE/SCALE принимает OFF=0; проверены отпускание маски 000, запоминание диапазона, отсутствие локального переключения реле энкодером выключенного канала, запоздалые подтверждения, reconnect и исходные состояния обычной/standalone сборок. Keil: 0 ошибок и предупреждений; check_project.py прошёл.
- Поиск фронта проверен на шумном меандре для RISING/FALLING/BOTH, разных начальных позициях, обоих каналах, коротких возвратах и быстрых разрешённых периодах. Отдельный тест добавляет к тону 2 МГц помеху 98 МГц при Fs 200 MSa/s: выбранный MEDIUM FILTER даёт правильное направление, исходные коды остаются неизменными.
- С реального CH1 ранее в этом прогоне сняты 131072 пары исходных отсчётов при Fs 200 MSa/s. Повторный поиск с MEDIUM FILTER по этой записи проверен в 258 начальных позициях и направлениях: противоположных средних склонов и пропущенных срабатываний нет, минимальная разность средних до/после — 29,25 кода. Это повторная обработка записи с платы, не измерение точности аппаратного момента запуска. После повторного подключения выраженный реальный меандр на входе не наблюдался; на текущей плате проверены 16 новых захватов SIMULATION SQUARE, по восемь для RISING и FALLING, с правильным направлением видимого фронта. Настройки возвращены.
- HIDE/SHOW в MEASURE проверен непосредственными вращением и нажатием FUNC, отдельно от DISPLAY/LAYOUT. Смена цифр, знака, единиц, OFF и -- сохраняет размеры таблицы в ROW/COLUMN и с обоими шрифтами. На плате двадцать последовательных снимков состояния в RUN дали одинаковые границы таблицы 575×62 пикселя.
- Проверены оценка нуля и RMS по четырём свежим кадрам, исключение повторного кадра, независимость каналов и реального/SIMULATION банков, шумовая поправка амплитуды, отбраковка шума и несовпадения коэффициента АЦП. Настройки версии 3 проходят полный перенос; версии 1 и 2 читаются с неизмеренным нулём/шумом. START после STOP оставляет точки, CLEAR удаляет только кривую и сохраняет ноль; красный признак CLEAR и недоступность нового замера при существующих точках проверены.
- Проверка на плате обнаружила попадание прежнего сигнала в первый кадр ZERO/NOISE. После исправления аппаратный mock требует отсутствия кадра до нового DMA при переходе к замеру каждого канала; прежняя запись в STOP по-прежнему доступна для пересчёта. Повторный прогон на Zynq дал CH1: ноль +0,0000569 В, шум 0,0141455 В RMS; CH2: −0,0000517 В и 0,0141304 В RMS. Это результаты программного источника через захват платы, не измерение реального замкнутого входа. Оба канала собрали точки АЧХ после замера, STOP/START сохранили их. Красная CLEAR POINTS проверена в framebuffer; полный исходный документ настроек восстановлен и сверён через API. Реальная компенсация нуля/шума в этом прогоне не измерялась и не включалась.
- Итоговые BOOT.BIN (3 129 464 байта) и image.bin (7 299 144 байта) записаны через COM4; после перезагрузки чтение MTD совпало с исходными SHA-256: BOOT `3b79a08534ef0a3829ce8603693df497d73420f852e1cccebe802f386f9702ad`, FIT `7f15eff24b3c7d3dbce579f41ea504a08feec8fa7ea7cc3d55cd61f86866c5a4`. SHA-256 запущенного GUI `df088d607dbd89824d96128a5bd41c3036f2f291f8dce93b613658691f82b06f` совпал с ARM-сборкой. Release содержит четыре требуемых файла и прошёл verify_release.py. После записи Zynq STM32 прошита через ST-Link с Verify OK и Reset and Run. Затем сверены подтверждения обоих диапазонов и все исходные пользовательские параметры через API.

## 25 октября 2026 — применение нуля и независимые разделы калибровки

- Linux 16/16 и Windows Release 9/9. Проверены три раздела CALIBRATION, вход и BACK энкодером канала, четыре свежие записи отдельно для ZERO/NOISE, независимые признаки готовности и сбросы. Сброс АЧХ сохраняет ноль и шум; сброс нуля сохраняет шум и точки АЧХ; сброс шума сохраняет АЧХ. Документ версии 4 переносит независимые результаты, версии 1–3 читаются, объединённый результат версии 3 становится двумя измеренными калибровками.
- Аппаратный mock проверяет пересчёт той же sequence в STOP: меняются координаты, MEAN и RMS, исходные коды остаются прежними; RESET точно возвращает исходное представление. Поправка другого коэффициента АЦП не применяется. Дополнительный NORMAL-захват синуса требует одновременно правильной метки и уровня +0,2 В на исправленной кривой при нулевой поправке +0,4 В: поиск триггера и отрисовка используют одну систему отсчёта.
- На Zynq сохранённый пользователем ноль CH1 +0,683470956 В проверен на одной остановленной реальной записи при 500 мВ/дел: сброс сместил среднюю экранную координату на −82,017578 пикселя, расчёт по геометрии — −82,016515. Это проверка применения существующей поправки; правильность измерения самого нуля и точность аналогового напряжения этим не подтверждались.
- На плате отдельно измерены ZERO и NOISE обоих каналов SIMULATION, затем набраны точки АЧХ. Последовательные сбросы нуля и шума сохранили точки и соседний результат; отдельный CLEAR удалил только АЧХ. Просмотрен framebuffer меню с ровно тремя разделами. Полный исходный документ пользователя, включая реальные калибровки, восстановлен; параметры сверены через API.
- Zynq записан через COM4. После перезагрузки чтение MTD подтвердило BOOT `3b79a08534ef0a3829ce8603693df497d73420f852e1cccebe802f386f9702ad` и FIT `6332860af2bee0e9544d91656d8060bea59f1a20a484c73c37d5896c87f610fb` (7 301 820 байт); SHA-256 запущенного GUI `82f89b07e30ccab44a3f82f80c2b06ae45af3e93727c5d49e4f8ae0bdc22ba9c` совпал со сборкой. STM32 затем прошита с Verify OK и Reset and Run, подтверждены диапазоны CH1 и OFF для CH2. Первое состояние после перезагрузки содержит прежние настройки и реальные калибровки. При последующей проверке CH1 NOISE уже переизмерен после запуска; новый результат сохранён, старым не заменялся.

## 25 октября 2026 — ступени калибровки, сглаживание и сохранение настроек

- Linux 16/16 и Windows Release 9/9. Проверены полный обход трёх ступеней ZERO/NOISE, четыре свежие записи на ступень, отдельное хранение результатов, ожидание фактического SCALE ACK, отбрасывание старого ACK, возврат исходного диапазона и сохранение прежних калибровок при отмене. Временный диапазон обхода не попадает в последнее пользовательское состояние. Новый абсолютный запрос диапазона заменяет прежнюю ожидающую команду восстановления.
- Автоматический фильтр проверен на известном шуме и ступеньке: дисперсия на плато уменьшается, выраженный фронт остаётся исходным. Ручной HIGH после него продолжает менять кривую. Исходные коды, RMS/FFT, другой канал и сильная нативная Peak Detect огибающая сохраняются. Это проверки программного источника и аппаратного mock, не измерение аналогового качества платы.
- Пустой, обрезанный, слишком большой документ и документ будущей версии проходят открытие, попытку SAVE, автосохранение и закрытие без изменения исходного файла. Обычное сохранение и повторное открытие сохраняют пять пресетов и LAST. QSPI-layout 4/4: составной файл заканчивается на 0xf00000 и не включает settings. Итоговый release проходит verify_release.py.
- На плате CH1 в SIMULATION прошёл ZERO и NOISE через подтверждённые 100, 500 и 5000 мВ, вернулся на исходный диапазон; отмена сохранила все прежние результаты. CH2 завершил ZERO с тремя результатами и возвратом диапазона, но опрос журнала пропустил промежуточные положения, поэтому полный аппаратный прогон обоих каналов не заявляется. После обращения владельца проверки с временной сменой SIMULATION/фильтров прекращены; последующие действия не восстанавливают проверочные снимки поверх текущих настроек.
- Итоговые BOOT (3 129 464 байта) и FIT (7 304 444 байта) записаны через COM4 и сверены чтением после перезагрузки: SHA-256 BOOT `3b79a08534ef0a3829ce8603693df497d73420f852e1cccebe802f386f9702ad`, FIT `ae0eb0531d5b441dfbc959874a4b92553d24a7133ed58e37dc8366cc0518e231`. Ошибка одного блока при передаче в RAM обнаружена до стирания, блок передан повторно; окончательный образ проверен целиком.
- Файл настроек в JFFS2 до обновления и после перезагрузки имеет один SHA-256 `a626cef1f76c500b31bef5b680c453543b2dac2cddd985debffaa75cf33beb9d`: содержимое сохранено побайтно. Затем STM32 прошита прежней прошивкой с Verify OK и Reset and Run. Подтверждены диапазоны работающего CH1 и OFF для CH2; SHA-256 запущенного GUI `085813a01cfee9026a750c8a98935346fcde1a78eba67d927c074fb473eea12f` совпал с ARM-сборкой. Последующие изменения владельца, включая включение CH1, сохранены без возврата старого состояния.

## 25 октября 2026 — сырой шум замкнутого входа CH1

Владелец замкнул BNC CH1 на землю. GUI остановлен; отдельная диагностическая
программа использовала штатные capture_zynq и control_serial. Диапазоны менялись
абсолютными командами с ожиданием SCALE ACK, настройки GUI и калибровки не менялись.
Коды получены напрямую из DMA без поправки нуля, сглаживания и фильтров. Первые
два блока после перенастройки исключены; следующие восемь дали 4 194 304 отсчёта
CH1 в каждой строке. Частоты здесь заданы конфигурацией PL, внешним частотомером
не измерялись. CH2 также записан в сыром потоке, но его BNC не был подтверждён
замкнутым, поэтому собственный шум CH2 этим прогоном не определяется.

При encode 100 МГц на ветвь и записи 200 MSa/s без прореживания:

В этом разделе A/B — имена FPGA: A соответствует физической ветви B схемы,
B — физической A. Соответствие уточнено по предоставленной владельцем схеме
XS1; таблица подключений — [ADC_CAPTURE.md](ADC_CAPTURE.md#подключение).
Данные сняты до исправления перестановки D3/D5 первого АЦП и задержки
диагностического захвата; их RMS характеризует принятые коды, а не только
собственный аналоговый шум АЦП. Исходные журналы сохранены для сравнения.

| мВ/дел | RMS AC, коды | Ветвь A, коды RMS | Ветвь B, коды RMS |
|---:|---:|---:|---:|
| 100 | 9,605 | 5,509 | 12,230 |
| 200 | 9,655 | 5,511 | 12,326 |
| 500 | 14,290 | 7,951 | 18,464 |
| 1000 | 14,280 | 7,947 | 18,449 |
| 2000 | 14,326 | 7,976 | 18,512 |
| 5000 | 15,630 | 9,141 | 20,124 |

- Межветвевой сдвиг средних объясняет только 0,01–2,5% общей дисперсии на этих
  диапазонах. Основной разброс остаётся внутри ветвей, прежде всего B.
- В отдельном сыром блоке 200 мВ/дел ветвь B имеет группы 88–95, 120–135,
  160–167 и редкие дополнительные коды. Расстояние 32 между группами даёт
  основание проверять разряд D5 и приём данных, но не доказывает место дефекта.
  Сырые блоки и коды в приборе не изменялись.
- Спектральная оценка четырёх сегментов по 65 536 отсчётов каждой ветви с окном
  Ханна обнаружила выраженную составляющую около 14,91 МГц при 500 мВ/дел.
  В полосе 14–16 МГц находится около 44,6% мощности ветви A и 40,8% ветви B.
  При 200 мВ/дел наиболее выраженная область около 36,8 МГц. Аналоговое
  возбуждение, помеха и синхронный артефакт приёма этим измерением не различены.
- Проверены также заданные encode 50, 25 и 12,5 МГц на трёх ступенях. Снижение
  частоты не устранило разброс: на 200 мВ/дел общие RMS составили 44,74, 54,46
  и 20,08 кода соответственно; ухудшение сосредоточено в ветви B. Это результаты
  диагностических режимов физического такта, а не обычной программной развёртки.
- Шесть сырых блоков по 1 048 576 байт переданы на ПК и проверены по SHA-256.
  Измерения, гистограммы и сырые блоки находятся в `ZYNQ7020/output/logs/`
  (`raw-noise-measured.jsonl`, `raw-noise-summary.json`, `raw-noise-*-clock*.bin`).
  После замера исходный диапазон возвращён, GUI запущен, подтверждён CH1 200 мВ
  и OFF для CH2. Файл настроек до замера и после запуска имеет один SHA-256
  `c95da6c154e8ca4da9f78894e4f54a44537e2a15a676af9b64ab688d31421de9`.
  Прошивка и FPGA не изменялись; причина разрядных выбросов пока не установлена.

## 25 октября 2026 — сырой шум замкнутого входа CH2

Владелец замкнул BNC CH2 и сообщил, что конденсаторы в его делителе не
установлены. Методика совпадает с измерением CH1: прямой DMA, без фильтров и
калибровочных поправок, восемь блоков после двух исключённых, 4 194 304 отсчёта
канала на настройку. Отсутствие конденсаторов — различие реальных трактов;
этот прогон не является контролируемым испытанием влияния их установки.

При заданном encode 100 МГц на ветвь, запись 200 MSa/s без прореживания:

Как и в измерении CH1, A/B ниже — имена FPGA, обратные физическим A/B схемы.

| мВ/дел | RMS AC, коды | Ветвь A, коды RMS | Ветвь B, коды RMS |
|---:|---:|---:|---:|
| 100 | 24,285 | 22,764 | 23,363 |
| 200 | 24,446 | 22,921 | 23,538 |
| 500 | 24,611 | 23,148 | 23,678 |
| 1000 | 24,784 | 23,338 | 23,841 |
| 2000 | 24,769 | 23,318 | 23,825 |
| 5000 | 25,737 | 24,467 | 24,702 |

- На штатном такте обе ветви шумят значительно, а смена аппаратной ступени
  мало меняет RMS в кодах. Средние ветвей на 200 мВ/дел — 134,915 и 119,692
  кода; разность нулей 15,223 кода не объясняет весь разброс.
- На 200 мВ/дел при encode 50 и 25 МГц общие RMS составили 50,240 и 48,068
  кода. Ветвь B даёт соответственно 60,585 и 59,966 кода RMS, включая выходы
  на 255. При encode 12,5 МГц A дала 0,946 кода RMS, B — 11,971, общий
  результат — 8,836. На этой частоте и двух остальных аппаратных ступенях
  A остаётся около 0,96–1,19 кода, B — 12,38–12,52 кода.
- Такая зависимость требует отдельно проверить фазу цифрового приёма при
  неизменном физическом такте АЦП. Одновременно изменение encode меняет режим
  самого АЦП и аналогового тракта, поэтому текущие измерения не доказывают
  конкретную ошибку FPGA или отсутствие конденсаторов как причину шума.
- Сохранены 15 наборов статистики и шесть сырых блоков по 1 048 576 байт,
  SHA-256 каждого блока после передачи совпал с прибором. Файлы находятся
  в `ZYNQ7020/output/logs/`: `raw-noise-ch2-measured.jsonl`,
  `raw-noise-ch2-summary.json`, `raw-noise-ch2-*-clock*.bin`.
  Исходный CH2 OFF восстановлен, CH1 остался на 200 мВ/дел. GUI запущен;
  настройки до замера и после запуска совпали побайтно, SHA-256
  `c95da6c154e8ca4da9f78894e4f54a44537e2a15a676af9b64ab688d31421de9`.
  Прошивка, FPGA и калибровки не менялись.

## 25 октября 2026 — фаза приёма и проверка входа N17 на CH1

Владелец снова замкнул BNC CH1. Из текущего routed DCP получены временные
конфигурации с изменением только фазы общего приёмного MMCM. Физический encode
оставался заданным 100 МГц на ветвь, диапазон — 200 мВ/дел; прямой DMA без
прореживания и обработки, 4 194 304 отсчёта CH1 на настройку после двух
исключённых блоков. Конфигурации загружались через FPGA manager в RAM,
QSPI не записывалась. GUI, статусный процесс и VDMA остановлены до загрузки.

| Фаза приёма, ° | FPGA A / физическая B, RMS кодов | FPGA B / физическая A, RMS кодов |
|---:|---:|---:|
| 148,5 (штатная) | 5,587 | 12,367 |
| 0 | 6,940 | 12,236 |
| 45 | 5,545 | 12,251 |
| 90 | 5,601 | 12,448 |
| 135 | 5,608 | 12,441 |
| 180 | 5,623 | 12,363 |
| 225 | 5,583 | 12,416 |
| 270 | 5,903 | 20,506 |
| 315 | 50,136 | 55,139 |

Изменение общей фазы не устранило основной разброс физической ветви A:
на широком участке фаз он остаётся около 12,3 кода RMS. Ухудшение при 270/315°
подтверждает влияние настройки, но тест не исключает все ошибки цифрового тракта.

На штатной фазе отдельно включены слабые PULLUP/PULLDOWN входа `adc0_b[5]`
старого XDC (N17 Zynq). Последующая сверка выявила ошибку назначения:
физически это ADC0_D3A, XS1.15, вывод 40 первого AD9288, а не D5A.
Результаты ниже относятся именно к входу N17.
Без повторного открытия панели, при неизменном диапазоне получены:

| Конфигурация | FPGA A / физическая B, RMS кодов | FPGA B / физическая A, RMS кодов |
|---|---:|---:|
| Без подтяжки, до теста | 5,624 | 12,350 |
| PULLUP N17 (физический D3A) | 5,607 | 12,349 |
| PULLDOWN N17 (физический D3A) | 5,583 | 12,219 |
| Без подтяжки, после теста | 5,587 | 12,222 |

Заметной зависимости от подтяжки нет; гипотеза полностью плавающего входа
FPGA этим не подтверждена. Это не проверка формы цифрового сигнала на рабочей
частоте и не доказательство исправности выхода АЦП. Владелец сообщил, что
цепь XS1.17 → D5A прозванивается. Группы кодов с шагом 32 остаются признаком
для диагностики, а не установленной неисправностью D5; маскирование бита
и коррекция сырых данных не применялись.

Журналы и статистика сохранены в `ZYNQ7020/output/logs/`:
`receive-phase-survey-single.log`, `receive-phase-survey-second.log`,
`d5-pull-survey-nopanel.log`, `receive-phase/measured-*.jsonl`.
После тестов обычная перезагрузка вернула штатную FPGA из BOOT. GUI получает
реальные данные; настройки сохранили SHA-256
`c95da6c154e8ca4da9f78894e4f54a44537e2a15a676af9b64ab688d31421de9`.
Чтение BOOT и FIT подтвердило прежние SHA-256 `3b79a085…` и `ae0eb053…`
из раздела об обновлении; итоговая проверка — `receive-phase-final.log`.

## 25 октября 2026 — таблицы АЦП при обоих замкнутых BNC

Владелец подтвердил замыкание обоих BNC на землю. Оба канала одновременно
переведены последовательно на 200, 500 и 5000 мВ/дел с ожиданием SCALE ACK:
это три рабочие аппаратные ступени, общие соответственно для 100/200,
500/1000/2000 и 5000 мВ/дел. После переключения обоих каналов выдержано
300 мс, исключены два первых DMA-блока, статистика собрана по следующим
восьми: 4 194 304 отсчёта канала, 2 097 152 на ветвь. Encode задан 100 МГц
на ветвь, запись 200 MSa/s без прореживания, фильтров и калибровочных поправок.

Ниже A/B соответствуют физической схеме. Ch0 = CH1 GUI, Ch1 = CH2 GUI.

| Ступень, мВ/дел | Ch0A RMS, коды | Ch0B RMS, коды | Ch1A RMS, коды | Ch1B RMS, коды |
|---|---:|---:|---:|---:|
| 100–200 | 8,698 | 4,171 | 23,115 | 22,434 |
| 500–2000 | 18,488 | 8,074 | 19,763 | 19,985 |
| 5000 | 21,415 | 9,487 | 20,666 | 20,982 |

С каждой ступени передан один сырой блок по 1 048 576 байт; SHA-256 после
передачи совпал с прибором. Из начала каждого блока без прореживания и
сортировки выведены по 2048 последовательных отсчётов четырёх физических
ветвей. Восемь столбцов: Ch0A dec/bit, Ch0B dec/bit, Ch1A dec/bit, Ch1B dec/bit.
Двоичные значения — текст D7…D0 с ведущими нулями, десятичные — числовые коды
0–255. Шаг строк по заданному такту — 10 нс, ветвь B опережает A в одной
строке на 5 нс. Таблица не представляет одновременную выборку A/B.

Excel содержит три листа исходных отсчётов, сводку полной статистики и
статистику показанных 2048 отсчётов, активность битов. Доли единиц рассчитаны
по всем восьми блокам, переходы — по одному сохранённому блоку. Поля
dec/bit проверены попарно, сводка 2048 отсчётов сверена независимым расчётом,
полная статистика — по гистограммам. Сырые файлы, CSV, статистика и Excel
сохранены в `ZYNQ7020/output/logs/adc-both-short-2026-10-25/`.

После замера возвращены CH1 200 мВ/дел и CH2 OFF, GUI получает реальные
данные. Настройки сохранили SHA-256
`c95da6c154e8ca4da9f78894e4f54a44537e2a15a676af9b64ab688d31421de9`.
QSPI, конфигурация FPGA и калибровки этим замером не изменялись.

## 25–26 октября 2026 — исправление разрядов и медленных таймингов АЦП

Оба BNC замкнуты владельцем. A/B в этом разделе — физические ветви схемы;
Ch0 соответствует CH1 GUI, Ch1 — CH2 GUI. Все RMS ниже вычислены относительно
среднего каждой ветви по исходным кодам, без фильтрации, ZERO/NOISE и
программного прореживания. Они характеризуют принятые коды; разделение
аналогового шума, помех и остаточных ошибок преобразования требует измерений
на плате. Предыдущие таблицы относятся к прежнему назначению выводов;
старые результаты на делённом encode дополнительно затронуты ранней фиксацией.

### Назначение выводов и подтверждённые исправления

Связность 32 линий данных прослежена от выводов AD9288 через исходную
схему основной платы, XS1 и CAM1 до схемы MINI и XDC. Найдено одно
расхождение: D3A и D5A первого АЦП переставлены в XDC.

| Сигнал DA1 | Вывод AD9288 | XS1 | CAM1 | Сеть MINI | Вывод Zynq |
|---|---:|---:|---:|---|---|
| D3A | 40 | 15 | 33 | GPIO23P_34 | N17 |
| D5A | 42 | 17 | 32 | GPIO8P_34 | W14 |

В `adc.xdc` исправлены назначения `adc0_b[3]` и `adc0_b[5]`; логические
имена A/B FPGA по-прежнему обратны физическим A/B схемы. Остальные 30
линий совпали. Такты также совпали: физический ENCA, вывод 47 обоих АЦП,
идёт через R2, XS1.4, CAM1.2 к U15 (`adc_clk_b`); ENCB, вывод 14 — через R1,
XS1.3, CAM1.39 к P15 (`adc_clk_a`). По схеме DFS/4 и S2/9 соединены с GND,
S1/8 — с 3V3. Это проверка документации и назначения FPGA, не измерение
электрических уровней. Таблицы сверки — `pin-audit.csv`, `clock-audit.csv`.

Перестановка D3/D5 меняет код на ±24 при различии этих разрядов и не меняет
его при их равенстве. Предыдущая гипотеза неисправного D5 по расстоянию
между группами гистограммы была недостаточной. Повторная интерпретация
старых сырых данных перестановкой только этих двух битов устраняет группы;
контроль на плате при неизменных 500 мВ/дел и encode 100 МГц дал Ch0A
18,498 → 6,972 кода RMS, Ch0B 7,831 → 7,831. Диагностическая перестановка
использована только для сравнения; в штатном захвате нет маскирования битов
или программной подмены данных.

Второе исправление касается делённого физического encode. Приёмник при
этом остаётся на 100 МГц, поэтому уменьшение encode не увеличивало задержку
после фронта до фиксации пары. Условие `period/2 + 2` заменено на
`period/2 + 3` с приведением по периоду. Нативное условие при encode 100 МГц
не изменено. В RTL-модели с возвратным путём 13 нс прежний вариант смешивает
соседние поколения A/B; новый проходит обе модели 6/13 нс на всех семи
частотах. Задержки модели не объявляются измерением платы.

### Повторный замер после прошивки штатной сборки

При encode 100 МГц на ветвь и записи 200 MSa/s статистика собрана по восьми
DMA-блокам после двух исключённых, по 2 097 152 отсчёта каждой ветви.
Перед сменой ступени получены SCALE ACK обоих каналов и выдержка 300 мс.

| Ступень, мВ/дел | Ch0A RMS | Ch0B RMS | Ch1A RMS | Ch1B RMS |
|---|---:|---:|---:|---:|
| 100–200 | 4,426 | 4,772 | 23,805 | 23,459 |
| 500–2000 | 6,980 | 7,788 | 20,117 | 20,529 |
| 5000 | 9,314 | 9,526 | 21,060 | 21,451 |

С каждой ступени передан сырой блок 1 048 576 байт, SHA-256 совпал с
прибором. В новой Excel-таблице — по 2048 последовательных кодов каждой
ветви в запрошенных восьми столбцах dec/bit, полная статистика, активность
битов и шесть распределений с шагом один код. Двоичные строки содержат
ровно восемь знаков D7…D0; десятичные значения числовые. Проверены все
пары dec/bit, CSV, формульная статистика 2048 строк и 256 частот каждой
гистограммы. Файл находится в
`ZYNQ7020/output/logs/adc-verified-2026-10-25/outputs/adc-verified-20261025/adc_noise_verified_2026-10-25.xlsx`.
Исходные блоки, manifest и JSON — в родительском `adc-verified-2026-10-25/`.

Дополнительно выполнены все 21 сочетание трёх ступеней и семи физических
encode: 100; 50; 25; 12,5; 6,25; 3,125; 1,5625 МГц. На сочетание —
262 144 отсчёта каждой ветви в статистике и один сохранённый блок
131 072 байта с проверкой SHA-256. Пример для 500 мВ/дел:

| Encode, МГц | Ch0A RMS | Ch0B RMS | Ch1A RMS | Ch1B RMS |
|---:|---:|---:|---:|---:|
| 100 | 7,000 | 7,804 | 20,093 | 20,512 |
| 50 | 6,595 | 6,412 | 17,361 | 16,751 |
| 25 | 5,803 | 6,745 | 8,887 | 13,143 |
| 12,5 | 5,526 | 5,954 | 1,016 | 1,051 |
| 6,25 | 5,734 | 6,062 | 0,873 | 0,952 |
| 3,125 | 5,662 | 6,032 | 0,878 | 0,969 |
| 1,5625 | 5,691 | 5,927 | 0,869 | 0,956 |

Частоты менялись физически, не выбором редких отсчётов. Каждый сохранённый
блок содержит последовательные нативные коды. Между отдельными блоками
малого размера при большой скорости встречается флаг DISCONTINUITY:
CPU не успевает за всеми готовыми блоками. Такие границы исключены из
подсчёта соседних скачков; непрерывность всех восьми блоков не заявляется.
Гистограммы и RMS не используют соседство на границе блоков. Полные данные —
`ZYNQ7020/output/logs/adc-verified-slow-2026-10-25/`.

### Фаза приёма, электрические настройки и остаточный разброс

На исправленном назначении повторно проверен общий приёмный MMCM при
неизменном encode 100 МГц и исходно подтверждённых 500 мВ/дел обоих каналов.
На конфигурацию — 262 144 кода каждой ветви. Менялась только фаза приёмника;
начальный и конечный штатные контроли выполнены в каждом прогоне.

| Фаза, ° | Ch0A RMS | Ch0B RMS | Ch1A RMS | Ch1B RMS |
|---:|---:|---:|---:|---:|
| 148,5, штатная | 6,995 | 7,844 | 20,375 | 20,660 |
| 0 | 6,982 | 8,695 | 20,346 | 20,621 |
| 45 | 6,965 | 7,824 | 20,358 | 20,605 |
| 90 | 6,928 | 7,771 | 20,194 | 20,448 |
| 135 | 6,997 | 7,857 | 20,369 | 20,634 |
| 180 | 6,984 | 7,852 | 20,115 | 20,573 |
| 225 | 6,960 | 7,805 | 20,167 | 20,515 |
| 270 | 15,627 | 8,614 | 28,487 | 23,487 |
| 315 | 47,506 | 46,259 | 54,817 | 45,104 |
| 148,5, конечный контроль | 7,025 | 7,863 | 20,445 | 20,717 |

Фаза влияет на приём и на 270/315° заметно ухудшает его, но широкий участок
0…225° не устраняет разброс CH2. Переход на другую общую фазу в штатный
образ не включён. Для 90° сохранена статистика; передача сырого блока
прервалась ошибкой CRC UART. Остальные сырые блоки прогонов переданы с
проверкой SHA-256. Повторный прогон передавал их частями при временно
подавленном выводе kernel warnings в UART. Это изменение только сеанса
диагностики, оно исчезает при перезагрузке.

Отдельно сравнены SLEW SLOW, DRIVE 8/12 мА выходов такта, LVTTL на входах
и слабые PULLUP/PULLDOWN всех данных. Значимого устранения разброса не
получено. Штатные LVCMOS33 без подтяжек, DRIVE 4 мА и SLEW FAST сохранены.
Приёмные регистры находятся в IOB; проверка NSTD/UCIO/BIVC не дала нарушений.

В спектральной оценке одного нативного блока 500 мВ/дел, окно Ханна,
четыре сегмента по 65 536 кодов ветви, у CH1 выражена область около
12,525 МГц: примерно 45–47% мощности находится в полосе ±1 МГц вокруг
наиболее сильного пика. У CH2 распределение шире: максимумы около
35,4–35,9 МГц, в такой же полосе около 8%. Частоты — по заданному такту;
это не аналоговое измерение спектра перед АЦП. Переход на медленный encode
меняет режим преобразования и алиасы внешних помех одновременно.

Подтверждены исправление одной перестановки битов и ранней фиксации при
делении encode. Остаточный разброс CH2 на высоком такте ими не устранён;
данные не доказывают конкретный дефект микросхемы или аналогового тракта.
Для аппаратной проверки приоритетны форма тактов непосредственно на
ENCA/47 и ENCB/14 второго AD9288, питание и опора с оценкой ВЧ-пульсаций,
затем дифференциальные входы AINA/2–3 и AINB/11–10 при замкнутом BNC.
Нормальные DC-значения опоры не проверяют эти ВЧ-режимы.

### Сборка, запись и границы проверки

- Все девять RTL-тестов прошли, включая новый `ad9288_settle_tb`; до
  исправления новая модель с задержкой 13 нс воспроизводит смешение A/B.
- Полная штатная FPGA собрана из RTL/XDC, не из диагностической ECO.
  Первый opt_design завершился EXCEPTION_ACCESS_VIOLATION Vivado 2019.1;
  повтор той же реализации без изменения настроек прошёл. Итоговый STA:
  WNS 0,147 нс, WHS 0,011 нс, нарушений заданных ограничений нет. Это расчёт
  с принятым бюджетом задержек платы, не измерение её timing margin.
- FSBL/standalone и Linux ARM/GUI/FIT собраны, `verify_release.py` пройден.
  В `ZYNQ7020/output/linux/` оставлены только BOOT.BIN, image.bin,
  qspi.bin и fsbl.elf. Размер qspi.bin — 15 МиБ, область settings исключена.
- BOOT и FIT записаны через COM4 и проверены чтением после перезагрузки:
  BOOT 3 190 840 байт, SHA-256
  `651d39ea5eaea0b400b9ed77695bc2ab6e7b8f6e07738966cb457bccf9d12314`;
  FIT 7 304 432 байта, SHA-256
  `8e9752a4ba07b441695d4b029e11bb4cab09f1b8e99dce57b5da6017daa9e379`.
- Файл настроек до/после записи и измерений сохранил SHA-256
  `c95da6c154e8ca4da9f78894e4f54a44537e2a15a676af9b64ab688d31421de9`.
  Калибровки оставлены прежними; исправление кодов само по себе не
  подтверждает пригодность ранее измеренной калибровки CH1.
- Попытки перезапуска STM32 через Keil/ST-Link завершились ошибкой USB до
  стирания. OpenOCD видит ST-Link V2J37S7 и около 3,20 В на target, но не
  подключается к ядру даже при 100 кГц и connect under reset. Успешный
  reset STM32 не подтверждён; её прошивка не изменена. В сеансах с
  работающим USB получены SCALE ACK обоих каналов. После многократной
  полной загрузки PL встречались отключения CH341 и ошибки USB -110;
  неудавшиеся переключения диапазона не включались в таблицы замеров.

Сводные журналы, сравнения конфигураций, проверка схемы и сборки —
`ZYNQ7020/output/logs/adc-diagnostic-2026-10-25/`. Наборы `native-phase/`
и `native-phase-remaining/` дополняют друг друга. Временные конфигурации
загружались в RAM; возврат штатной FPGA выполняется перезагрузкой из QSPI.
После последнего фазового прогона подтверждены штатная FPGA из QSPI,
CH1 200 мВ/дел, CH2 OFF, SIMULATION OFF и `panel_scale_valid=3`.
За две секунды `waveforms` вырос с 688 до 697; BOOT/FIT повторно совпали
с указанными SHA-256, настройки — с исходным C95D…21DE9. Журнал —
`adc-diagnostic-2026-10-25/final-health.log`.

## 26 октября 2026 — обновление аппаратного экрана и измерения 11 кГц

- Linux x86-64 Release: 16/16 CTest; Windows x64 Release: 9/9 CTest.
  ASan/UBSan проверили фильтр, обработку, аппаратный адаптер и рендерер.
  Проверки пикселей обычного экрана, меню, FFT, persistence и АЧХ совпали
  с предыдущим растеризатором при одинаковых данных. ARMv7 GUI и Linux FIT
  собраны штатным Buildroot toolchain; проверен `verify_release.py`.
- Регрессии проверяют поиск редких импульсов во всех глубинах и режимах,
  фильтрацию у границ окна и восстановление стороны гистерезиса через длинную
  паузу внутри шумовой полосы. Медленная обработка искусственно блокируется:
  следующие восемь DMA-блоков должны быть получены и освобождены, ожидающие
  записи заменены, а после разблокирования должен прийти актуальный кадр.
- Дополнительный тест воспроизводил ложный триггер при обрезании доступных
  posttrigger-отсчётов перед фильтром: импульс 16 отсчётов с кодом 180 на фоне
  100 не пересекает 128 через среднее по 65 точкам, но усечённое окно создавало
  пересечение. До исправления тест падал, после — короткий импульс отклонён,
  следующий широкий импульс принят. Проверена также очистка карт при повторном
  выключении канала и отсутствие лишней композиции старого графика.
- Синтетические записи с ВЧ-помехой проверяют 11/18 кГц и 1 МГц, разные фазы,
  duty 1/25/50/75/99% при разрешимых выбранным фильтром импульсах. Проверены
  100 МГц без фильтра, DC, недостаточный интервал, нерегулярный шум и смена
  частоты без межкадрового сглаживания. Амплитудные суммы, RMS и экстремумы
  отдельно сверяются с исходными кодами; FFT и форматы BMP/CSV сохранены.
- Через UART COM4 сняты восемь аппаратных блоков по 100K пар отсчётов.
  SHA-256 набора: `d5eed3baac86281df6be1e193b0d90a3a926fac31010f2fa25873101a96929b7`.
  Перебраны 56 окон по 40K отсчётов с разными началами: новая оценка держалась
  около 11,002 кГц и 50% duty. Частота рассчитана по заданным 200 MSa/s.
- Проверка непосредственно на приборе: SIMULATION OFF, CH1 ON, CH2 OFF,
  2 В/дел, 20 мкс/дел, глубина 100K, FILTER MEDIUM, FFT OFF, AUTO/RISING, уровень 0 В.
  Контрольный опрос фактически показанных записей дал медиану 95 мс,
  90-й процентиль 159 мс, максимум наблюдаемых интервалов 186 мс.
  Опрос может пропустить промежуточное представление; это не гарантия
  периода не более 100 мс. Частота составила 11,0017–11,0049 кГц,
  duty 49,992–50,020%; владелец подтвердил устойчивое показание.
  Пробы GUI устанавливались только в RAM, настройки между установкой и
  контрольным опросом сохраняли SHA-256. QSPI этим сеансом не записывалась.
  После контрольного переключения на 20 мкс/дел возвращены исходные
  200 мкс/дел; файл настроек до/после совпал:
  `ee510e807a9a00396b016ffbe8dedc7678328fe601c5e646f1d52c2986a61686`.
  SHA-256 исполняемого GUI в RAM, целевом rootfs и собранном FIT совпал:
  `eee61d322382d49f25d80555bfdc34c6687ddb063a5561d2bc8e7a711530f1cf`.
- Журналы и исходная запись остаются в игнорируемом `ZYNQ7020/output/logs/`.
  Результат прошивки — только BOOT.BIN, image.bin, qspi.bin и fsbl.elf
  в `ZYNQ7020/output/linux/`; временные профилировочные сообщения удалены.

## 26 октября 2026 — напряжения Measurements

- Linux x86-64 Release: 16/16 CTest; Windows x64 Release: 9/9 CTest.
  ASan/UBSan проверили фильтр, статистику и повторную обработку записи.
  ARMv7 GUI/FIT собраны; состав QSPI проверен `verify_release.py`.
- На фотографиях владельца отфильтрованная кривая и курсоры показывали около
  2,47 В между уровнями меандра, тогда как Vpp достигал 7,01 В. Проверка кода
  подтвердила, что старые MIN/MAX включали исходные Peak Detect экстремумы,
  даже когда ручной FILTER убирал их из отображаемого источника.
- Тесты сравнивают MIN/MAX, среднее и RMS с полной численной фильтрацией
  исходных отсчётов, включая обрезку видимого окна и его границы. Крайние
  нативные min/max 0/255 не влияют на напряжения вручную отфильтрованного
  канала. FFT, исходные коды и raw_mean/raw_rms при смене FILTER неизменны.
- Проверен FILTER OFF с автоматическим подавлением шума: нативные интервалы
  с малым шумовым размахом подавляются независимо от полного размаха меандра.
  Объединение в окно Measurements или экранную колонку не восстанавливает
  шумовую огибающую у фронта; видимые сильные пики по-прежнему сохраняются.
- Интеграционный тест передаёт калибратору разные исходные и сглаженные
  mean/rms: NOISE обязан сохранить исходную дисперсию. Проверка АЧХ также
  использует отдельную исходную статистику при оценке шума и отбрасывании
  неподходящей записи.
- Проверка в RAM прибора: CH1 ON, CH2 OFF, SIMULATION OFF, 50 мкс/дел,
  100 MSa/s, глубина 100K, FILTER MEDIUM. В опросе Vpp составил 2,79–3,05 В,
  RMS 1,188–1,195 В. В одном контрольном окне расчёт по полным обработанным
  отсчётам дал Vpp 2,885 В и RMS 1,1936 В, экспортированные 1024 точки —
  Vpp 2,833 В и RMS 1,1951 В. У экспорта другая дискретизация и округление
  до пикселей; он не используется источником Measurements. Владелец
  подтвердил соответствие чисел кривой.
- Исходная статистика того же окна сохранила RMS 1,3032 В. Таким образом,
  исправление убирает из Measurements подавленную обработкой составляющую,
  сохраняя её в статистике калибровки. Образы обновлены отдельно от RAM;
  запись прошивки в QSPI этим сеансом не выполняется.
- Конечная версия повторно проверена при выбранных владельцем 5 В/дел:
  для 20 мкс/дел медиана наблюдаемых обновлений 108 мс, 90-й процентиль
  158 мс. Затем возвращены исходные 50 мкс/дел, файл настроек до/после
  совпал: `4121d97f2c7626b347e68831aba82ea450bcfa9cb1579537396b4b7f1a105802`.
  GUI в RAM, rootfs и итоговом FIT совпал по SHA-256:
  `0c7cbf9fc2f825dd3461d9e73c3fee868549830b1e622194c525de57aa8bebfc`.

## 27 октября 2026 — общий отбор триггера и сохранение первого кадра

- Linux x86-64 Release: 16/16 CTest; Windows x64 Release: 9/9 CTest.
  Аппаратный mock проверяет все пять глубин записи, оба фронта, границы
  блоков, разрывы последовательности, noisy A/B, MMX1/MMX2/MMX3 и отсутствие
  поддержки SET_PROBE. Проверено сохранение первого готового кадра до показа,
  ограничение двух одновременно принятых записей и накопление глубокой
  предыстории во время занятости вывода. ASan/UBSan прошли аппаратный mock.
- RTL: 13/13 стендов. Оконные суммы/дисперсии сверяются с точным расчётом
  17 отсчётов; MMX1/MMX2/MMX3 — с ожидаемым заголовком. Проверка LOW/HIGH
  сравнивается с Wiener-оценкой для обоих каналов, raw/Peak Detect, сырого
  и среднего режимов, коротких импульсов, шума, остановок AXIS и reset.
  Все стороны, достигнутые эталонной обработкой, обязаны сохраниться.
- Финальная трассировка с post-route phys_opt: WNS +0,032 нс, WHS +0,005 нс;
  все заданные timing constraints выполнены. ARM GUI и ядро с SET_PROBE
  собраны. BOOT/FIT/QSPI прошли `verify_release.py`.
- Ядро и GUI загружены через COM4 только в RAM. GPIO `0x89E70405`
  подтвердил передачу конфигурации проверки через новый драйвер при 50 MSa/s.
  Файл настроек сохранил SHA-256
  `4f99822c1f8ebb3883b9d2031ec73bb798fce8eedc6bd50f7c7f711eddebd36a`.
  GUI в RAM, rootfs и итоговом FIT совпал по SHA-256:
  `8a6bc9f31af38e3f38586e31dbcb2869fbbf3bd2d0a32990b8473093f5a7ecc8`.
  QSPI этим сеансом не записывалась.
- Новый bitstream загружен через fpga_manager в RAM, состояние `operating`;
  конфигурация HDMI восстановлена после полной смены PL. В NORMAL/FALLING,
  CH1, FILTER MEDIUM, FFT OFF, 100K измерены фактические показы renderer:
  два запроса счётчиков с паузой 10 с, без опроса состояния между ними.

  | Развёртка, мкс/дел | Fs, MSa/s | Показов | Средний интервал, мс | Пропущено DMA-блоков |
  |---:|---:|---:|---:|---:|
  | 20 | 200 | 70 | 144,53 | 6024 |
  | 50 | 100 | 69 | 146,76 | 2283 |
  | 100 | 50 | 78 | 127,89 | 805 |
  | 200 | 20 | 93 | 108,76 | 168 |

  Во всех четырёх интервалах `source_error=0`, `capture_overwritten=0`;
  MMX3 принимался во всех учтённых блоках после прогрева. Пропуски относятся
  к DMA-блокам, не к числу входных событий. На 20 мкс/дел до MMX3 тот же
  способ измерения дал 319 мс. Цель устойчивого периода не более 100 мс
  пока не достигнута: точный поиск, часть обработки и измерения остаются
  на ARM. Эти результаты не подтверждают полностью аппаратный триггер
  или отсутствие мёртвого времени. После обхода восстановлена исходная
  развёртка 100 мкс/дел; SHA-256 файла настроек совпал.
- Отдельно, с остановленным GUI, новый PL/драйвер прошёл по два 3-секундных
  DMA/lease прогона при 200/100/50 MSa/s с размером payload для 100K.
  Получено 400,12–400,15 МБ/с на двух старших частотах и 200,06–200,07 МБ/с
  на 50 MSa/s, без sequence gaps во всех шести прогонах. Удерживаемый
  leased-буфер не менялся, CONFIGURE при lease возвращал EBUSY. Это проверка
  передачи и владения памятью, не точности АЦП и не обработки GUI с той же
  пропускной способностью.
