Coal56AB/Oscilloscope/docs/zynq7020/ZYNQ_MINI_REVB Schematic.pdf

# 1.0V电源

# 第一部分 ZYNQ的电源系统

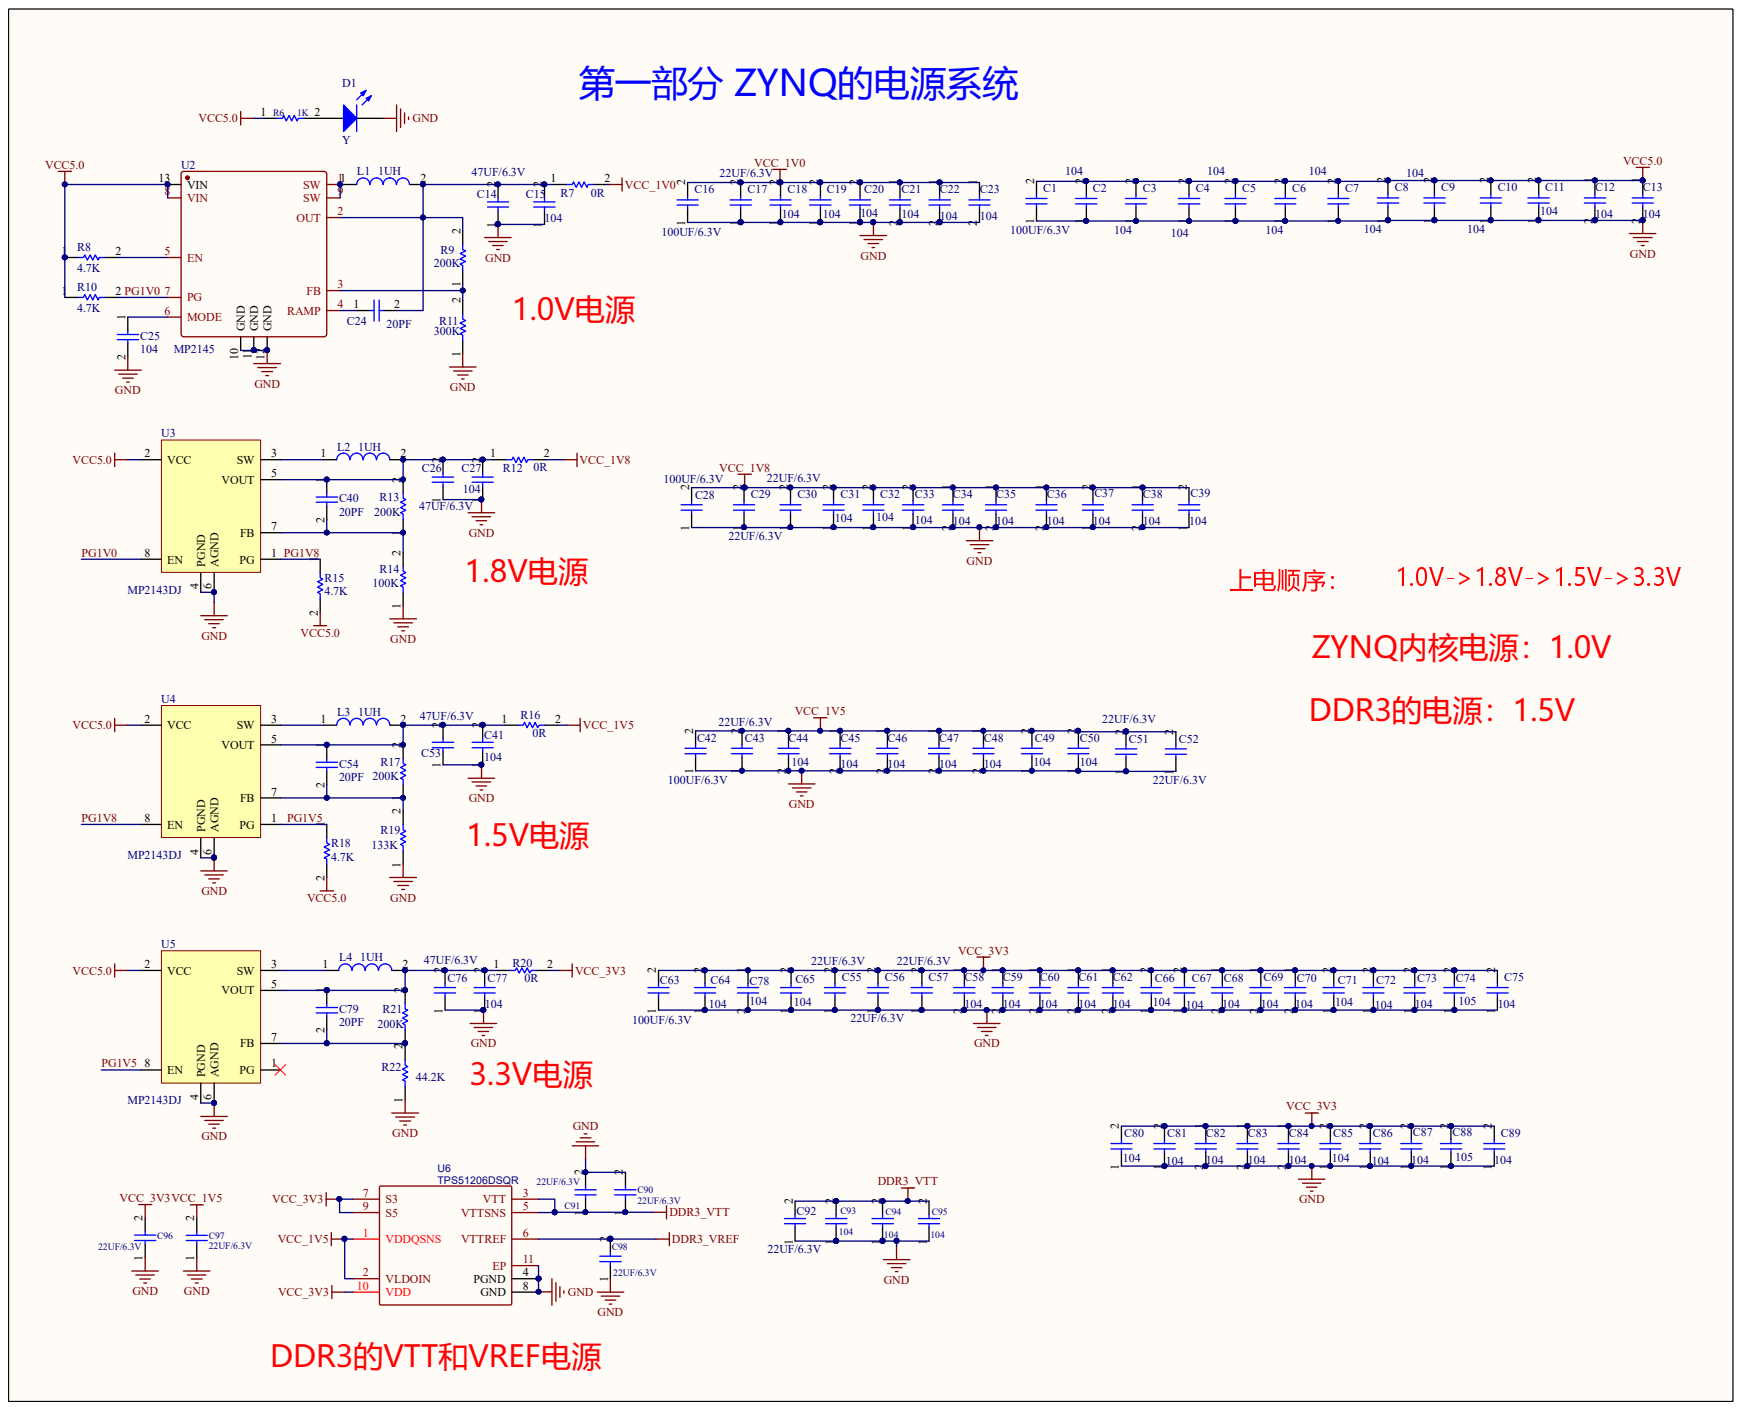
[picture p3: page 1]

## VCCINT_1 R13

## VCCO_0 K6

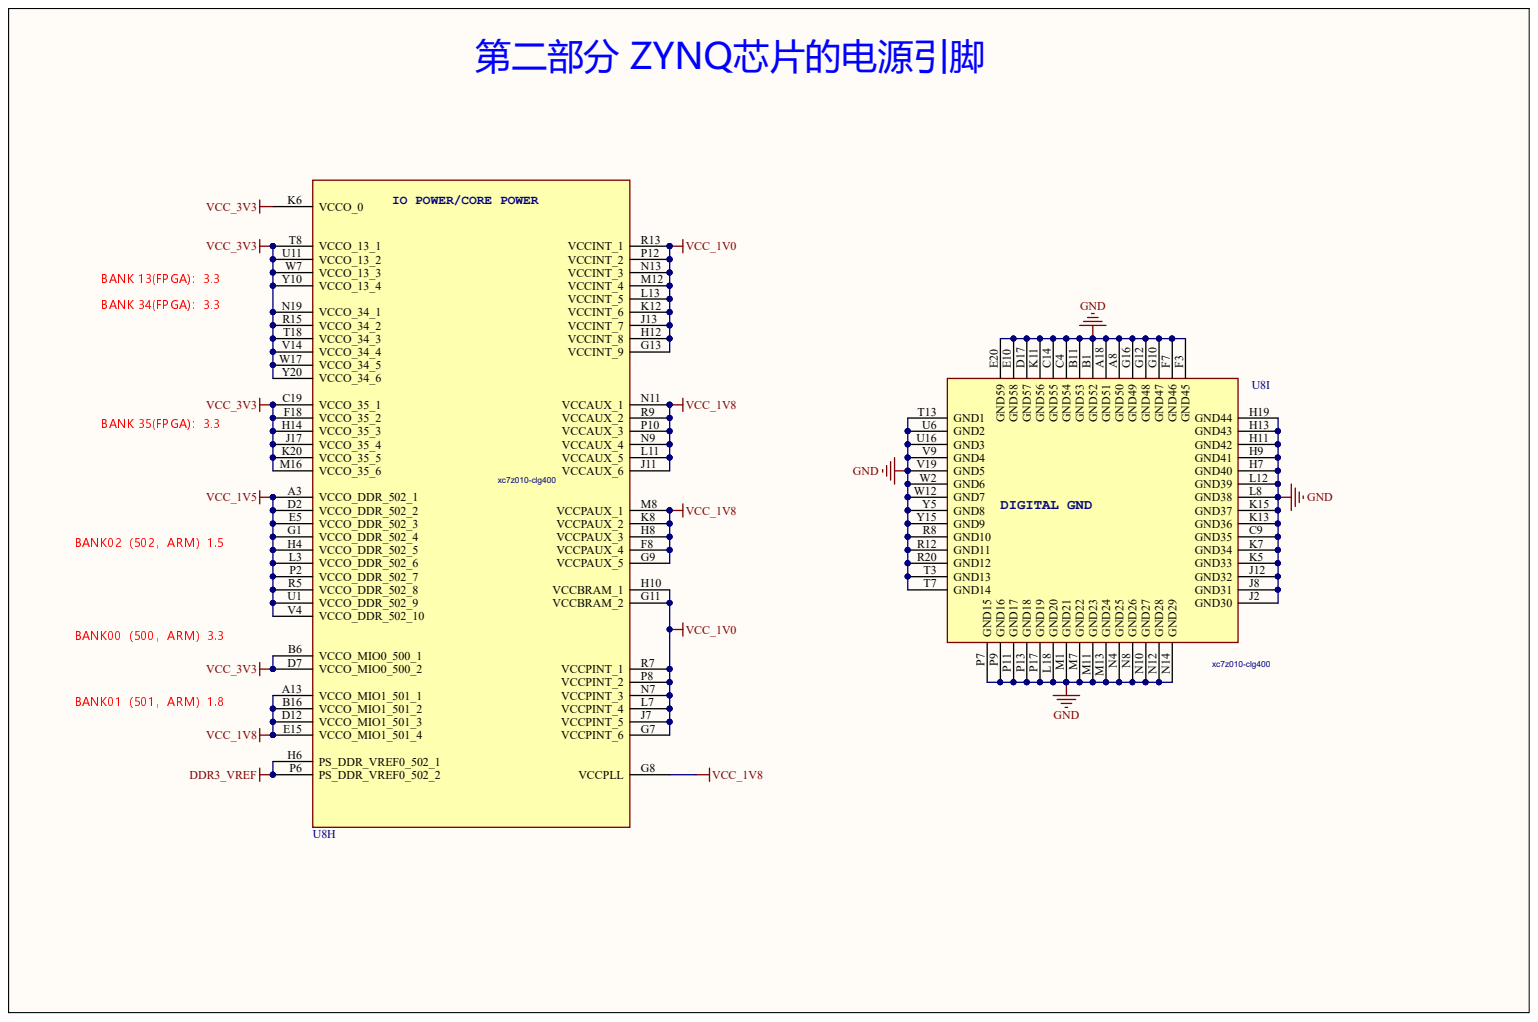
[picture p4: page 2]

IO POWER/CORE POWER

## 上电复位芯片，检测到3.3电源电压就绪产生一个拉低复位

# 第三部分 ZYNQ的JTAG和调试器电路

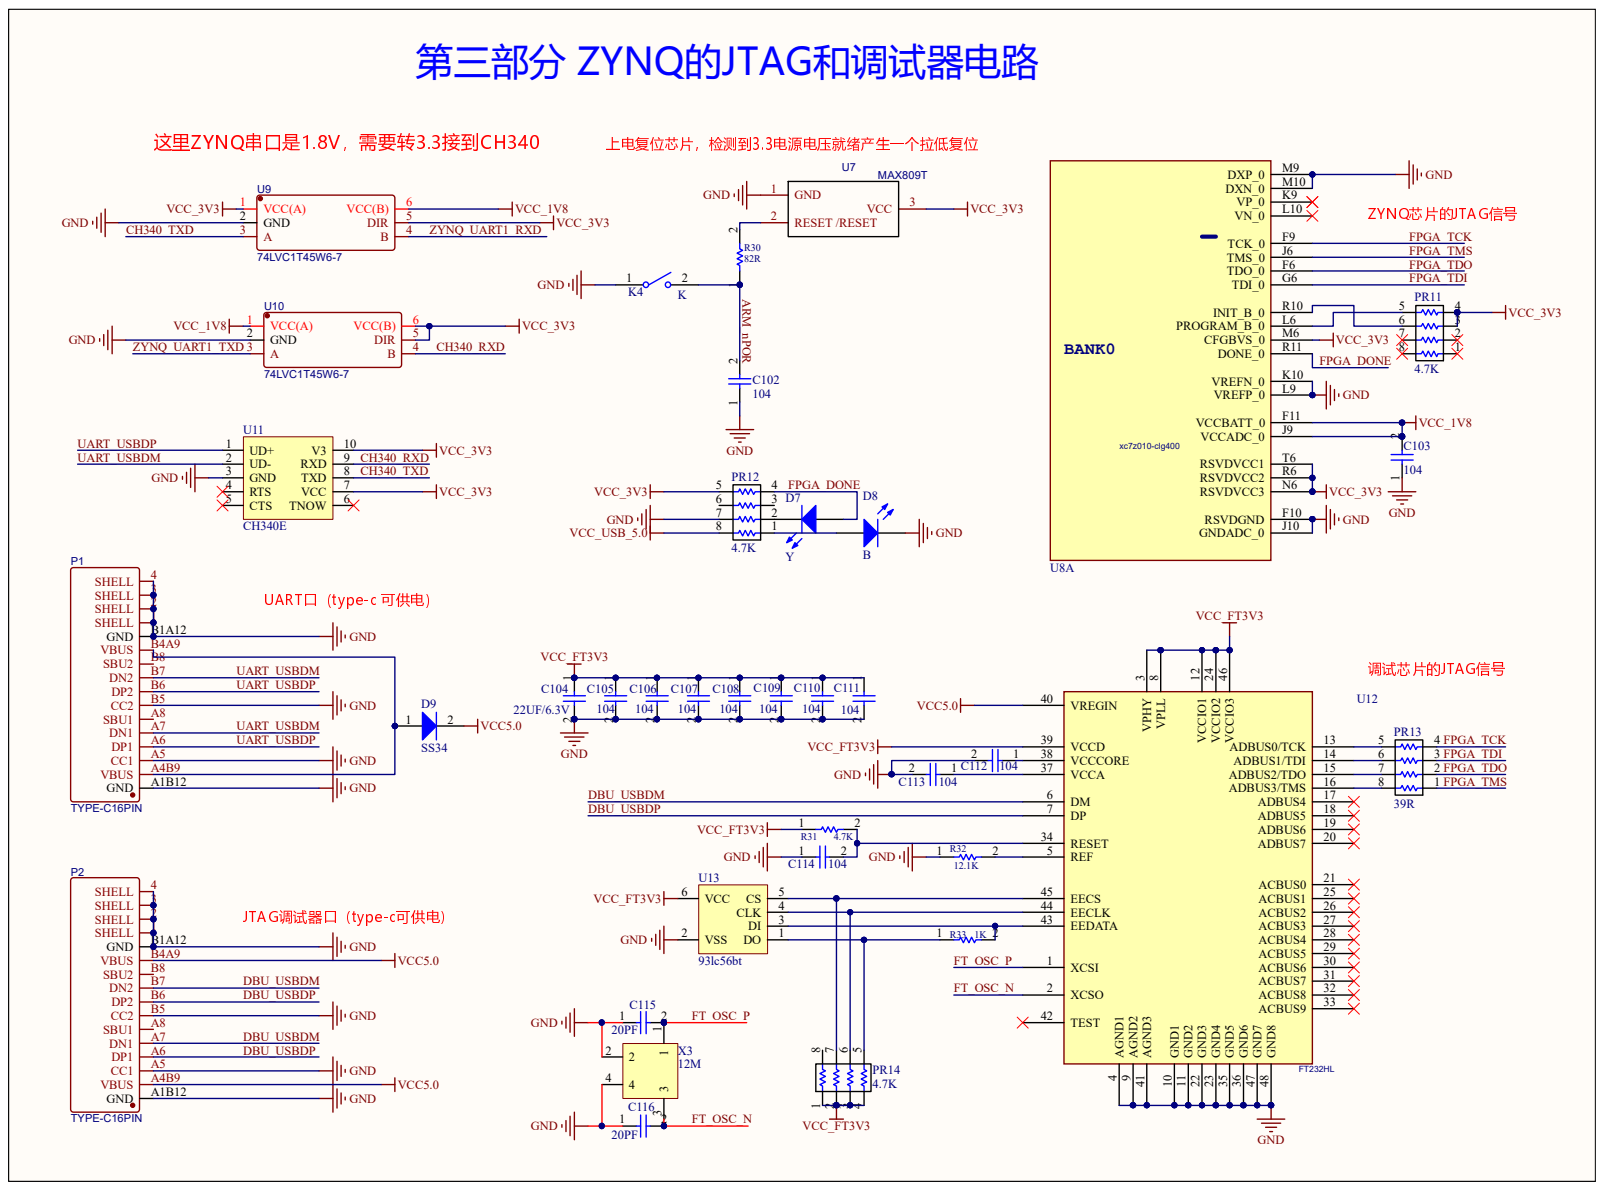
[picture p5: page 3]

## ARM的bank1（501）,这个bank所有IO电平1.8V

# 第四部分 ZYNQ的PS部分BANK（仅用于ARM）

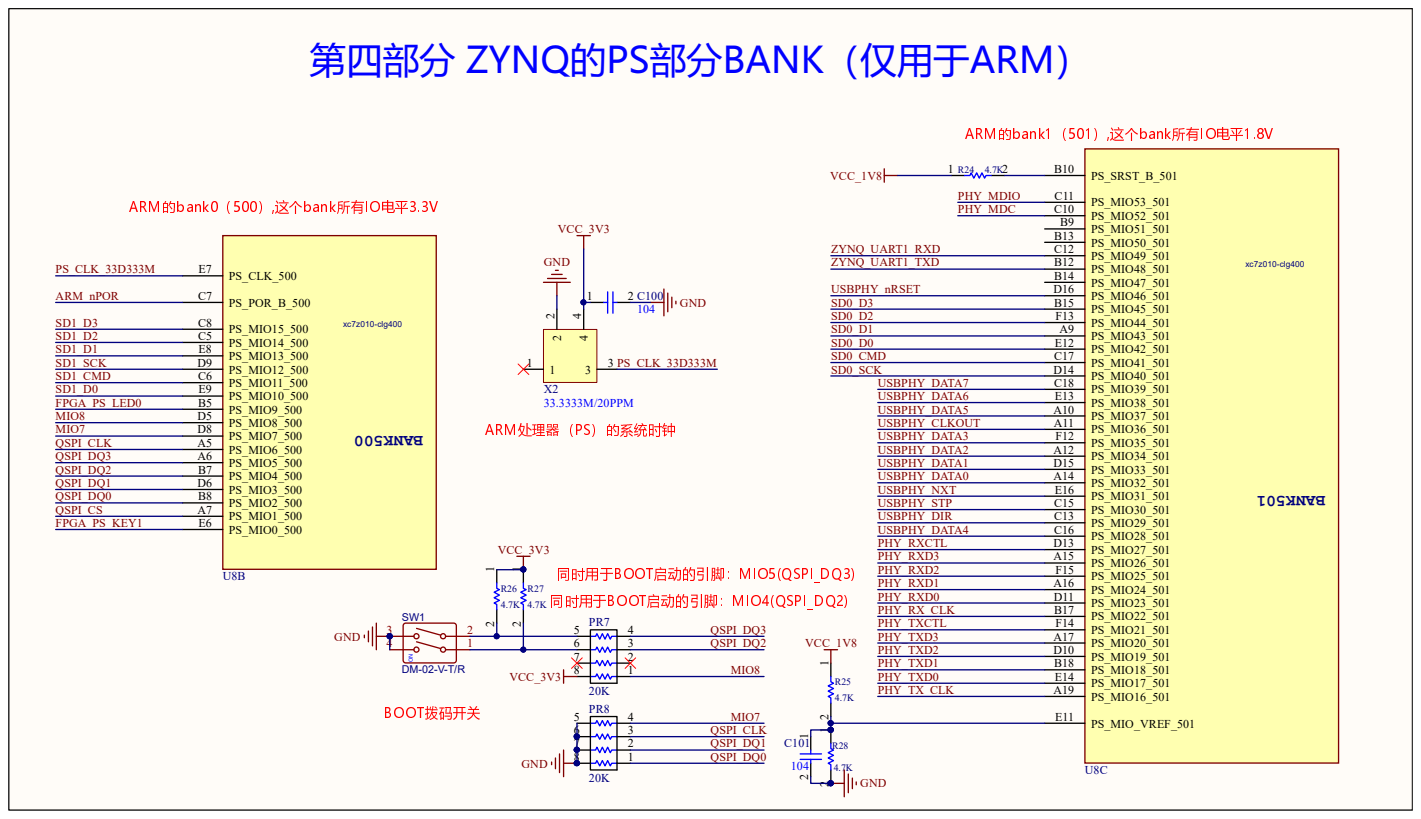
[picture p6: page 4]

# 第五部分 ZYNQ的PL部分的BANK（FPGA部分）

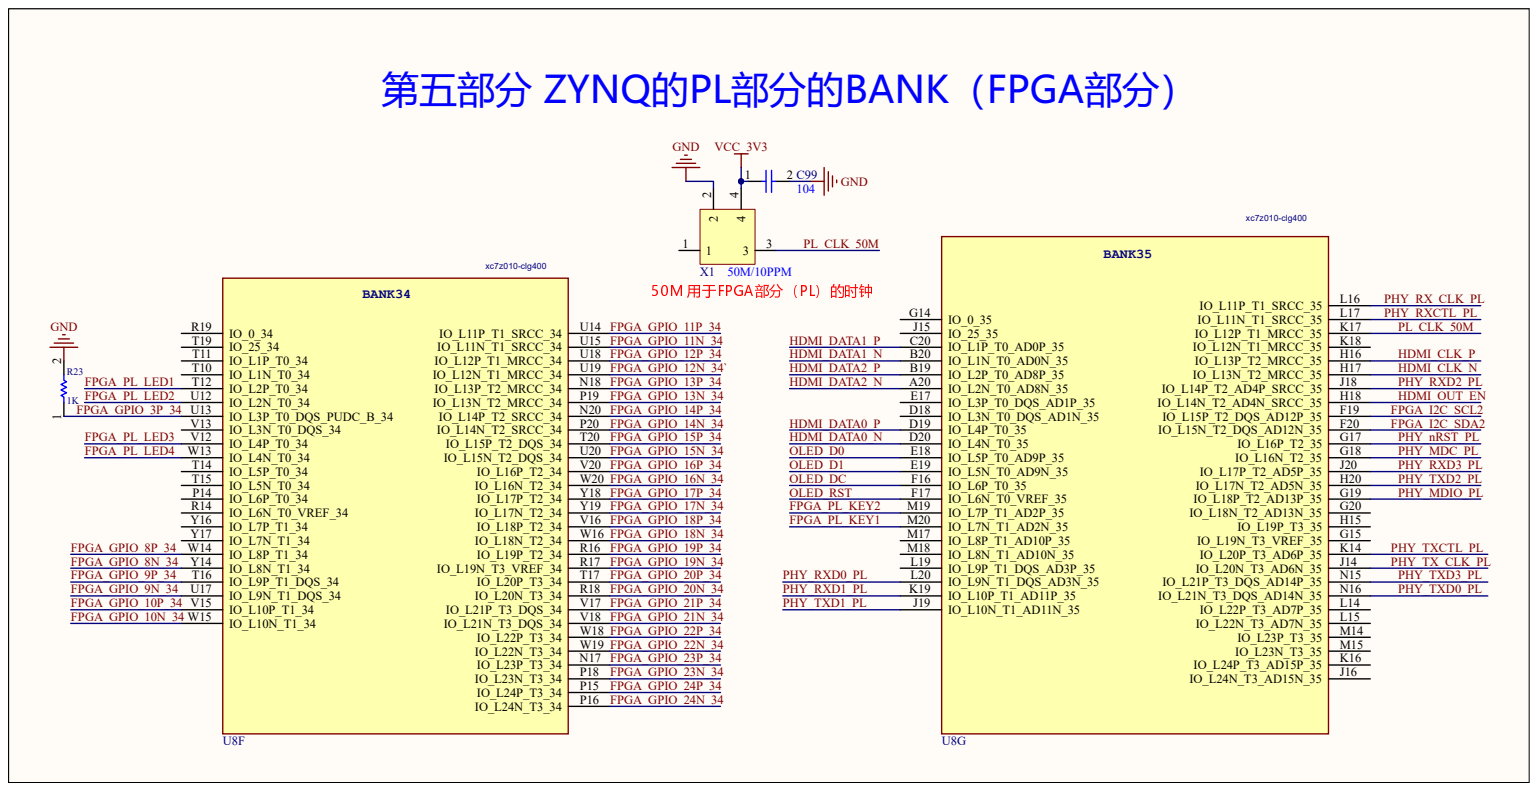
[picture p7: page 5]

# 第六部分 ZYNQ的PS部分的DDR3

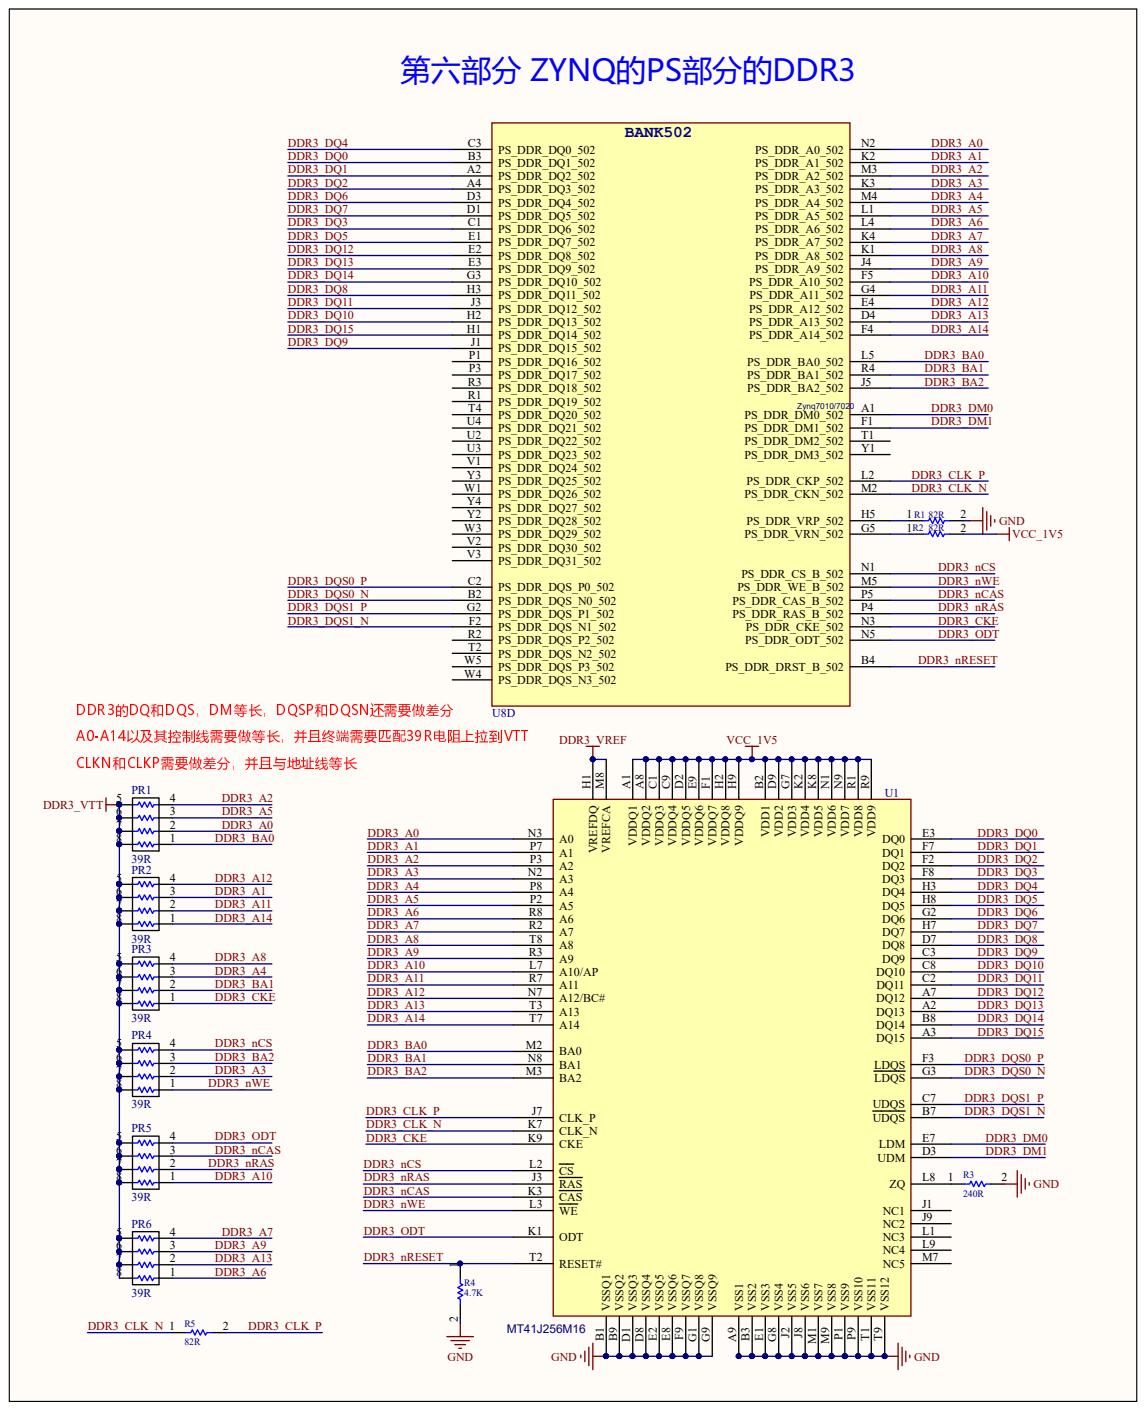
[picture p8: page 6]

# 第七部分 ZYNQ的PL PS部分千兆网口

## PL千兆网口 3.3

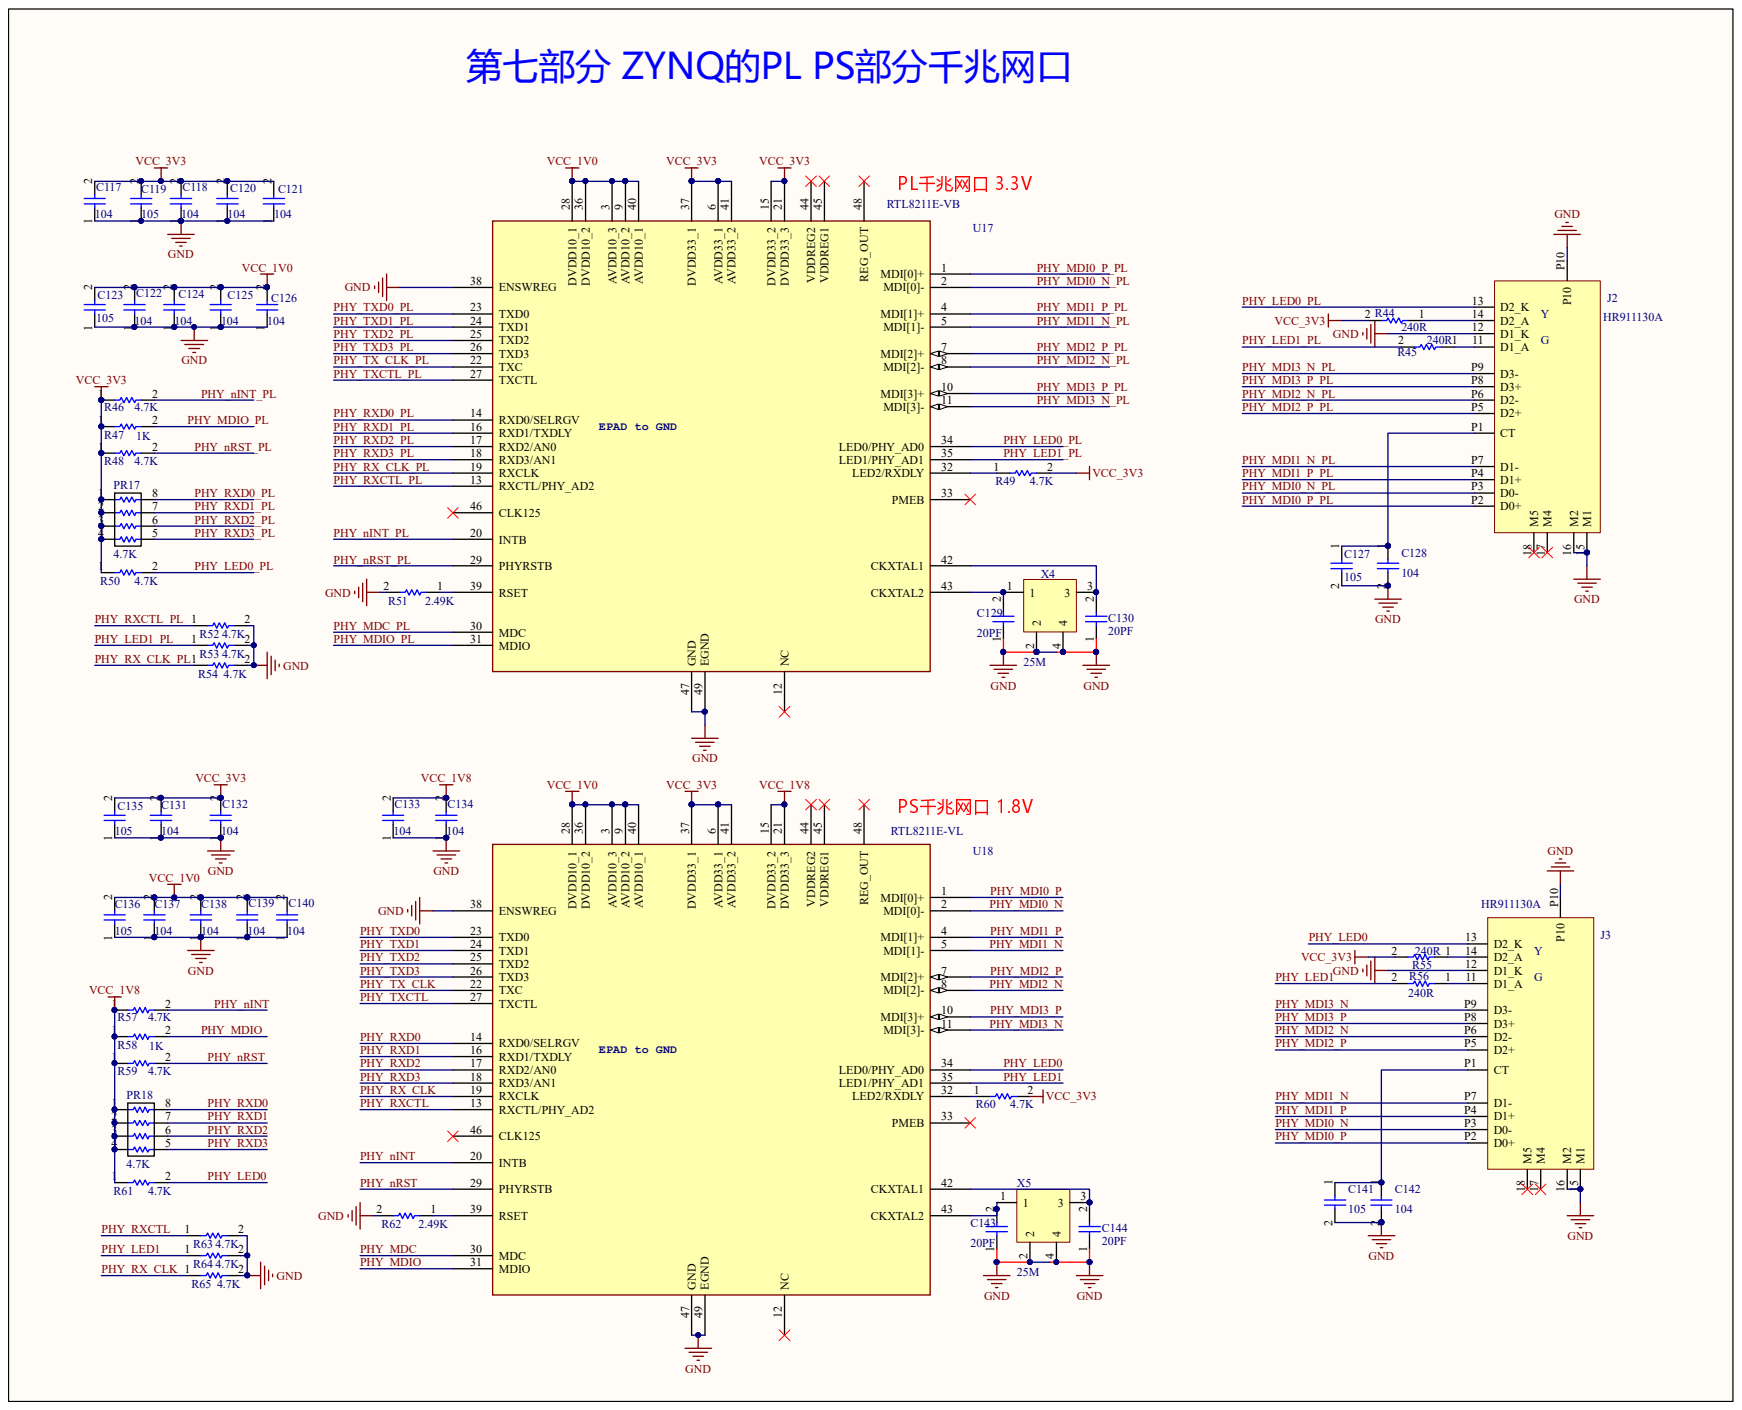
[picture p9: page 7]

# SD卡座（master，TF1，支持从这个TF卡启动）

SD0

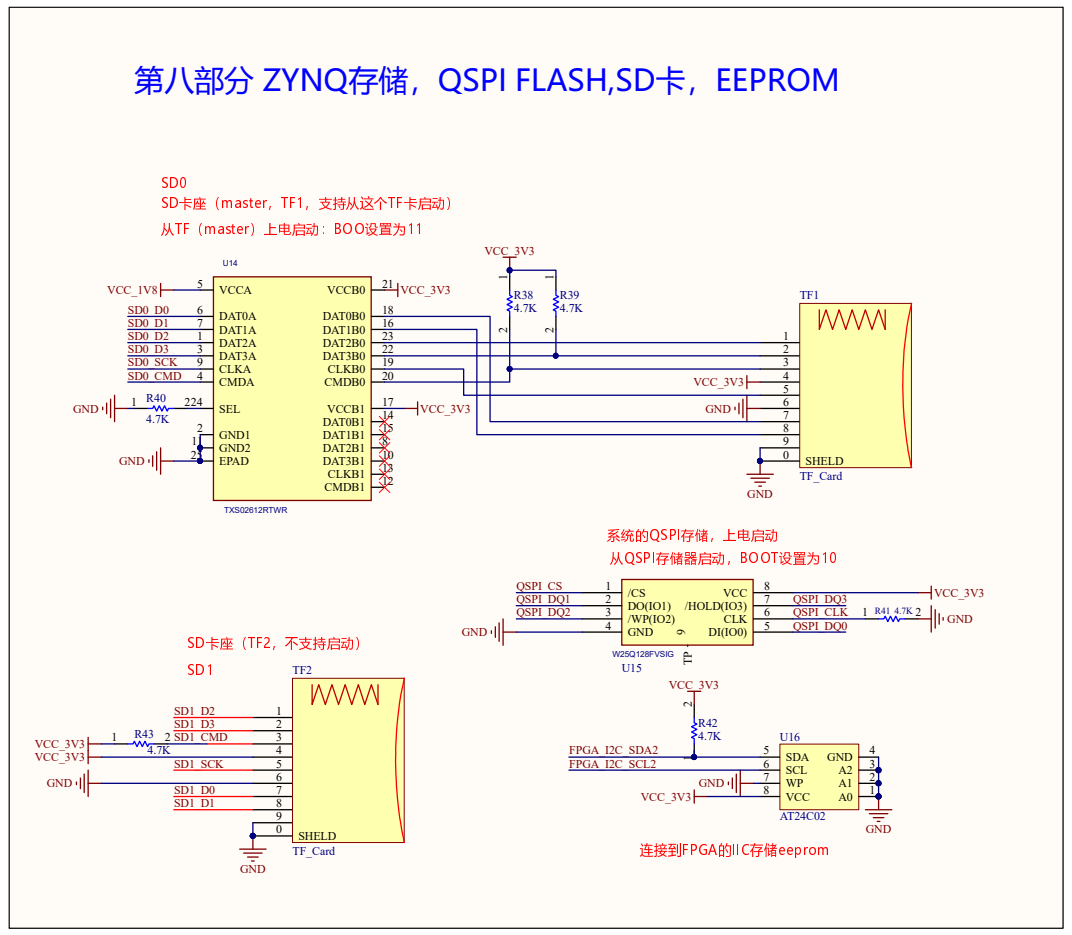
[picture p10: page 8]

第八部分 ZYNQ存储，QSPI FLASH,SD卡，EEPROM

# 第九部分 开发板对外的用户扩展34个IO口及LED和按钮

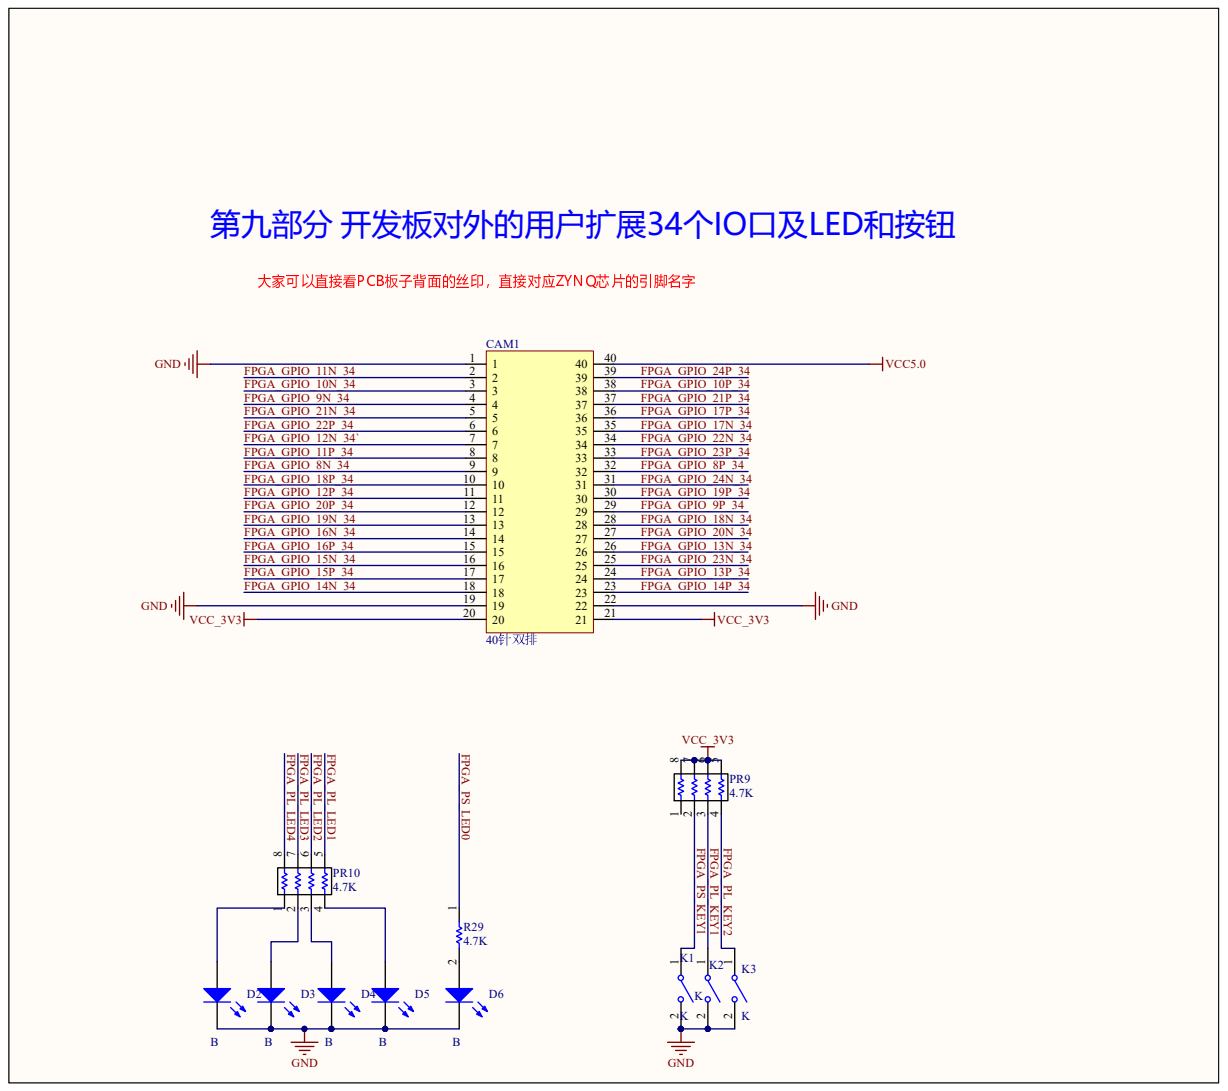
[picture p11: page 9]
VCC_3V3; FPGA_PL_KEY1; FPGA_PL_LED2; FPGA_PL_LED1; CAM1; 40针双排; GND; VCC5.0; FPGA_GPIO_11P_34; FPGA_GPIO_11N_34; FPGA_GPIO_12P_34; FPGA_GPIO_12N_34`; FPGA_GPIO_13P_34; FPGA_GPIO_13N_34; FPGA_GPIO_14N_34; FPGA_GPIO_14P_34; FPGA_GPIO_15P_34; FPGA_GPIO_15N_34; FPGA_GPIO_16P_34; FPGA_GPIO_16N_34; FPGA_GPIO_17P_34 FPGA_GPIO_17N_34; FPGA_GPIO_18P_34; FPGA_GPIO_18N_34; FPGA_GPIO_19P_34; FPGA_GPIO_19N_34; FPGA_GPIO_20P_34; FPGA_GPIO_20N_34; FPGA_GPIO_21P_34; FPGA_GPIO_21N_34 FPGA_GPIO_22P_34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

## VCC_1V8

# 第十部分 开发板的USB电路

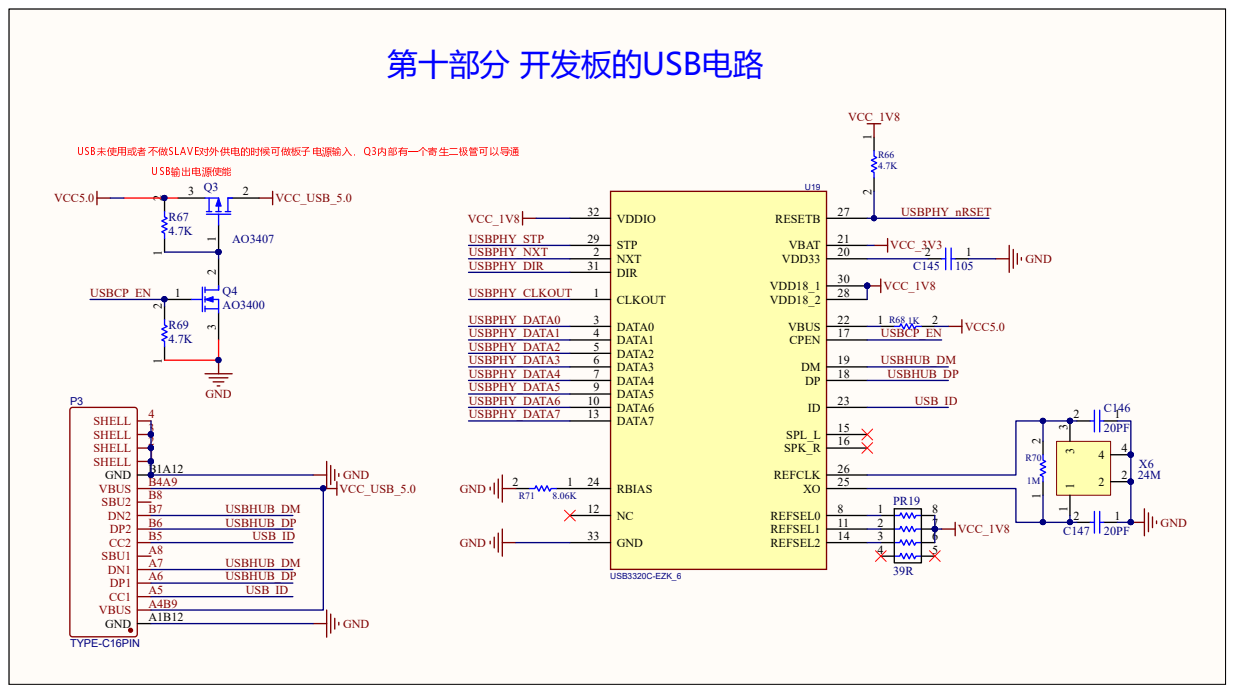
[picture p12: page 10]

# VCC_HDMI_OUT

# VCC5.0

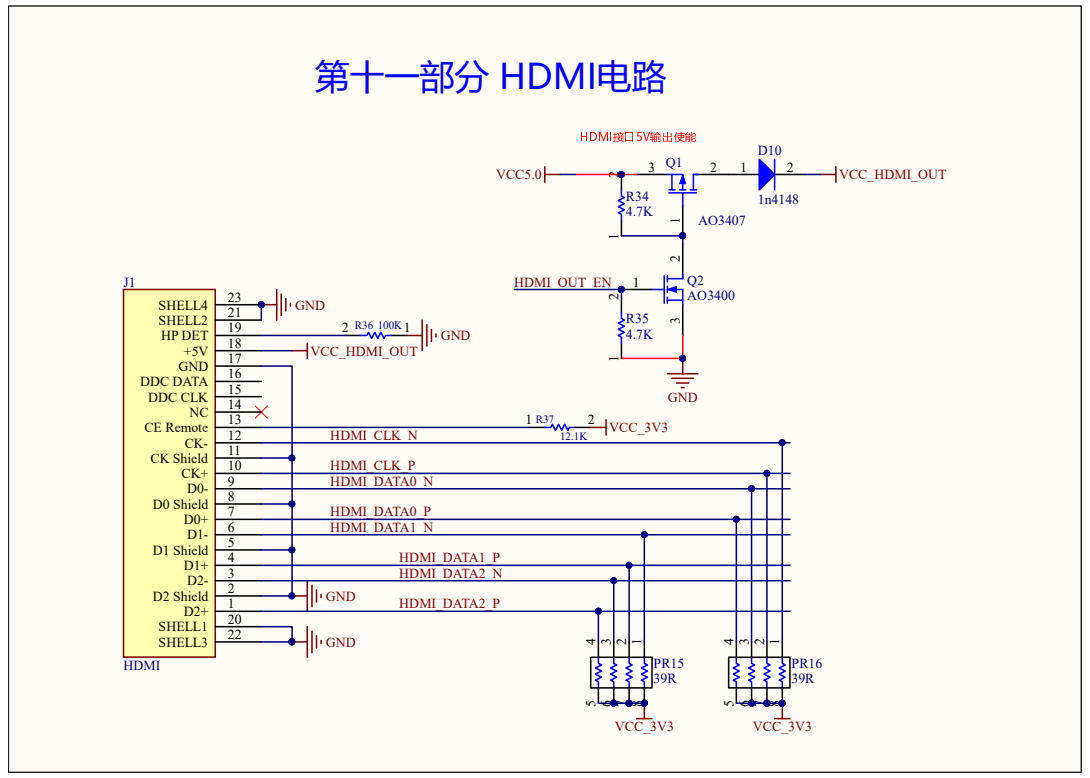
[picture p13: page 11]

# 第十二部分 PL的OLED电路

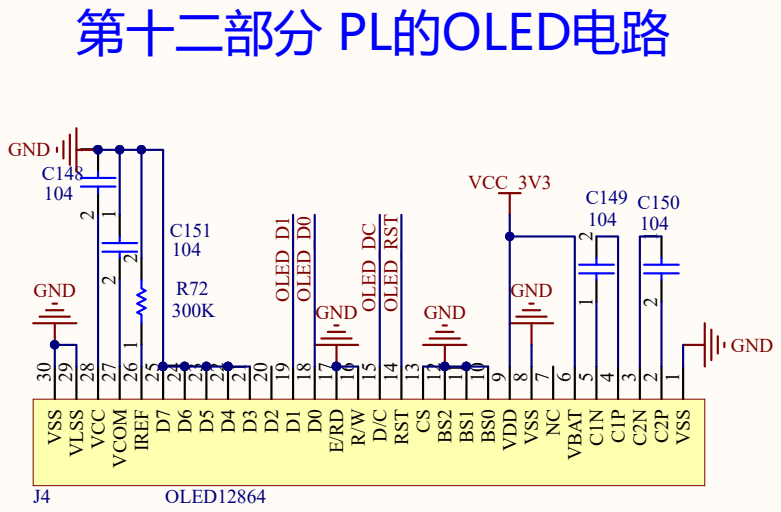
[picture p14: page 12]
