Coal56AB/Oscilloscope/STM32/Core/Inc/main.h

#define RELAY_B3_Pin GPIO_PIN_0
#define RELAY_B3_GPIO_Port GPIOA
#define RELAY_B2_Pin GPIO_PIN_1
#define RELAY_B2_GPIO_Port GPIOA
#define RELAY_B1_Pin GPIO_PIN_2
#define RELAY_B1_GPIO_Port GPIOA
#define RELAY_A1_Pin GPIO_PIN_3
#define RELAY_A1_GPIO_Port GPIOA
#define RELAY_A2_Pin GPIO_PIN_4
#define RELAY_A2_GPIO_Port GPIOA
#define RELAY_A3_Pin GPIO_PIN_5
#define RELAY_A3_GPIO_Port GPIOA
#define ANALOG_VBAT_Pin GPIO_PIN_1
#define ANALOG_VBAT_GPIO_Port GPIOB
#define EN_CH1_Pin GPIO_PIN_10
#define EN_CH1_GPIO_Port GPIOB
#define EN_CH0_Pin GPIO_PIN_11
#define EN_CH0_GPIO_Port GPIOB
#define TRG_MODE_Pin GPIO_PIN_12
#define TRG_MODE_GPIO_Port GPIOB
#define CURSOR_Pin GPIO_PIN_13
#define CURSOR_GPIO_Port GPIOB
#define RUN_Pin GPIO_PIN_14
#define RUN_GPIO_Port GPIOB
#define MENU_Pin GPIO_PIN_15
#define MENU_GPIO_Port GPIOB
#define LED_RUN_Pin GPIO_PIN_7
#define LED_RUN_GPIO_Port GPIOC
#define FUNC_A_Pin GPIO_PIN_8
#define FUNC_A_GPIO_Port GPIOC
#define FUNC_B_Pin GPIO_PIN_9
#define FUNC_B_GPIO_Port GPIOC
#define FUNC_ENC_Pin GPIO_PIN_8
#define FUNC_ENC_GPIO_Port GPIOA
#define TRG_B_Pin GPIO_PIN_15
#define TRG_B_GPIO_Port GPIOA
#define TRG_A_Pin GPIO_PIN_10
#define TRG_A_GPIO_Port GPIOC
#define TRG_ENC_Pin GPIO_PIN_11
#define TRG_ENC_GPIO_Port GPIOC
#define TIME_B_Pin GPIO_PIN_12
#define TIME_B_GPIO_Port GPIOC
#define TIME_A_Pin GPIO_PIN_2
#define TIME_A_GPIO_Port GPIOD
#define TIME_ENC_Pin GPIO_PIN_3
#define TIME_ENC_GPIO_Port GPIOB
#define CH1_B_Pin GPIO_PIN_4
#define CH1_B_GPIO_Port GPIOB
#define CH1_A_Pin GPIO_PIN_5
#define CH1_A_GPIO_Port GPIOB
#define CH1_ENC_Pin GPIO_PIN_6
#define CH1_ENC_GPIO_Port GPIOB
#define CH0_B_Pin GPIO_PIN_7
#define CH0_B_GPIO_Port GPIOB
#define CH0_A_Pin GPIO_PIN_8
#define CH0_A_GPIO_Port GPIOB
#define CH0_ENC_Pin GPIO_PIN_9
#define CH0_ENC_GPIO_Port GPIOB
