Coal56AB/Oscilloscope/ZYNQ7020/fpga/ip/record_measure/hdl/verilog/record_measure_control_s_axi.v

// ==============================================================
// Vivado(TM) HLS - High-Level Synthesis from C, C++ and SystemC v2019.1 (64-bit)
// Copyright 1986-2019 Xilinx, Inc. All Rights Reserved.
// ==============================================================
`timescale 1ns/1ps
module record_measure_control_s_axi
#(parameter
    C_S_AXI_ADDR_WIDTH = 7,
    C_S_AXI_DATA_WIDTH = 32
)(
    input  wire                          ACLK,
    input  wire                          ARESET,
    input  wire                          ACLK_EN,
    input  wire [C_S_AXI_ADDR_WIDTH-1:0] AWADDR,
    input  wire                          AWVALID,
    output wire                          AWREADY,
    input  wire [C_S_AXI_DATA_WIDTH-1:0] WDATA,
    input  wire [C_S_AXI_DATA_WIDTH/8-1:0] WSTRB,
    input  wire                          WVALID,
    output wire                          WREADY,
    output wire [1:0]                    BRESP,
    output wire                          BVALID,
    input  wire                          BREADY,
    input  wire [C_S_AXI_ADDR_WIDTH-1:0] ARADDR,
    input  wire                          ARVALID,
    output wire                          ARREADY,
    output wire [C_S_AXI_DATA_WIDTH-1:0] RDATA,
    output wire [1:0]                    RRESP,
    output wire                          RVALID,
    input  wire                          RREADY,
    output wire                          interrupt,
    output wire                          ap_start,
    input  wire                          ap_done,
    input  wire                          ap_ready,
    input  wire                          ap_idle,
    output wire [31:0]                   codes,
    output wire [31:0]                   values,
    output wire [31:0]                   result,
    output wire [31:0]                   count,
    output wire [31:0]                   stride,
    output wire [31:0]                   filtered,
    output wire [31:0]                   gain,
    output wire [31:0]                   zero,
    output wire [31:0]                   sample_rate,
    output wire [31:0]                   operation,
    output wire [31:0]                   filter_level,
    output wire [31:0]                   noise_rms
);
//------------------------Address Info-------------------
// 0x00 : Control signals
//        bit 0  - ap_start (Read/Write/COH)
//        bit 1  - ap_done (Read/COR)
//        bit 2  - ap_idle (Read)
//        bit 3  - ap_ready (Read)
//        bit 7  - auto_restart (Read/Write)
//        others - reserved
// 0x04 : Global Interrupt Enable Register
//        bit 0  - Global Interrupt Enable (Read/Write)
//        others - reserved
// 0x08 : IP Interrupt Enable Register (Read/Write)
//        bit 0  - Channel 0 (ap_done)
//        bit 1  - Channel 1 (ap_ready)
//        others - reserved
// 0x0c : IP Interrupt Status Register (Read/TOW)
//        bit 0  - Channel 0 (ap_done)
//        bit 1  - Channel 1 (ap_ready)
//        others - reserved
// 0x10 : Data signal of codes
//        bit 31~0 - codes[31:0] (Read/Write)
// 0x14 : reserved
// 0x18 : Data signal of values
//        bit 31~0 - values[31:0] (Read/Write)
// 0x1c : reserved
// 0x20 : Data signal of result
//        bit 31~0 - result[31:0] (Read/Write)
// 0x24 : reserved
// 0x28 : Data signal of count
//        bit 31~0 - count[31:0] (Read/Write)
// 0x2c : reserved
// 0x30 : Data signal of stride
//        bit 31~0 - stride[31:0] (Read/Write)
// 0x34 : reserved
// 0x38 : Data signal of filtered
//        bit 31~0 - filtered[31:0] (Read/Write)
// 0x3c : reserved
// 0x40 : Data signal of gain
//        bit 31~0 - gain[31:0] (Read/Write)
// 0x44 : reserved
// 0x48 : Data signal of zero
//        bit 31~0 - zero[31:0] (Read/Write)
// 0x4c : reserved
// 0x50 : Data signal of sample_rate
//        bit 31~0 - sample_rate[31:0] (Read/Write)
// 0x54 : reserved
// 0x58 : Data signal of operation
//        bit 31~0 - operation[31:0] (Read/Write)
// 0x5c : reserved
// 0x60 : Data signal of filter_level
//        bit 31~0 - filter_level[31:0] (Read/Write)
// 0x64 : reserved
// 0x68 : Data signal of noise_rms
//        bit 31~0 - noise_rms[31:0] (Read/Write)
// 0x6c : reserved
// (SC = Self Clear, COR = Clear on Read, TOW = Toggle on Write, COH = Clear on Handshake)

//------------------------Parameter----------------------
localparam
    ADDR_AP_CTRL             = 7'h00,
    ADDR_GIE                 = 7'h04,
    ADDR_IER                 = 7'h08,
    ADDR_ISR                 = 7'h0c,
    ADDR_CODES_DATA_0        = 7'h10,
    ADDR_CODES_CTRL          = 7'h14,
    ADDR_VALUES_DATA_0       = 7'h18,
    ADDR_VALUES_CTRL         = 7'h1c,
    ADDR_RESULT_DATA_0       = 7'h20,
    ADDR_RESULT_CTRL         = 7'h24,
    ADDR_COUNT_DATA_0        = 7'h28,
    ADDR_COUNT_CTRL          = 7'h2c,
    ADDR_STRIDE_DATA_0       = 7'h30,
    ADDR_STRIDE_CTRL         = 7'h34,
    ADDR_FILTERED_DATA_0     = 7'h38,
    ADDR_FILTERED_CTRL       = 7'h3c,
    ADDR_GAIN_DATA_0         = 7'h40,
    ADDR_GAIN_CTRL           = 7'h44,
    ADDR_ZERO_DATA_0         = 7'h48,
    ADDR_ZERO_CTRL           = 7'h4c,
    ADDR_SAMPLE_RATE_DATA_0  = 7'h50,
    ADDR_SAMPLE_RATE_CTRL    = 7'h54,
    ADDR_OPERATION_DATA_0    = 7'h58,
    ADDR_OPERATION_CTRL      = 7'h5c,
    ADDR_FILTER_LEVEL_DATA_0 = 7'h60,
    ADDR_FILTER_LEVEL_CTRL   = 7'h64,
    ADDR_NOISE_RMS_DATA_0    = 7'h68,
    ADDR_NOISE_RMS_CTRL      = 7'h6c,
    WRIDLE                   = 2'd0,
    WRDATA                   = 2'd1,
    WRRESP                   = 2'd2,
    WRRESET                  = 2'd3,
    RDIDLE                   = 2'd0,
    RDDATA                   = 2'd1,
    RDRESET                  = 2'd2,
    ADDR_BITS         = 7;

//------------------------Local signal-------------------
    reg  [1:0]                    wstate = WRRESET;
    reg  [1:0]                    wnext;
    reg  [ADDR_BITS-1:0]          waddr;
    wire [31:0]                   wmask;
    wire                          aw_hs;
    wire                          w_hs;
    reg  [1:0]                    rstate = RDRESET;
    reg  [1:0]                    rnext;
    reg  [31:0]                   rdata;
    wire                          ar_hs;
    wire [ADDR_BITS-1:0]          raddr;
    // internal registers
    reg                           int_ap_idle;
    reg                           int_ap_ready;
    reg                           int_ap_done = 1'b0;
    reg                           int_ap_start = 1'b0;
    reg                           int_auto_restart = 1'b0;
    reg                           int_gie = 1'b0;
    reg  [1:0]                    int_ier = 2'b0;
    reg  [1:0]                    int_isr = 2'b0;
    reg  [31:0]                   int_codes = 'b0;
    reg  [31:0]                   int_values = 'b0;
    reg  [31:0]                   int_result = 'b0;
    reg  [31:0]                   int_count = 'b0;
    reg  [31:0]                   int_stride = 'b0;
    reg  [31:0]                   int_filtered = 'b0;
    reg  [31:0]                   int_gain = 'b0;
    reg  [31:0]                   int_zero = 'b0;
    reg  [31:0]                   int_sample_rate = 'b0;
    reg  [31:0]                   int_operation = 'b0;
    reg  [31:0]                   int_filter_level = 'b0;
    reg  [31:0]                   int_noise_rms = 'b0;

//------------------------Instantiation------------------

//------------------------AXI write fsm------------------
assign AWREADY = (wstate == WRIDLE);
assign WREADY  = (wstate == WRDATA);
assign BRESP   = 2'b00;  // OKAY
assign BVALID  = (wstate == WRRESP);
assign wmask   = { {8{WSTRB[3]}}, {8{WSTRB[2]}}, {8{WSTRB[1]}}, {8{WSTRB[0]}} };
assign aw_hs   = AWVALID & AWREADY;
assign w_hs    = WVALID & WREADY;

// wstate
always @(posedge ACLK) begin
    if (ARESET)
        wstate <= WRRESET;
    else if (ACLK_EN)
        wstate <= wnext;
end

// wnext
always @(*) begin
    case (wstate)
        WRIDLE:
            if (AWVALID)
                wnext = WRDATA;
            else
                wnext = WRIDLE;
        WRDATA:
            if (WVALID)
                wnext = WRRESP;
            else
                wnext = WRDATA;
        WRRESP:
            if (BREADY)
                wnext = WRIDLE;
            else
                wnext = WRRESP;
        default:
            wnext = WRIDLE;
    endcase
end

// waddr
always @(posedge ACLK) begin
    if (ACLK_EN) begin
        if (aw_hs)
            waddr <= AWADDR[ADDR_BITS-1:0];
    end
end

//------------------------AXI read fsm-------------------
assign ARREADY = (rstate == RDIDLE);
assign RDATA   = rdata;
assign RRESP   = 2'b00;  // OKAY
assign RVALID  = (rstate == RDDATA);
assign ar_hs   = ARVALID & ARREADY;
assign raddr   = ARADDR[ADDR_BITS-1:0];

// rstate
always @(posedge ACLK) begin
    if (ARESET)
        rstate <= RDRESET;
    else if (ACLK_EN)
        rstate <= rnext;
end

// rnext
always @(*) begin
    case (rstate)
        RDIDLE:
            if (ARVALID)
                rnext = RDDATA;
            else
                rnext = RDIDLE;
        RDDATA:
            if (RREADY & RVALID)
                rnext = RDIDLE;
            else
                rnext = RDDATA;
        default:
            rnext = RDIDLE;
    endcase
end

// rdata
always @(posedge ACLK) begin
    if (ACLK_EN) begin
        if (ar_hs) begin
            rdata <= 1'b0;
            case (raddr)
                ADDR_AP_CTRL: begin
                    rdata[0] <= int_ap_start;
                    rdata[1] <= int_ap_done;
                    rdata[2] <= int_ap_idle;
                    rdata[3] <= int_ap_ready;
                    rdata[7] <= int_auto_restart;
                end
                ADDR_GIE: begin
                    rdata <= int_gie;
                end
                ADDR_IER: begin
                    rdata <= int_ier;
                end
                ADDR_ISR: begin
                    rdata <= int_isr;
                end
                ADDR_CODES_DATA_0: begin
                    rdata <= int_codes[31:0];
                end
                ADDR_VALUES_DATA_0: begin
                    rdata <= int_values[31:0];
                end
                ADDR_RESULT_DATA_0: begin
                    rdata <= int_result[31:0];
                end
                ADDR_COUNT_DATA_0: begin
                    rdata <= int_count[31:0];
                end
                ADDR_STRIDE_DATA_0: begin
                    rdata <= int_stride[31:0];
                end
                ADDR_FILTERED_DATA_0: begin
                    rdata <= int_filtered[31:0];
                end
                ADDR_GAIN_DATA_0: begin
                    rdata <= int_gain[31:0];
                end
                ADDR_ZERO_DATA_0: begin
                    rdata <= int_zero[31:0];
                end
                ADDR_SAMPLE_RATE_DATA_0: begin
                    rdata <= int_sample_rate[31:0];
                end
                ADDR_OPERATION_DATA_0: begin
                    rdata <= int_operation[31:0];
                end
                ADDR_FILTER_LEVEL_DATA_0: begin
                    rdata <= int_filter_level[31:0];
                end
                ADDR_NOISE_RMS_DATA_0: begin
                    rdata <= int_noise_rms[31:0];
                end
            endcase
        end
    end
end


//------------------------Register logic-----------------
assign interrupt    = int_gie & (|int_isr);
assign ap_start     = int_ap_start;
assign codes        = int_codes;
assign values       = int_values;
assign result       = int_result;
assign count        = int_count;
assign stride       = int_stride;
assign filtered     = int_filtered;
assign gain         = int_gain;
assign zero         = int_zero;
assign sample_rate  = int_sample_rate;
assign operation    = int_operation;
assign filter_level = int_filter_level;
assign noise_rms    = int_noise_rms;
// int_ap_start
always @(posedge ACLK) begin
    if (ARESET)
        int_ap_start <= 1'b0;
    else if (ACLK_EN) begin
        if (w_hs && waddr == ADDR_AP_CTRL && WSTRB[0] && WDATA[0])
            int_ap_start <= 1'b1;
        else if (ap_ready)
            int_ap_start <= int_auto_restart; // clear on handshake/auto restart
    end
end

// int_ap_done
always @(posedge ACLK) begin
    if (ARESET)
        int_ap_done <= 1'b0;
    else if (ACLK_EN) begin
        if (ap_done)
            int_ap_done <= 1'b1;
        else if (ar_hs && raddr == ADDR_AP_CTRL)
            int_ap_done <= 1'b0; // clear on read
    end
end

// int_ap_idle
always @(posedge ACLK) begin
    if (ARESET)
        int_ap_idle <= 1'b0;
    else if (ACLK_EN) begin
            int_ap_idle <= ap_idle;
    end
end

// int_ap_ready
always @(posedge ACLK) begin
    if (ARESET)
        int_ap_ready <= 1'b0;
    else if (ACLK_EN) begin
            int_ap_ready <= ap_ready;
    end
end

// int_auto_restart
always @(posedge ACLK) begin
    if (ARESET)
        int_auto_restart <= 1'b0;
    else if (ACLK_EN) begin
        if (w_hs && waddr == ADDR_AP_CTRL && WSTRB[0])
            int_auto_restart <=  WDATA[7];
    end
end

// int_gie
always @(posedge ACLK) begin
    if (ARESET)
        int_gie <= 1'b0;
    else if (ACLK_EN) begin
        if (w_hs && waddr == ADDR_GIE && WSTRB[0])
            int_gie <= WDATA[0];
    end
end

// int_ier
always @(posedge ACLK) begin
    if (ARESET)
        int_ier <= 1'b0;
    else if (ACLK_EN) begin
        if (w_hs && waddr == ADDR_IER && WSTRB[0])
            int_ier <= WDATA[1:0];
    end
end

// int_isr[0]
always @(posedge ACLK) begin
    if (ARESET)
        int_isr[0] <= 1'b0;
    else if (ACLK_EN) begin
        if (int_ier[0] & ap_done)
            int_isr[0] <= 1'b1;
        else if (w_hs && waddr == ADDR_ISR && WSTRB[0])
            int_isr[0] <= int_isr[0] ^ WDATA[0]; // toggle on write
    end
end

// int_isr[1]
always @(posedge ACLK) begin
    if (ARESET)
        int_isr[1] <= 1'b0;
    else if (ACLK_EN) begin
        if (int_ier[1] & ap_ready)
            int_isr[1] <= 1'b1;
        else if (w_hs && waddr == ADDR_ISR && WSTRB[0])
            int_isr[1] <= int_isr[1] ^ WDATA[1]; // toggle on write
    end
end

// int_codes[31:0]
always @(posedge ACLK) begin
    if (ARESET)
        int_codes[31:0] <= 0;
    else if (ACLK_EN) begin
        if (w_hs && waddr == ADDR_CODES_DATA_0)
            int_codes[31:0] <= (WDATA[31:0] & wmask) | (int_codes[31:0] & ~wmask);
    end
end

// int_values[31:0]
always @(posedge ACLK) begin
    if (ARESET)
        int_values[31:0] <= 0;
    else if (ACLK_EN) begin
        if (w_hs && waddr == ADDR_VALUES_DATA_0)
            int_values[31:0] <= (WDATA[31:0] & wmask) | (int_values[31:0] & ~wmask);
    end
end

// int_result[31:0]
always @(posedge ACLK) begin
    if (ARESET)
        int_result[31:0] <= 0;
    else if (ACLK_EN) begin
        if (w_hs && waddr == ADDR_RESULT_DATA_0)
            int_result[31:0] <= (WDATA[31:0] & wmask) | (int_result[31:0] & ~wmask);
    end
end

// int_count[31:0]
always @(posedge ACLK) begin
    if (ARESET)
        int_count[31:0] <= 0;
    else if (ACLK_EN) begin
        if (w_hs && waddr == ADDR_COUNT_DATA_0)
            int_count[31:0] <= (WDATA[31:0] & wmask) | (int_count[31:0] & ~wmask);
    end
end

// int_stride[31:0]
always @(posedge ACLK) begin
    if (ARESET)
        int_stride[31:0] <= 0;
    else if (ACLK_EN) begin
        if (w_hs && waddr == ADDR_STRIDE_DATA_0)
            int_stride[31:0] <= (WDATA[31:0] & wmask) | (int_stride[31:0] & ~wmask);
    end
end

// int_filtered[31:0]
always @(posedge ACLK) begin
    if (ARESET)
        int_filtered[31:0] <= 0;
    else if (ACLK_EN) begin
        if (w_hs && waddr == ADDR_FILTERED_DATA_0)
            int_filtered[31:0] <= (WDATA[31:0] & wmask) | (int_filtered[31:0] & ~wmask);
    end
end

// int_gain[31:0]
always @(posedge ACLK) begin
    if (ARESET)
        int_gain[31:0] <= 0;
    else if (ACLK_EN) begin
        if (w_hs && waddr == ADDR_GAIN_DATA_0)
            int_gain[31:0] <= (WDATA[31:0] & wmask) | (int_gain[31:0] & ~wmask);
    end
end

// int_zero[31:0]
always @(posedge ACLK) begin
    if (ARESET)
        int_zero[31:0] <= 0;
    else if (ACLK_EN) begin
        if (w_hs && waddr == ADDR_ZERO_DATA_0)
            int_zero[31:0] <= (WDATA[31:0] & wmask) | (int_zero[31:0] & ~wmask);
    end
end

// int_sample_rate[31:0]
always @(posedge ACLK) begin
    if (ARESET)
        int_sample_rate[31:0] <= 0;
    else if (ACLK_EN) begin
        if (w_hs && waddr == ADDR_SAMPLE_RATE_DATA_0)
            int_sample_rate[31:0] <= (WDATA[31:0] & wmask) | (int_sample_rate[31:0] & ~wmask);
    end
end

// int_operation[31:0]
always @(posedge ACLK) begin
    if (ARESET)
        int_operation[31:0] <= 0;
    else if (ACLK_EN) begin
        if (w_hs && waddr == ADDR_OPERATION_DATA_0)
            int_operation[31:0] <= (WDATA[31:0] & wmask) | (int_operation[31:0] & ~wmask);
    end
end

// int_filter_level[31:0]
always @(posedge ACLK) begin
    if (ARESET)
        int_filter_level[31:0] <= 0;
    else if (ACLK_EN) begin
        if (w_hs && waddr == ADDR_FILTER_LEVEL_DATA_0)
            int_filter_level[31:0] <= (WDATA[31:0] & wmask) | (int_filter_level[31:0] & ~wmask);
    end
end

// int_noise_rms[31:0]
always @(posedge ACLK) begin
    if (ARESET)
        int_noise_rms[31:0] <= 0;
    else if (ACLK_EN) begin
        if (w_hs && waddr == ADDR_NOISE_RMS_DATA_0)
            int_noise_rms[31:0] <= (WDATA[31:0] & wmask) | (int_noise_rms[31:0] & ~wmask);
    end
end


//------------------------Memory logic-------------------

endmodule
