Coal56AB/Oscilloscope/ZYNQ7020/fpga/hdmi.xdc

# Bank 35, direct TMDS outputs, ZYNQ MINI rev B sheets 5 and 11.
set_property PACKAGE_PIN H16 [get_ports hdmi_clk_p]
set_property PACKAGE_PIN H17 [get_ports hdmi_clk_n]
set_property PACKAGE_PIN D19 [get_ports {hdmi_data_p[0]}]
set_property PACKAGE_PIN D20 [get_ports {hdmi_data_n[0]}]
set_property PACKAGE_PIN C20 [get_ports {hdmi_data_p[1]}]
set_property PACKAGE_PIN B20 [get_ports {hdmi_data_n[1]}]
set_property PACKAGE_PIN B19 [get_ports {hdmi_data_p[2]}]
set_property PACKAGE_PIN A20 [get_ports {hdmi_data_n[2]}]
set_property IOSTANDARD TMDS_33 [get_ports {hdmi_clk_* hdmi_data_*}]
set_property PACKAGE_PIN H18 [get_ports hdmi_enable]
set_property IOSTANDARD LVCMOS33 [get_ports hdmi_enable]
# OLED12864 J4 and PL KEY2/KEY1 (K3/K2): sheets 5, 9, 12. K1 is PS MIO0.
set_property PACKAGE_PIN E18 [get_ports {oled[0]}]
set_property PACKAGE_PIN E19 [get_ports {oled[1]}]
set_property PACKAGE_PIN F16 [get_ports {oled[2]}]
set_property PACKAGE_PIN F17 [get_ports {oled[3]}]
set_property PACKAGE_PIN M19 [get_ports {pl_key[0]}]
set_property PACKAGE_PIN M20 [get_ports {pl_key[1]}]
set_property IOSTANDARD LVCMOS33 [get_ports {oled[*] pl_key[*]}]
# Mechanical keys are sampled/debounced by the service, not synchronous logic.
set_false_path -from [get_ports {pl_key[*]}]
set_property BITSTREAM.GENERAL.COMPRESS TRUE [current_design]
