Coal56AB/Oscilloscope/ZYNQ7020/fpga/ip/record_measure/hdl/vhdl/record_measure_cohbi.vhd

-- ==============================================================
-- Vivado(TM) HLS - High-Level Synthesis from C, C++ and SystemC v2019.1 (64-bit)
-- Copyright 1986-2019 Xilinx, Inc. All Rights Reserved.
-- ==============================================================
--
library ieee; 
use ieee.std_logic_1164.all; 
use ieee.std_logic_unsigned.all;

entity record_measure_cohbi_ram is 
    generic(
            MEM_TYPE    : string := "block"; 
            DWIDTH     : integer := 8; 
            AWIDTH     : integer := 10; 
            MEM_SIZE    : integer := 672
    ); 
    port (
          addr0     : in std_logic_vector(AWIDTH-1 downto 0); 
          ce0       : in std_logic; 
          d0        : in std_logic_vector(DWIDTH-1 downto 0); 
          we0       : in std_logic; 
          q0        : out std_logic_vector(DWIDTH-1 downto 0);
          clk        : in std_logic 
    ); 
end entity; 


architecture rtl of record_measure_cohbi_ram is 

signal addr0_tmp : std_logic_vector(AWIDTH-1 downto 0); 
type mem_array is array (0 to MEM_SIZE-1) of std_logic_vector (DWIDTH-1 downto 0); 
shared variable ram : mem_array;

attribute syn_ramstyle : string; 
attribute syn_ramstyle of ram : variable is "block_ram";
attribute ram_style : string;
attribute ram_style of ram : variable is MEM_TYPE;

begin 


memory_access_guard_0: process (addr0) 
begin
      addr0_tmp <= addr0;
--synthesis translate_off
      if (CONV_INTEGER(addr0) > mem_size-1) then
           addr0_tmp <= (others => '0');
      else 
           addr0_tmp <= addr0;
      end if;
--synthesis translate_on
end process;

p_memory_access_0: process (clk)  
begin 
    if (clk'event and clk = '1') then
        if (ce0 = '1') then 
            if (we0 = '1') then 
                ram(CONV_INTEGER(addr0_tmp)) := d0; 
            end if;
            q0 <= ram(CONV_INTEGER(addr0_tmp)); 
        end if;
    end if;
end process;


end rtl;

Library IEEE;
use IEEE.std_logic_1164.all;

entity record_measure_cohbi is
    generic (
        DataWidth : INTEGER := 8;
        AddressRange : INTEGER := 672;
        AddressWidth : INTEGER := 10);
    port (
        reset : IN STD_LOGIC;
        clk : IN STD_LOGIC;
        address0 : IN STD_LOGIC_VECTOR(AddressWidth - 1 DOWNTO 0);
        ce0 : IN STD_LOGIC;
        we0 : IN STD_LOGIC;
        d0 : IN STD_LOGIC_VECTOR(DataWidth - 1 DOWNTO 0);
        q0 : OUT STD_LOGIC_VECTOR(DataWidth - 1 DOWNTO 0));
end entity;

architecture arch of record_measure_cohbi is
    component record_measure_cohbi_ram is
        port (
            clk : IN STD_LOGIC;
            addr0 : IN STD_LOGIC_VECTOR;
            ce0 : IN STD_LOGIC;
            we0 : IN STD_LOGIC;
            d0 : IN STD_LOGIC_VECTOR;
            q0 : OUT STD_LOGIC_VECTOR);
    end component;



begin
    record_measure_cohbi_ram_U :  component record_measure_cohbi_ram
    port map (
        clk => clk,
        addr0 => address0,
        ce0 => ce0,
        we0 => we0,
        d0 => d0,
        q0 => q0);

end architecture;
