Coal56AB/Oscilloscope/ZYNQ7020/fpga/ip/record_measure/hdl/vhdl/record_measure_incud.vhd

-- ==============================================================
-- Vivado(TM) HLS - High-Level Synthesis from C, C++ and SystemC v2019.1 (64-bit)
-- Copyright 1986-2019 Xilinx, Inc. All Rights Reserved.
-- ==============================================================
library ieee; 
use ieee.std_logic_1164.all; 
use ieee.std_logic_unsigned.all;

entity record_measure_incud_rom is 
    generic(
             DWIDTH     : integer := 32; 
             AWIDTH     : integer := 7; 
             MEM_SIZE    : integer := 66
    ); 
    port (
          addr0      : in std_logic_vector(AWIDTH-1 downto 0); 
          ce0       : in std_logic; 
          q0         : out std_logic_vector(DWIDTH-1 downto 0);
          clk       : in std_logic
    ); 
end entity; 


architecture rtl of record_measure_incud_rom is 

signal addr0_tmp : std_logic_vector(AWIDTH-1 downto 0); 
type mem_array is array (0 to MEM_SIZE-1) of std_logic_vector (DWIDTH-1 downto 0); 
signal mem : mem_array := (
    0 => "00000000000000000000000000000000", 
    1 => "00111111100000000000000000000000", 
    2 => "00111111000000000000000000000000", 
    3 => "00111110101010101010101010101011", 
    4 => "00111110100000000000000000000000", 
    5 => "00111110010011001100110011001101", 
    6 => "00111110001010101010101010101011", 
    7 => "00111110000100100100100100100101", 
    8 => "00111110000000000000000000000000", 
    9 => "00111101111000111000111000111001", 
    10 => "00111101110011001100110011001101", 
    11 => "00111101101110100010111010001100", 
    12 => "00111101101010101010101010101011", 
    13 => "00111101100111011000100111011001", 
    14 => "00111101100100100100100100100101", 
    15 => "00111101100010001000100010001001", 
    16 => "00111101100000000000000000000000", 
    17 => "00111101011100001111000011110001", 
    18 => "00111101011000111000111000111001", 
    19 => "00111101010101111001010000110110", 
    20 => "00111101010011001100110011001101", 
    21 => "00111101010000110000110000110001", 
    22 => "00111101001110100010111010001100", 
    23 => "00111101001100100001011001000011", 
    24 => "00111101001010101010101010101011", 
    25 => "00111101001000111101011100001010", 
    26 => "00111101000111011000100111011001", 
    27 => "00111101000101111011010000100110", 
    28 => "00111101000100100100100100100101", 
    29 => "00111101000011010011110111001011", 
    30 => "00111101000010001000100010001001", 
    31 => "00111101000001000010000100001000", 
    32 => "00111101000000000000000000000000", 
    33 => "00111100111110000011111000010000", 
    34 => "00111100111100001111000011110001", 
    35 => "00111100111010100000111010100001", 
    36 => "00111100111000111000111000111001", 
    37 => "00111100110111010110011111001001", 
    38 => "00111100110101111001010000110110", 
    39 => "00111100110100100000110100100001", 
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


begin 


memory_access_guard_0: process (addr0) 
begin
      addr0_tmp <= addr0;
--synthesis translate_off
      if (CONV_INTEGER(addr0) > mem_size-1) then
           addr0_tmp <= (others => '0');
      else 
           addr0_tmp <= addr0;
      end if;
--synthesis translate_on
end process;

p_rom_access: process (clk)  
begin 
    if (clk'event and clk = '1') then
        if (ce0 = '1') then 
            q0 <= mem(CONV_INTEGER(addr0_tmp)); 
        end if;
    end if;
end process;

end rtl;

Library IEEE;
use IEEE.std_logic_1164.all;

entity record_measure_incud is
    generic (
        DataWidth : INTEGER := 32;
        AddressRange : INTEGER := 66;
        AddressWidth : INTEGER := 7);
    port (
        reset : IN STD_LOGIC;
        clk : IN STD_LOGIC;
        address0 : IN STD_LOGIC_VECTOR(AddressWidth - 1 DOWNTO 0);
        ce0 : IN STD_LOGIC;
        q0 : OUT STD_LOGIC_VECTOR(DataWidth - 1 DOWNTO 0));
end entity;

architecture arch of record_measure_incud is
    component record_measure_incud_rom is
        port (
            clk : IN STD_LOGIC;
            addr0 : IN STD_LOGIC_VECTOR;
            ce0 : IN STD_LOGIC;
            q0 : OUT STD_LOGIC_VECTOR);
    end component;



begin
    record_measure_incud_rom_U :  component record_measure_incud_rom
    port map (
        clk => clk,
        addr0 => address0,
        ce0 => ce0,
        q0 => q0);

end architecture;
