Coal56AB/Oscilloscope/ZYNQ7020/oscill.srcs/sources_1/bd/system/hdl/system_wrapper.v

//Copyright 1986-2019 Xilinx, Inc. All Rights Reserved.
//--------------------------------------------------------------------------------
//Tool Version: Vivado v.2019.1 (win64) Build 2552052 Fri May 24 14:49:42 MDT 2019
//Date        : Tue Oct 27 10:08:08 2026
//Host        : DESKTOP-54179R8 running 64-bit major release  (build 9200)
//Command     : generate_target system_wrapper.bd
//Design      : system_wrapper
//Purpose     : IP block netlist
//--------------------------------------------------------------------------------
`timescale 1 ps / 1 ps

module system_wrapper
   (DDR_addr,
    DDR_ba,
    DDR_cas_n,
    DDR_ck_n,
    DDR_ck_p,
    DDR_cke,
    DDR_cs_n,
    DDR_dm,
    DDR_dq,
    DDR_dqs_n,
    DDR_dqs_p,
    DDR_odt,
    DDR_ras_n,
    DDR_reset_n,
    DDR_we_n,
    FIXED_IO_ddr_vrn,
    FIXED_IO_ddr_vrp,
    FIXED_IO_mio,
    FIXED_IO_ps_clk,
    FIXED_IO_ps_porb,
    FIXED_IO_ps_srstb,
    adc0_a,
    adc0_b,
    adc1_a,
    adc1_b,
    adc_clk_a,
    adc_clk_b,
    hdmi_clk_n,
    hdmi_clk_p,
    hdmi_data_n,
    hdmi_data_p,
    hdmi_enable,
    oled,
    pl_key);
  inout [14:0]DDR_addr;
  inout [2:0]DDR_ba;
  inout DDR_cas_n;
  inout DDR_ck_n;
  inout DDR_ck_p;
  inout DDR_cke;
  inout DDR_cs_n;
  inout [3:0]DDR_dm;
  inout [31:0]DDR_dq;
  inout [3:0]DDR_dqs_n;
  inout [3:0]DDR_dqs_p;
  inout DDR_odt;
  inout DDR_ras_n;
  inout DDR_reset_n;
  inout DDR_we_n;
  inout FIXED_IO_ddr_vrn;
  inout FIXED_IO_ddr_vrp;
  inout [53:0]FIXED_IO_mio;
  inout FIXED_IO_ps_clk;
  inout FIXED_IO_ps_porb;
  inout FIXED_IO_ps_srstb;
  input [7:0]adc0_a;
  input [7:0]adc0_b;
  input [7:0]adc1_a;
  input [7:0]adc1_b;
  output adc_clk_a;
  output adc_clk_b;
  output hdmi_clk_n;
  output hdmi_clk_p;
  output [2:0]hdmi_data_n;
  output [2:0]hdmi_data_p;
  output [0:0]hdmi_enable;
  output [3:0]oled;
  input [1:0]pl_key;

  wire [14:0]DDR_addr;
  wire [2:0]DDR_ba;
  wire DDR_cas_n;
  wire DDR_ck_n;
  wire DDR_ck_p;
  wire DDR_cke;
  wire DDR_cs_n;
  wire [3:0]DDR_dm;
  wire [31:0]DDR_dq;
  wire [3:0]DDR_dqs_n;
  wire [3:0]DDR_dqs_p;
  wire DDR_odt;
  wire DDR_ras_n;
  wire DDR_reset_n;
  wire DDR_we_n;
  wire FIXED_IO_ddr_vrn;
  wire FIXED_IO_ddr_vrp;
  wire [53:0]FIXED_IO_mio;
  wire FIXED_IO_ps_clk;
  wire FIXED_IO_ps_porb;
  wire FIXED_IO_ps_srstb;
  wire [7:0]adc0_a;
  wire [7:0]adc0_b;
  wire [7:0]adc1_a;
  wire [7:0]adc1_b;
  wire adc_clk_a;
  wire adc_clk_b;
  wire hdmi_clk_n;
  wire hdmi_clk_p;
  wire [2:0]hdmi_data_n;
  wire [2:0]hdmi_data_p;
  wire [0:0]hdmi_enable;
  wire [3:0]oled;
  wire [1:0]pl_key;

  system system_i
       (.DDR_addr(DDR_addr),
        .DDR_ba(DDR_ba),
        .DDR_cas_n(DDR_cas_n),
        .DDR_ck_n(DDR_ck_n),
        .DDR_ck_p(DDR_ck_p),
        .DDR_cke(DDR_cke),
        .DDR_cs_n(DDR_cs_n),
        .DDR_dm(DDR_dm),
        .DDR_dq(DDR_dq),
        .DDR_dqs_n(DDR_dqs_n),
        .DDR_dqs_p(DDR_dqs_p),
        .DDR_odt(DDR_odt),
        .DDR_ras_n(DDR_ras_n),
        .DDR_reset_n(DDR_reset_n),
        .DDR_we_n(DDR_we_n),
        .FIXED_IO_ddr_vrn(FIXED_IO_ddr_vrn),
        .FIXED_IO_ddr_vrp(FIXED_IO_ddr_vrp),
        .FIXED_IO_mio(FIXED_IO_mio),
        .FIXED_IO_ps_clk(FIXED_IO_ps_clk),
        .FIXED_IO_ps_porb(FIXED_IO_ps_porb),
        .FIXED_IO_ps_srstb(FIXED_IO_ps_srstb),
        .adc0_a(adc0_a),
        .adc0_b(adc0_b),
        .adc1_a(adc1_a),
        .adc1_b(adc1_b),
        .adc_clk_a(adc_clk_a),
        .adc_clk_b(adc_clk_b),
        .hdmi_clk_n(hdmi_clk_n),
        .hdmi_clk_p(hdmi_clk_p),
        .hdmi_data_n(hdmi_data_n),
        .hdmi_data_p(hdmi_data_p),
        .hdmi_enable(hdmi_enable),
        .oled(oled),
        .pl_key(pl_key));
endmodule
