Coal56AB/Oscilloscope/ZYNQ7020/fpga/ip/record_measure/hdl/verilog/record_measure_cohbi.v

// ==============================================================
// Vivado(TM) HLS - High-Level Synthesis from C, C++ and SystemC v2019.1 (64-bit)
// Copyright 1986-2019 Xilinx, Inc. All Rights Reserved.
// ==============================================================
`timescale 1 ns / 1 ps
module record_measure_cohbi_ram (addr0, ce0, d0, we0, q0,  clk);

parameter DWIDTH = 8;
parameter AWIDTH = 10;
parameter MEM_SIZE = 672;

input[AWIDTH-1:0] addr0;
input ce0;
input[DWIDTH-1:0] d0;
input we0;
output reg[DWIDTH-1:0] q0;
input clk;

(* ram_style = "block" *)reg [DWIDTH-1:0] ram[0:MEM_SIZE-1];




always @(posedge clk)  
begin 
    if (ce0) 
    begin
        if (we0) 
        begin 
            ram[addr0] <= d0; 
        end 
        q0 <= ram[addr0];
    end
end


endmodule

`timescale 1 ns / 1 ps
module record_measure_cohbi(
    reset,
    clk,
    address0,
    ce0,
    we0,
    d0,
    q0);

parameter DataWidth = 32'd8;
parameter AddressRange = 32'd672;
parameter AddressWidth = 32'd10;
input reset;
input clk;
input[AddressWidth - 1:0] address0;
input ce0;
input we0;
input[DataWidth - 1:0] d0;
output[DataWidth - 1:0] q0;



record_measure_cohbi_ram record_measure_cohbi_ram_U(
    .clk( clk ),
    .addr0( address0 ),
    .ce0( ce0 ),
    .we0( we0 ),
    .d0( d0 ),
    .q0( q0 ));

endmodule
