Coal56AB/Oscilloscope/ZYNQ7020/fpga/ip/record_measure/hdl/verilog/record_measure_maAem.v

// ==============================================================
// Vivado(TM) HLS - High-Level Synthesis from C, C++ and SystemC v2019.1 (64-bit)
// Copyright 1986-2019 Xilinx, Inc. All Rights Reserved.
// ==============================================================
`timescale 1 ns / 1 ps

module record_measure_maAem_DSP48_4(
    input  [16 - 1:0] in0,
    input  [16 - 1:0] in1,
    input  [32 - 1:0] in2,
    output [32 - 1:0]  dout);

wire signed [25 - 1:0]     a;
wire signed [18 - 1:0]     b;
wire signed [48 - 1:0]     c;
wire signed [43 - 1:0]     m;
wire signed [48 - 1:0]     p;

assign a  = $unsigned(in0);
assign b  = $unsigned(in1);
assign c  = $unsigned(in2);

assign m  = a * b;
assign p  = c - m;

assign dout = p;

endmodule
`timescale 1 ns / 1 ps
module record_measure_maAem(
    din0,
    din1,
    din2,
    dout);

parameter ID = 32'd1;
parameter NUM_STAGE = 32'd1;
parameter din0_WIDTH = 32'd1;
parameter din1_WIDTH = 32'd1;
parameter din2_WIDTH = 32'd1;
parameter dout_WIDTH = 32'd1;
input[din0_WIDTH - 1:0] din0;
input[din1_WIDTH - 1:0] din1;
input[din2_WIDTH - 1:0] din2;
output[dout_WIDTH - 1:0] dout;



record_measure_maAem_DSP48_4 record_measure_maAem_DSP48_4_U(
    .in0( din0 ),
    .in1( din1 ),
    .in2( din2 ),
    .dout( dout ));

endmodule
