Coal56AB/Oscilloscope/ZYNQ7020/fpga/ip/record_measure/hdl/verilog/record_measure_mutde.v

// ==============================================================
// Vivado(TM) HLS - High-Level Synthesis from C, C++ and SystemC v2019.1 (64-bit)
// Copyright 1986-2019 Xilinx, Inc. All Rights Reserved.
// ==============================================================

`timescale 1ns/1ps

module record_measure_mutde #(
parameter
    ID                = 0,
    NUM_STAGE         = 1,
    din0_WIDTH       = 32,
    din1_WIDTH       = 32,
    din2_WIDTH       = 32,
    din3_WIDTH       = 32,
    din4_WIDTH         = 32,
    dout_WIDTH            = 32
)(
    input  [31 : 0]     din0,
    input  [31 : 0]     din1,
    input  [31 : 0]     din2,
    input  [31 : 0]     din3,
    input  [1 : 0]    din4,
    output [31 : 0]   dout);

// puts internal signals
wire [1 : 0]     sel;
// level 1 signals
wire [31 : 0]         mux_1_0;
wire [31 : 0]         mux_1_1;
// level 2 signals
wire [31 : 0]         mux_2_0;

assign sel = din4;

// Generate level 1 logic
assign mux_1_0 = (sel[0] == 0)? din0 : din1;
assign mux_1_1 = (sel[0] == 0)? din2 : din3;

// Generate level 2 logic
assign mux_2_0 = (sel[1] == 0)? mux_1_0 : mux_1_1;

// output logic
assign dout = mux_2_0;

endmodule
