Coal56AB/Oscilloscope/ZYNQ7020/fpga/ip/record_measure/hdl/verilog/record_measure_tejbC.v

// ==============================================================
// Vivado(TM) HLS - High-Level Synthesis from C, C++ and SystemC v2019.1 (64-bit)
// Copyright 1986-2019 Xilinx, Inc. All Rights Reserved.
// ==============================================================
`timescale 1 ns / 1 ps
module record_measure_tejbC_ram (addr0, ce0, d0, we0, addr1, ce1, d1, we1, q1,  clk);

parameter DWIDTH = 32;
parameter AWIDTH = 9;
parameter MEM_SIZE = 336;

input[AWIDTH-1:0] addr0;
input ce0;
input[DWIDTH-1:0] d0;
input we0;
input[AWIDTH-1:0] addr1;
input ce1;
input[DWIDTH-1:0] d1;
input we1;
output reg[DWIDTH-1:0] q1;
input clk;

(* ram_style = "block" *)reg [DWIDTH-1:0] ram[0:MEM_SIZE-1];




always @(posedge clk)  
begin 
    if (ce0) 
    begin
        if (we0) 
        begin 
            ram[addr0] <= d0; 
        end 
    end
end


always @(posedge clk)  
begin 
    if (ce1) 
    begin
        if (we1) 
        begin 
            ram[addr1] <= d1; 
        end 
        q1 <= ram[addr1];
    end
end


endmodule

`timescale 1 ns / 1 ps
module record_measure_tejbC(
    reset,
    clk,
    address0,
    ce0,
    we0,
    d0,
    address1,
    ce1,
    we1,
    d1,
    q1);

parameter DataWidth = 32'd32;
parameter AddressRange = 32'd336;
parameter AddressWidth = 32'd9;
input reset;
input clk;
input[AddressWidth - 1:0] address0;
input ce0;
input we0;
input[DataWidth - 1:0] d0;
input[AddressWidth - 1:0] address1;
input ce1;
input we1;
input[DataWidth - 1:0] d1;
output[DataWidth - 1:0] q1;



record_measure_tejbC_ram record_measure_tejbC_ram_U(
    .clk( clk ),
    .addr0( address0 ),
    .ce0( ce0 ),
    .we0( we0 ),
    .d0( d0 ),
    .addr1( address1 ),
    .ce1( ce1 ),
    .we1( we1 ),
    .d1( d1 ),
    .q1( q1 ));

endmodule
