Coal56AB/Oscilloscope/ZYNQ7020/gui/src/preview_sdl.c

#include "panel_sdl.h"
#include "wave_file.h"
#include "linux_storage.h"
#include "linux_serial.h"
#include "capture_adapter.h"
#include "settings_session.h"
#include "scope_renderer.h"
#include "waveform_view.h"
#include "control_transport.h"
#include "remote_control.h"
#include "status_ipc.h"
#ifdef SCOPE_ENABLE_ZYNQ
#include "capture_selftest.h"
#endif
#ifdef SCOPE_ENABLE_LINUX_DISPLAY
#include "linux_display.h"
#include "linux_touch.h"
#endif

#include <SDL.h>
#include <dirent.h>
#include <errno.h>
#include <limits.h>
#include <math.h>
#include <signal.h>
#include <stdint.h>
#include <stdio.h>
#include <stdlib.h>
#include <string.h>
#include <strings.h>
#include <sys/stat.h>
#include <unistd.h>

#ifndef PATH_MAX
#define PATH_MAX 4096
#endif

static DemoSignal demo;
static SettingsSession settings;
static ScopeRenderer *renderer;
static uint64_t render_generation;
static int restored_scale[2]={-1,-1};
static int panel_channel_enabled[2]={-1,-1};
static uint64_t restore_retry_ms;
static int restore_capture_pending;
static volatile sig_atomic_t stop_requested;
static void request_stop(int signal_number) { (void)signal_number; stop_requested=1; }
static uint32_t *screen_pixels;
static uint32_t *panel_pixels;
static uint32_t browse_pixels[SCOPE_WIDTH * SCOPE_HEIGHT];
static DemoWaveCapture browse_wave;
static DemoSignal live_before_browse;
static int live_snapshot_valid;
static char browse_names[DEMO_BROWSE_FILES][DEMO_BROWSE_NAME];
static char application_dir[PATH_MAX];
static int require_data_device;
static int dirty = 1,plot_dirty=1,overlay_dirty=1;
static int panel_enabled = 1;
static ControlQueue controls;
static KeyboardControlTransport keyboard_controls;
static SerialControlTransport serial_controls;
static CapturePipeline *capture_pipeline;
static DisplayFrame capture_frame;
static const DisplayFrame *leased_frame;
static int capture_frame_valid;
static uint64_t single_capture_id;
static const char *console_path;
static unsigned console_baud = 115200;
static char startup_error[64];
static uint64_t pc_activity_until;

static int request_panel_scale(void *context, unsigned channel, int millivolts)
{
    int queued=serial_control_set_scale(context,channel,millivolts);
    if(queued){restored_scale[channel]=millivolts;restore_retry_ms=0;}
    return queued;
}

static void update_pc_console(uint64_t now)
{
    unsigned requested = demo_signal_pc_baud(demo.pc_baud_index);
    int active = now < pc_activity_until;
    if (requested != console_baud) {
        int ok = console_path && linux_serial_set_baud(console_path, requested);
        if (ok) console_baud = requested;
        demo_signal_pc_status(&demo, demo.pc_available, console_baud, active);
        demo_signal_notify(&demo, ok ? "UART BAUD APPLIED" : "UART BAUD FAILED");
        dirty = 1;
    } else if (demo.pc_active != active) {
        demo_signal_pc_status(&demo, demo.pc_available, console_baud, active);
        dirty = 1;
    }
}

typedef struct {
    DemoControl control;
    SDL_Keycode key_code;
    uint64_t since;
    int active, long_done, suppressed;
} HeldControl;

static HeldControl mouse_hold;
static HeldControl key_holds[CONTROL_ID_COUNT];
static DemoControl hovered = DEMO_CONTROL_COUNT;
static DemoControl pending_chord = DEMO_CONTROL_COUNT;
static uint64_t pending_time;
static DemoSignal chord_snapshot;
static int wheel_remainder;


typedef enum {
    TOUCH_NONE, TOUCH_TOP_MENU, TOUCH_TOP_SCREENSHOT, TOUCH_TOP_WAVE,
    TOUCH_TOP_FINE, TOUCH_TOP_PROCESSING, TOUCH_TOP_RUN,
    TOUCH_CH1, TOUCH_CH2, TOUCH_TIME, TOUCH_TRIGGER_SOURCE,
    TOUCH_BOTTOM_CURSOR, TOUCH_MENU_BACK, TOUCH_MENU_DRAG, TOUCH_MENU_OUTSIDE, TOUCH_MENU_ROW,
    TOUCH_MEASURE_HIDE, TOUCH_MEASURE_CLEAR, TOUCH_MEASURE_CANCEL,
    TOUCH_MEASURE_CONFIRM, TOUCH_PLOT_TRIGGER, TOUCH_PLOT_CURSOR,
    TOUCH_BROWSE_DELETE_CANCEL, TOUCH_BROWSE_DELETE_CONFIRM,
    TOUCH_MEASURE_DRAG, TOUCH_MEASURE_LAYOUT, TOUCH_CURSOR_STRIP,
    TOUCH_ZOOM_OVERVIEW, TOUCH_PLOT_CH1, TOUCH_PLOT_CH2,
    TOUCH_TIME_IN, TOUCH_TIME_OUT, TOUCH_BROWSER_PREV, TOUCH_BROWSER_NEXT,
    TOUCH_BROWSER_BACK, TOUCH_SPLIT, TOUCH_FFT_CURSOR
} TouchZone;

typedef struct {
    TouchZone zone;
    int row, x, y, last_x, last_y, remainder;
    int fine_x_remainder, fine_y_remainder;
    int axis, active, moved, long_done;
    uint64_t since;
} TouchInput;

typedef struct { SDL_FingerID id; int x, y, active; } TouchContact;
static TouchInput touch;
static TouchContact contacts[2];
static uint64_t pinch_start_sq;
static int pinch_consumed, pinch_block;

#define CHORD_WINDOW_MS 90

static uint64_t now_ms(void)
{
    static uint32_t previous;
    static uint64_t high;
    uint32_t current = SDL_GetTicks();
    if (current < previous) high += UINT64_C(1) << 32;
    previous = current;
    return high + current;
}
static void invalidate(void) { dirty = plot_dirty = overlay_dirty = 1; }

static int capture_waiting(const CaptureMetrics *metrics,uint64_t presented,int running,int mode)
{
    return running && mode!=0 && metrics->triggered_ns<=presented;
}

static int has_hold_action(DemoControl control)
{
    return control != DEMO_CONTROL_COUNT;
}

static DemoControl active_control(int *progress)
{
    const HeldControl *held = mouse_hold.active ? &mouse_hold : NULL;int i;
    for(i=0;i<CONTROL_ID_COUNT&&!held;++i)if(key_holds[i].active)held=&key_holds[i];
    *progress = -1;
    if (!held) return DEMO_CONTROL_COUNT;
    if (!held->suppressed && has_hold_action(held->control)) {
        uint64_t elapsed = now_ms() - held->since;
        *progress = held->long_done || elapsed >= (uint64_t)demo.hold_time_ms ? 100 :
                    (int)(elapsed * 100 / (uint64_t)demo.hold_time_ms);
    }
    return held->control;
}

static void retain_display_frame(const void *frame,void *context)
{ capture_pipeline_retain_frame(context,frame); }
static void release_display_frame(const void *frame,void *context)
{ capture_pipeline_release_frame(context,frame); }

#ifdef SCOPE_ENABLE_LINUX_DISPLAY
static int present_display(const uint32_t *pixels,void *context)
{ return linux_display_present(context,pixels); }
#endif

static void draw_all(void)
{
    int progress;
    const DisplayFrame *frame=leased_frame?leased_frame:&capture_frame;
    DemoControl active = active_control(&progress);
    if(capture_pipeline&&capture_frame_valid&&!demo.waveform_loaded&&!demo.screen.browser_visible)
        capture_display_apply(&demo,frame);
    else {
        demo.screen.ch1_min_samples=demo.minimum[0];
        demo.screen.ch1_max_samples=demo.maximum[0];
        demo.screen.ch2_min_samples=demo.minimum[1];
        demo.screen.ch2_max_samples=demo.maximum[1];
    }
    if(renderer){
        ScopeRenderRegion regions[]={{&demo,sizeof(demo)},{frame,0,capture_frame_valid && leased_frame?retain_display_frame:NULL,
             capture_frame_valid && leased_frame?release_display_frame:NULL,capture_pipeline},
            {browse_pixels,demo.screen.browser_visible?sizeof(browse_pixels):0}};
        if(plot_dirty && !overlay_dirty)
            scope_renderer_submit_plot(renderer,&demo.screen,regions,3);
        else render_generation=plot_dirty?scope_renderer_submit(renderer,&demo.screen,regions,3):
            scope_renderer_submit_overlay(renderer,&demo.screen,regions,3);
        plot_dirty=overlay_dirty=0;
    }else scope_screen_render(screen_pixels, SCOPE_WIDTH, &demo.screen);
    if(panel_enabled)
        panel_sdl_draw(panel_pixels, &demo, active, hovered, progress, demo.hold_time_ms);
}

static void put_u16(FILE *file, uint16_t value)
{
    fputc(value & 255, file); fputc(value >> 8, file);
}

static void put_u32(FILE *file, uint32_t value)
{
    put_u16(file, (uint16_t)value); put_u16(file, (uint16_t)(value >> 16));
}

static uint16_t get_u16(FILE *file)
{
    int a=fgetc(file),b=fgetc(file); return (uint16_t)(a | (b << 8));
}

static uint32_t get_u32(FILE *file)
{
    uint32_t a=get_u16(file),b=get_u16(file); return a | (b << 16);
}

static int save_bmp(const char *path, const uint32_t *pixels, int width, int height)
{
    FILE *file=fopen(path,"wb"); int y;
    uint32_t offset=14+40, size=offset+(uint32_t)width*(uint32_t)height*4;
    if(!file) return 0;
    put_u16(file,0x4d42); put_u32(file,size); put_u16(file,0); put_u16(file,0); put_u32(file,offset);
    put_u32(file,40); put_u32(file,(uint32_t)width); put_u32(file,(uint32_t)height);
    put_u16(file,1); put_u16(file,32); put_u32(file,0); put_u32(file,size-offset);
    put_u32(file,2835); put_u32(file,2835); put_u32(file,0); put_u32(file,0);
    for(y=height-1;y>=0;--y)
        if(fwrite(pixels+(size_t)y*width,4,(size_t)width,file)!=(size_t)width) {
            fclose(file); return 0;
        }
    return fclose(file)==0;
}

static int save_wave(const char *path)
{
    FILE *file=fopen(path,"w"); DemoWaveCapture wave; int ok;
    if(!file) return 0;
    demo_signal_export_wave(&demo,&wave); ok=wave_file_write(file,&wave);
    return fclose(file)==0 && ok;
}

static int make_path(char *path, size_t size, const char *name)
{
    int written=snprintf(path,size,"%s/%s",application_dir,name);
    return written>=0 && (size_t)written<size;
}

static int compare_browse_names(const void *left, const void *right)
{
    return strcmp((const char *)right,(const char *)left);
}

static int has_extension(const char *name, const char *extension)
{
    size_t nl=strlen(name),el=strlen(extension);
    return nl>=el && strcasecmp(name+nl-el,extension)==0;
}

static void refresh_browse(void)
{
    DIR *directory=opendir(application_dir); struct dirent *entry;
    const char *names[DEMO_BROWSE_FILES]; int count=0,i;
    const char *extension=demo.browse_filter?".csv":".bmp";
    if(directory) {
        while((entry=readdir(directory))!=NULL && count<DEMO_BROWSE_FILES) {
            if(strncmp(entry->d_name,"capture_",8)==0 &&
               has_extension(entry->d_name,extension) &&
               strlen(entry->d_name)<DEMO_BROWSE_NAME) {
                memcpy(browse_names[count],entry->d_name,strlen(entry->d_name)+1);
                ++count;
            }
        }
        closedir(directory);
    }
    qsort(browse_names,(size_t)count,sizeof(browse_names[0]),compare_browse_names);
    for(i=0;i<count;++i) names[i]=browse_names[i];
    demo_signal_ui_set_browse_files(&demo,names,count);
}

static int delete_browse_capture(void)
{
    const char *name=demo_signal_ui_browse_filename(&demo);char path[PATH_MAX];
    return name&&make_path(path,sizeof(path),name)&&remove(path)==0;
}

static int load_browse_bmp(const char *path)
{
    FILE *file=fopen(path,"rb"); uint32_t offset,header,width,height,compression; uint16_t bits; int y;
    if(!file) return 0;
    if(get_u16(file)!=0x4d42) { fclose(file); return 0; }
    (void)get_u32(file); (void)get_u16(file); (void)get_u16(file); offset=get_u32(file);
    header=get_u32(file); width=get_u32(file); height=get_u32(file);
    (void)get_u16(file); bits=get_u16(file); compression=get_u32(file);
    if(header<40 || width!=SCOPE_WIDTH || height!=SCOPE_HEIGHT || bits!=32 || compression!=0 ||
       fseek(file,(long)offset,SEEK_SET)!=0) { fclose(file); return 0; }
    for(y=SCOPE_HEIGHT-1;y>=0;--y)
        if(fread(browse_pixels+(size_t)y*SCOPE_WIDTH,4,SCOPE_WIDTH,file)!=SCOPE_WIDTH) {
            fclose(file); return 0;
        }
    fclose(file); return 1;
}

static int load_browse_wave(const char *path)
{
    FILE *file=fopen(path,"r"); int ok;
    if(!file) return 0;
    demo_signal_export_wave(&demo,&browse_wave); ok=wave_file_read(file,&browse_wave);
    return fclose(file)==0 && ok;
}

static DemoSignal *live_settings(void)
{
    if(!live_snapshot_valid)return &demo;
    live_before_browse.startup_preset=demo.startup_preset;
    live_before_browse.preset_valid=demo.preset_valid;
    return &live_before_browse;
}

static int open_browse_capture(void)
{
    const char *name=demo_signal_ui_browse_filename(&demo); char path[PATH_MAX]; size_t length;
    if(!name || !make_path(path,sizeof(path),name)) return 0;
    length=strlen(name);
    if(length>=4 && strcasecmp(name+length-4,".bmp")==0) {
        if(!load_browse_bmp(path)) return 0;
        if(live_snapshot_valid) {
            int selected=demo.browse_selected; demo=*live_settings();
            demo.browse_selected=selected; live_snapshot_valid=0;
        }
        demo_signal_ui_show_capture(&demo,demo.browse_files[demo.browse_selected],browse_pixels);
    } else {
        if(!load_browse_wave(path)) return 0;
        if(live_snapshot_valid) {
            int selected=demo.browse_selected; demo=*live_settings();
            demo.browse_selected=selected; live_snapshot_valid=0;
        }
        live_before_browse=demo; live_snapshot_valid=1;
        demo_signal_ui_show_wave(&demo,demo.browse_files[demo.browse_selected],&browse_wave);
    }
    return 1;
}

static int capture(DemoAction action)
{
    char image_path[PATH_MAX],wave_path[PATH_MAX]; int index, ok=0;
    struct stat information;
    int directory=linux_storage_open(application_dir,require_data_device);
    if(directory<0) return require_data_device?-1:0;
    /* Resolve all files through this fd: an unmount cannot redirect them into RAM. */
    for(index=1;index<=9999;++index) {
        snprintf(image_path,sizeof(image_path),"/proc/self/fd/%d/capture_%04d.bmp",directory,index);
        snprintf(wave_path,sizeof(wave_path),"/proc/self/fd/%d/capture_%04d.csv",directory,index);
        if(stat(image_path,&information)!=0 && stat(wave_path,&information)!=0) break;
    }
    if(index<=9999) {
        ok=1;
        if(action!=DEMO_ACTION_WAVEFORM) {
            if(renderer){plot_dirty=1;draw_all();
                if(!scope_renderer_flush_plot(renderer,1000)){close(directory);return 0;}
                plot_dirty=0;draw_all();
                if(!scope_renderer_flush(renderer,render_generation,screen_pixels,1000)){close(directory);return 0;}}
            else scope_screen_render(screen_pixels,SCOPE_WIDTH,&demo.screen);
            ok=save_bmp(image_path,screen_pixels,SCOPE_WIDTH,SCOPE_HEIGHT);
        }
        if(ok && action!=DEMO_ACTION_SCREENSHOT) ok=save_wave(wave_path);
    }
    if(ok) return linux_storage_sync_close(directory);
    close(directory);
    return 0;
}

static void act(DemoAction action)
{
    if(action==DEMO_ACTION_PRESET_SAVE){
        unsigned slot=(unsigned)demo.preset_selected;
        int ok=settings_session_save(&settings,live_settings(),slot);
        demo.preset_valid=settings.document.valid;demo_signal_refresh(&demo);
        demo_signal_notify(&demo,ok?"SAVING PRESET":"PRESET SAVE FAILED");
    }else if(action==DEMO_ACTION_PRESET_LOAD){
        unsigned slot=(unsigned)demo.preset_selected;
        if(live_snapshot_valid)act(DEMO_ACTION_BROWSE_CLOSE);
        if(settings_session_load(&settings,&demo,slot)){
            unsigned ch;demo_signal_ui_dismiss_menu(&demo);
            if(serial_controls.started)for(ch=0;ch<2;++ch)restored_scale[ch]=demo_signal_panel_scale(&demo,ch);
            restore_retry_ms=0;
            demo_signal_notify(&demo,"PRESET LOADED");
        }else demo_signal_notify(&demo,"PRESET EMPTY");
    }else if(action==DEMO_ACTION_BROWSE_REFRESH) refresh_browse();
    else if(action==DEMO_ACTION_BROWSE_OPEN) {
        if(!open_browse_capture()) demo_signal_notify(&demo,"OPEN FAILED");
    } else if(action==DEMO_ACTION_BROWSE_PREV || action==DEMO_ACTION_BROWSE_NEXT) {
        if((demo.screen.browser_visible||demo.waveform_loaded)&&demo.browse_count) {
            int previous=demo.browse_selected;
            int direction=action==DEMO_ACTION_BROWSE_NEXT?1:-1;
            demo.browse_selected=(previous+direction+demo.browse_count)%demo.browse_count;
            if(!open_browse_capture()) { demo.browse_selected=previous; demo_signal_notify(&demo,"OPEN FAILED"); }
        }
    } else if(action==DEMO_ACTION_BROWSE_DELETE) {
        if(delete_browse_capture()) {refresh_browse();demo_signal_notify(&demo,"FILE DELETED");}
        else demo_signal_notify(&demo,"DELETE FAILED");
    } else if(action==DEMO_ACTION_BROWSE_CLOSE) {
        if(live_snapshot_valid) {
            int selected=demo.browse_selected;
            demo=*live_settings(); demo.browse_selected=selected; live_snapshot_valid=0;
            demo_signal_ui_close_capture(&demo);
        }
    } else if(action!=DEMO_ACTION_NONE) {
        int ok=capture(action);
        demo_signal_notify(&demo,ok==1?(action==DEMO_ACTION_SCREENSHOT?"SCREENSHOT SAVED":
            action==DEMO_ACTION_WAVEFORM?"WAVEFORM SAVED":"SCREEN AND WAVE SAVED"):ok<0?"NO DATA CARD":"SAVE FAILED");
    }
    invalidate();
}

static void press_control_at(DemoControl control, int long_press, uint64_t when)
{
    act(demo_signal_press_at(&demo,control,long_press,when));
    invalidate();
}

static void suppress_chord_control(DemoControl control)
{
    int i;
    if(mouse_hold.active && mouse_hold.control==control) mouse_hold.suppressed=1;
    for(i=0;i<CONTROL_ID_COUNT;++i) if(key_holds[i].active&&key_holds[i].control==control) key_holds[i].suppressed=1;
}

static void begin_press(HeldControl *held, DemoControl control, SDL_Keycode key_code, uint64_t now)
{
    held->control=control; held->key_code=key_code; held->since=now;
    held->active=1; held->long_done=0; held->suppressed=0;
    if(control==DEMO_BTN_CH1 || control==DEMO_BTN_MENU) {
        if(pending_chord!=DEMO_CONTROL_COUNT && pending_chord!=control &&
           now>=pending_time && now-pending_time<=CHORD_WINDOW_MS) {
            demo=chord_snapshot; suppress_chord_control(pending_chord); held->suppressed=1;
            pending_chord=DEMO_CONTROL_COUNT; act(DEMO_ACTION_SCREEN_AND_WAVE); return;
        }
        chord_snapshot=demo; pending_chord=control; pending_time=now;
    } else pending_chord=DEMO_CONTROL_COUNT;
}

static void finish_press(HeldControl *held, uint64_t now)
{
    if(!held->active) return;
    if(!held->suppressed&&!held->long_done)
        press_control_at(held->control,has_hold_action(held->control)&&
                         now-held->since>=(uint64_t)demo.hold_time_ms,now);
    held->active=0;
}

static void fire_long_press(HeldControl *held, uint64_t now)
{
    if(!held->active||held->suppressed||held->long_done||!has_hold_action(held->control)||
       now-held->since<(uint64_t)demo.hold_time_ms) return;
    held->long_done=1; pending_chord=DEMO_CONTROL_COUNT;
    press_control_at(held->control,1,now);
}

static int touch_screen_y(int logical_y)
{
    return scope_screen_waveform_top(&demo.screen)+
        logical_y*scope_screen_waveform_height(&demo.screen)/SCOPE_PLOT_HEIGHT;
}

static int touch_plot_y(int screen_y)
{
    return (screen_y-scope_screen_waveform_top(&demo.screen))*SCOPE_PLOT_HEIGHT/
        scope_screen_waveform_height(&demo.screen);
}

static int touch_channel_at(int x, int y, int tolerance)
{
    int sample=x-SCOPE_PLOT_X,d1,d2;
    if(sample<0) sample=0;
    if(sample>=SCOPE_PLOT_WIDTH) sample=SCOPE_PLOT_WIDTH-1;
    d1=demo.screen.ch1_enabled?abs(y-touch_screen_y(x<SCOPE_PLOT_X+40?
       demo.screen.channel_zero_y[0]:demo.ch1[sample])):10000;
    d2=demo.screen.ch2_enabled?abs(y-touch_screen_y(x<SCOPE_PLOT_X+40?
       demo.screen.channel_zero_y[1]:demo.ch2[sample])):10000;
    if(d1==10000&&d2==10000) return -1;
    if(tolerance>=0&&d1>tolerance&&d2>tolerance) return -1;
    return d1<=d2?0:1;
}
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
