Coal56AB/Oscilloscope/STM32/tests/test_encoder.c

/** @file test_encoder.c Смена направления, дребезг и восстановление фаз GPIO. */
#ifdef NDEBUG
#undef NDEBUG
#endif
#include "general_encoder.h"
#include <assert.h>
#include <stddef.h>

static GPIO_TypeDef port_a, port_b;
static const uint8_t phases[] = {0, 1, 3, 2};

/** Читать отдельные порты A/B так же, как это делает общий GPIO-драйвер. */
GPIO_PinState HAL_GPIO_ReadPin(GPIO_TypeDef *port, uint16_t pin)
{
  return (port->IDR & pin) ? GPIO_PIN_SET : GPIO_PIN_RESET;
}

/** Задать электрическое состояние, не обходя чтение GPIO внутри Encoder_Update. */
static void set_phases(uint8_t state)
{
  port_a.IDR = state & 2U;
  port_b.IDR = state & 1U;
}

/** Начальное положение GPIO не должно подменять заданную фазу фиксации. */
static void init_at(Encoder_HandleTypeDef *encoder, uint8_t state, unsigned steps, unsigned detent)
{
  set_phases(state);
  assert(Encoder_Init(encoder, &port_a, 2U, &port_b, 1U, steps, detent) == HAL_OK);
  assert(Encoder_Update(encoder) == 0);
}

/** Запустить предыдущие сценарии с явно заданным положением фиксации. */
static void init(Encoder_HandleTypeDef *encoder, uint8_t state, unsigned steps)
{
  init_at(encoder, state, steps, state);
}

/** Пройти реальные соседние фазы и вернуть сумму событий; bounce обратим. */
static int walk(Encoder_HandleTypeDef *encoder, int direction, unsigned edges, int bounce)
{
  unsigned index = 0, edge;
  int result = 0;
  while (phases[index] != encoder->state) ++index;
  for (edge = 0; edge < edges; ++edge)
  {
    uint8_t previous = phases[index];
    index = (index + (direction > 0 ? 1U : 3U)) % 4U;
    set_phases(phases[index]);
    result += Encoder_Update(encoder);
    if (bounce)
    {
      set_phases(previous);
      result += Encoder_Update(encoder);
      set_phases(phases[index]);
      result += Encoder_Update(encoder);
    }
    assert(Encoder_Update(encoder) == 0);
  }
  return result;
}

/** Каждый полный щелчок должен работать сразу после смены направления. */
static void test_reversal(unsigned steps)
{
  Encoder_HandleTypeDef encoder;
  unsigned start, i, bounce;
  for (start = 0; start < 4; ++start)
  {
    for (bounce = 0; bounce < 2; ++bounce)
    {
      init(&encoder, (uint8_t)start, steps);
      for (i = 0; i < 16; ++i) assert(walk(&encoder, 1, steps, bounce) == 1);
      assert(walk(&encoder, -1, steps, bounce) == -1);
      assert(walk(&encoder, 1, steps, bounce) == 1);
      for (i = 0; i < 16; ++i) assert(walk(&encoder, -1, steps, bounce) == -1);
      for (i = 0; i < 16; ++i)
      {
        assert(walk(&encoder, 1, steps, bounce) == 1);
        assert(walk(&encoder, -1, steps, bounce) == -1);
      }
      assert(encoder.invalid_transitions == 0);
    }
  }
}

/** Возврат незавершённого щелчка не создаёт вращение и не съедает следующий. */
static void test_partial_reversal(void)
{
  Encoder_HandleTypeDef encoder;
  unsigned start, edges;
  int direction;
  for (start = 0; start < 4; ++start)
  {
    for (edges = 1; edges < 4; ++edges)
    {
      for (direction = -1; direction <= 1; direction += 2)
      {
        init(&encoder, (uint8_t)start, 4U);
        assert(walk(&encoder, direction, edges, 1) == 0);
        assert(walk(&encoder, -direction, edges, 1) == 0);
        assert(walk(&encoder, -direction, 4U, 1) == -direction);
      }
    }
  }
}
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
