Coal56AB/Oscilloscope/(commit log)

2026-10-07 Добавлены субмодули для pcb и для gui
2026-10-08 Подготовлены диагностика Zynq-7020 и Linux с GUI
    GUI перенесён в ZYNQ7020, PCB сохранён субмодулем.
    Добавлены тест DDR/HDMI, образы SD/QSPI и автозапуск GUI.
    [genimage.cfg]
2026-10-08 Добавлен проект STM32F103RCT6 для CubeMX и Keil
    Настроены входы панели по схеме, SWD, HSI/PLL и USART1.
    Разделены чтение GPIO, обработка контактов и неблокирующий UART;
    код приложения сохраняется при повторной генерации CubeMX.
    Добавлены локальные HAL/CMSIS, тесты транспорта и документация.
    Проверены регенерация, 4/4 теста CTest и независимая ARM-сборка.
    Линковка Keil остаётся заблокирована ошибкой установленной лиц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
2026-10-08 Выделена самостоятельная сборка и каталог результатов STM32
    CMake собирает тесты панели и UART непосредственно из STM32,
    используя общий кодек управления. Результаты Keil и listing
    направлены в STM32/output; проверка проекта и инструкции обновлены.
    Проверены конфигурация CubeMX/Keil и 2/2 host-теста CTest Windows.
2026-10-08 Обновлены интерфейс, FFT и обработка ввода осциллографа
    Исправлены скругления и рамки панелей, компоновка Measurements,
    общая таблица курсоров CH1/CH2 и положение меню поверх карточек.
    Добавлены четыре цифры показаний, развёртки 500 нс–1 с,
    генератор до 1 МГц и FFT с логарифмической шкалой и dB.
    Энкодер переключает A/B/FFT; режим TIME/VERTICAL сохраняется.
    Отрисовка использует min/max для сохранения коротк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
    [capture_adapter.c, capture_processor.c, demo_signal.c, demo_signal.h]
2026-10-08 Подготовлена загрузка Linux из QSPI с ранним логотипом
    Linux FIT с ядром и initramfs упаковывается в image.bin для SDK;
    полный qspi.bin объединяет его с BOOT.BIN. Обновлены фиксированная
    разметка, проверки границ и содержимого SD/QSPI, manifest и архивы.
    Загрузка из QSPI и запуск GUI не требуют карты SD.
    Видео включается в FSBL сразу после конфигурации PL, до чтения
    U-Boot; кадр логотипа заполняется с кешем и сбрасывается в DDR.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
2026-10-08 Обновлён снимок интерфейса в README
    Общий снимок для корневого README и README GUI заменён кадром
    текущего интерфейса с двумя каналами, FFT, измерениями и курсорами.
    Изображение получено штатной командой Windows-предпросмотра
    и проверено в исходном разрешении 1024×600.
2026-10-08 Логотип размещён в каталоге GUI
    Исходное изображение, маска и общий отрисовщик перенесены в ZYNQ7020/gui/logo. Обновлены пути FSBL, CMake и Tinker Board; Buildroot получает логотип вместе с GUI без отдельного копирования.
    Проверены Windows 3/3 и Linux 5/5, ARM-сборка пакета GUI и компиляция отрисовщика для bare-metal. Изображение и алгоритм вывода сохранены.
2026-10-08 Полная сборка Linux запускается одной командой
    Добавлен последовательный запуск FPGA, FSBL, Buildroot, упаковки SD/QSPI, проверки образов и архива. Подготовка окружения отделена от сборки; локальные пути задаются явным JSON. GUI пересобирается из текущих исходников, старые результаты FSBL не принимаются после ошибки SDK.
    У каждого устройства есть краткий README с назначением, составом и тремя шагами сб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
2026-10-08 FINE уменьшает шаг перетаскивания курсоров FFT
    Перетаскивание частоты и уровня спектра учитывает FINE: движение замедлено в четыре раза с сохранением остатка. Первое касание не смещает курсор в точном режиме. Расчёт общий для Windows и SDL.
    Проверены Windows 3/3 и Linux 5/5. Тест настоящего SDL frontend проверяет оба режима FFT, уменьшение перемещения, захват без скачка и возврат в исходную точку.
2026-10-08 Прикладные модули STM32 выделены в Core/Oscill
    По образцу SM/UIPS пары .c/.h приложения размещены рядом, отдельно от генерируемой периферии. Обновлены группы и include-пути Keil, проверки проекта и host-сборка. Точки подключения в main.c сохранены.
    Проверена настоящая повторная генерация CubeMX 6.12.1: модули, заголовки, группы Keil и USER CODE сохранены. Проверка проекта и два теста панели/UART проходят.
2026-10-08 Подключены субмодули библиотек периферии STM32
    Добавлены PeriphGeneral и MyLibs с закреплёнными версиями и локальной конфигурацией HAL. Keil подключает GPIO и энкодеры; LED_RUN на PC7 настроен в CubeMX по схеме платы.
    Повторная генерация сохраняет пользовательские группы и include-пути; проверка проекта дополнена контролем библиотек и PC7.
2026-10-08 Панель STM32 использует библиотечные обработчики GPIO
    Кнопки фильтруются GPIO_Read_Switch, энкодеры сами читают GPIO в Encoder_Update, LED управляется общей библиотекой. Карта платы переводит результаты в события; controls хранит только очередь и heartbeat, UART остаётся отдельным транспортом.
    Добавлены проверки адаптера платы с управляемыми GPIO. Windows Release: 4/4; список C-файлов Keil собран и слинкован GNU Arm. Keil не наход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
2026-10-08 README проектов оставлены краткими обзорами
    Проверены все README, включая библиотеки и пакет Tinker Board. Убраны подробности API, настройки и диагностики; сохранены изображения, возможности, необходимые действия запуска и ссылки на документацию. Подробности запуска Tinker перенесены в BUILDING.md, который входит в пакет.
    Проверены локальные ссылки и изображения восьми README и синтаксис сборочного с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
2026-10-08 Восстановлена исходная документация подключённых библиотек
    Отменена переработка README и добавление документации в субмодулях MyLibs и PeriphGeneral. Сохранён запрошенный GPIO-обработчик энкодеров.
2026-10-08 Удалены непрошеные тесты и изменения готовых библиотек
    В PeriphGeneral закреплён один коммит с двумя файлами GPIO-энкодера. MyLibs возвращена к исходной версии; general_gpio и README библиотек сохранены без изменений. Удалены добавленные тесты энкодера и панели.
    Приложение использует исходный API фильтра кнопок. Оставшиеся проверки очереди и UART проходят: 2/2.
2026-10-08 ZOOM раскрывает детали исходного сигнала
    Выбранный интервал демо пересчитывается по времени сохранённого захвата,
    вместо растягивания 1024 экранных точек. Масштаб ZOOM использует общий
    ряд развёрток 1–2–5 и отображается в TIME, курсорах и CSV.
    Перемещение окна сохраняет дробную позицию; CSV интерполируется между
    сохранёнными точками. Убраны неиспользуемые копии экранных диапазонов.
    Про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
2026-10-08 Убрано дублирование развёртки над окном ZOOM
    В полосе под обзором захвата отображается ZOOM. Текущая развёртка остаётся в карточке TIME. Проверка рендерера прошла на Windows и Linux.
2026-10-08 Осциллограммы масштабируются из исходных отсчётов
    Общий waveform_view используется демо, raw-процессором и CSV: сжатие
    сохраняет диапазон каждого столбца, увеличение интерполирует исходные
    отсчёты. Сетка демо 200 MSPS не зависит от 1024 экранных столбцов,
    поэтому шум не растягивается блоками в ZOOM. Цветной штрих имеет
    постоянную толщину 1 px. Обновлён список исходников TinkerBoard.
    Проверены исходны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
2026-10-08 Демо-захват подбирает дискретизацию по развёртке
    Запись ограничена 8192 исходными отсчётами на канал. Частота захвата
    снижается на длинных основных развёртках и ограничена 200 MSPS.
    Убраны постоянные аналитические границы шума: общий waveform_view
    считает min/max по сохранённому буферу. ZOOM читает этот же буфер,
    не увеличивая частоту уже выполненного захвата.
    Проверены адаптивная сетка, изме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
2026-10-09 В обзоре захвата показан коэффициент ZOOM
    Подпись ZOOM xN показывает отношение основной развёртки к увеличенной. Значение вычисляется из временных масштабов; карточка TIME сохраняет текущую развёртку. Подпись выровнена справа с учётом её длины.
2026-10-09 Уведомления отображаются поверх всех окон
    Предупреждения и сообщения состояния рисуются последним слоем после меню и диалогов подтверждения. Общая отрисовка уведомления также вызывается при просмотре сохранённого изображения. Сохранены расположение, цвета и затухание.
2026-10-22 Реализовано управление осциллографом с панели STM32 и сенсора
    STM32 обрабатывает кнопки и энкодеры, выбирает масштабы каналов и реле,
    передаёт итоговые параметры и напряжение питания. Двусторонний UART
    синхронизирует RUN и режимы энкодеров; предусмотрена автономная отладка.
    Zynq автоматически находит панель через USB–UART и восстанавливает связь.
    Добавлен терминал ПК для управления осцил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
2026-10-22 Инвертировано направление TIME и навигации FUNC
    Энкодер TIME меняет масштаб основной развёртки и ZOOM в обратном
    направлении. FUNC перемещается по пунктам меню в обратном порядке.
    Перемещение позиции, курсоров, редактирование значений и сенсорное
    управление сохраняют прежнее направление.
    Обновлены проверки и документация. Windows: 3/3, Linux: 13/13.
    Пересобраны ARM GUI и образы Zynq; проверка образов пр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
2026-10-23 Добавлены OLED и температура STM32
    Реализованы независимая служба состояния, страницы OLED и ранняя индикация загрузки из FSBL. Кнопка K1 читается с PS MIO0; исправлено прежнее назначение на физическую K3. Аппаратная часть, Linux UIO/GPIO, watchdog GUI и документация подключены к штатной сборке.
    Температура кристалла STM32 проходит через неблокирующий цикл ADC9/16/17, общий UART-кодек и snapshot GUI. На обычных страница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
2026-10-23 Исправлены энкодеры, нажатия и просмотр в STOP
    Подключён декодер с явно заданной фазой фиксации: запуск между щелчками и недопустимые переходы больше не сдвигают границу детента. Направление CH1/CH2 изменено только в SCALE, прежняя дельта POSITION сохранена.
    Удержание отдельной кнопки закрывает соответствующее меню, MENU/BACK закрывает любое открытое меню. В DEBUG доступны LONG PRESS и DOUBLE CLICK; двойно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
2026-10-23 Добавлено обновление Zynq через терминал без бэкапов
    Вкладка прошивки передаёт BOOT.BIN и image.bin фактического размера, показывает прогресс на ПК и приборе, проверяет SHA-256 до записи и результат проверки flash. Для старой прошивки поддержана загрузка режима обновления в RAM через U-Boot.
    Убран обязательный бэкап QSPI по указанию владельца. Повторяется только повреждённая передача блока с фиксир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
2026-10-23 Добавлен реальный захват АЦП с изменяемой частотой записи
    FPGA считывает AD9288, равномерно прореживает пары каналов и передаёт пакеты с длиной, частотой и счётчиками через AXI DMA SG. ABI 3 позволяет менять частоту и размер пакета без нового mmap; leased-буферы защищены от повторной записи.
    Linux поддерживает непрерывное дополнение SG-цепочки, обнаружение overflow и таймаутов. Настроены входные задер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
2026-10-23 Устранены остаточные данные при перенастройке DMA
    После завершения пакета сбрасывается входной поток и повторно очищается S2MM. Это исключает попадание старых слов вместо заголовка новой записи. Аппаратный тест выводит заголовки при ошибке.
    Проверено на плате: по два прогона на 200M, 100M, 1M, 10K и 100 Sa/s; повторное открытие и lease стабильны. На 200 MSa/s получено около 399 МБ/с.
2026-10-23 Сохранено ручное переключение всех страниц OLED
    Ошибки больше не переключают страницу. Пропущенные READY-блоки отображаются отдельным счётчиком, температурные страницы входят в общую нумерацию. Тест проверяет полный цикл K1 при изменяющихся ошибках.
    Linux CTest: 11 из 11 тестов прошли.
2026-10-23 Добавлены глубина записи TIME и прокрутка длинных развёрток
    Развёртка охватывает 10 нс/дел–5 с/дел. TIME выбирает 10K/50K/100K/500K/1M точек и показывает автоматически выбранную частоту. AUTO свыше 100 мс/дел прокручивает накопленную историю; STOP, NORMAL и SINGLE сохраняют исходные отсчёты для повторного построения.
    DEBUG подменяет значения только после настоящего DMA. Общий генератор, кешируемая история и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
2026-10-23 Ускорены большие записи и устранён разрыв истории при отрисовке
    AUTO сначала разбирает очередь DMA в ограниченной партии. Это позволяет накопить непрерывную историю при обработке медленнее периода блока. NORMAL/SINGLE сохраняют последовательную проверку событий.
    Целочисленная генерация NOISE и NEON-обработка статистики и экранных экстремумов ускоряют режимы 1M. Суммы, RMS, частота, скважност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
2026-10-23 Подтверждена прошивка платы и проверка после загрузки из QSPI
    Через Oscill Terminal записаны BOOT и FIT фактического размера без резервных копий, с проверкой flash. После перезагрузки сверены FPGA, ядро и SHA-256 GUI; DMA продолжает захват без ошибок. ROLL заполняет экран, STOP сохраняет запись при переносе и смене масштаба.
    Асинхронный тест перенастройки ждёт кадр с новой частотой DMA и допускает промежуточ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
2026-10-24 Исправлены диапазоны АЦП и восстановление запуска осциллографа
    Пересчёт кодов АЦП определяется аппаратной ступенью делителя, а В/дел отдельно меняет высоту следа. Общая таблица используется STM32 и адаптером GUI; маски реле сохранены. Зафиксирована версия PCB с фактическими номиналами.
    Обычная развёртка ждёт полный кадр, периодические формы DEBUG получают небольшой шум. Стартовые пр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
2026-10-24 Сохранены экстремумы записи и отзывчивость интерфейса
    FPGA сохраняет min/max обеих ветвей при прореживании вместе с равномерными отсчётами. Драйвер, ABI и история передают обе части согласованно. Большое окно сохраняет размах меандра, а увеличение STOP соединяет сохранённые отсчёты без растянутых прямоугольников.
    Coloring считает реальные попадания в физические пиксели и сохраняет данны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
2026-10-24 Устранён скачок огибающей при увеличении записи
    При переходе через один отсчёт на пиксель min/max полностью исчезал: для остановленной записи 200 kSa/s это резко меняло вид между 1 мс/дел и 500 мкс/дел. Каждый интервал экстремумов теперь даёт тонкую вертикальную метку в своём центре. Совпавшие колонки объединяются при сжатии, а при увеличении метки постепенно расходятся без растягивания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
2026-10-24 Пропущенные пики соединены непрерывной линией
    Отдельные вертикальные метки Peak Detect заменены соединением через пропущенные экстремумы внутри их интервалов. Если сохранённые отсчёты уже охватывают min/max, изображение совпадает с обычной линией. Один небольшой пик добавляется около ближайшего сохранённого экстремума без перестройки противоположной части; два скрытых пика образу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
2026-10-24 Шум отображается без толстого следа и подложки при увеличении
    Обычный след использует яркость реальных попаданий в пиксели, как COLORING использует цвет. Убраны дополнительный контур и сплошная шумовая огибающая; сохранённые отсчёты соединяются тонкой линией. Карта плотности рассчитывается существующим обработчиком кадров.
    Аппаратные экстремумы отделены от равномерной линии: п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
2026-10-24 Убраны разрывы фронтов и ложный период при сжатии
    В аппаратном отображении соединение редких опорных точек заменено картой покрытия всех последовательных отрезков исходной записи. Каждый отрезок пересекается с временными границами пикселя: сжатый меандр сохраняет стенку, увеличение раскрывает сохранённую кривую. Разностный массив ограничивает стоимость обработки длинного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
2026-10-24 Выровнена яркость кривой на разных масштабах
    Убрано ограничение покрытия уровнем 160 из 255 при сжатии. Максимальное покрытие каждой колонки всегда имеет полную яркость, а редкие переходы отображаются по корневой шкале с нижним уровнем 96. Геометрия, исходные счётчики COLORING, Peak Detect, FFT и измерения сохранены; пустые пиксели не закрашиваются.
    Проверки: Linux 12/12, Windows 5/5, ARM и состав образов.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
2026-10-25 Исправлена фильтрация кривой и упрощено меню
    Фильтры LOW/MEDIUM/HIGH усредняют 5/17/65 исходных отсчётов перед построением кривой, границ, плотности и соединений. Убрано повторное сглаживание экранных координат; аппаратный обработчик получает настройку фильтра и пересчитывает удержанную запись в STOP. OFF точно возвращает исходное отображение, FFT, измерения и триггер аппаратного захвата с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
2026-10-25 Добавлены пресеты настроек и калибровка АЧХ
    Последнее состояние и пять пресетов сохраняются асинхронно с атомарной заменой файла. На плате используется JFFS2 существующего раздела settings; при запуске выбирается LAST или отдельный пресет. Диапазоны восстанавливаются через подтверждения STM32. После аварийного завершения служба удаляет оставшиеся PID и управляющий сокет перед повторным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
2026-10-25 Разделены отрисовка графика и управление интерфейсом
    График каналов строится отдельным потоком, меню и курсоры выводятся поверх последнего готового графика. Готовые карты передаются по аренде слотов без копирования в цикле ввода; старые данные не перезаписываются, ожидающие обновления объединяются. Вывод framebuffer вынесен из цикла управления, растеризатор получил состояние пот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
2026-10-25 Исправлены фронты триггера и калибровка нуля каналов
    Выключенный канал отпускает все три реле и сохраняет выбранный диапазон. OFF передаётся отдельным значением протокола; повторные команды, reconnect, сброс панели и запоздалые подтверждения не включают его случайно. Вращение выключенного канала не переключает реле. Начальное состояние штатной STM32 — оба канала OFF, автономная отладк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
2026-10-25 Разделены калибровки нуля, шума и АЧХ
    CALIBRATE содержит три раздела: ZERO, NOISE и FREQUENCY RESPONSE. В каждом свои запуск и сброс; все действия доступны FUNC и энкодером выбранного канала. BACK возвращает через список калибровок в настройки канала. Неизмеренные сбросы серые, доступные выделены красным. Сбросы не удаляют соседние результаты.
    Измеренный ноль применяется к осциллограмме, измерениям и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
2026-10-25 Сохранены настройки и добавлена калибровка диапазонов
    ZERO и NOISE обходят три рабочие ступени реле, ждут подтверждённый диапазон и собирают четыре свежие записи на каждой. Результаты хранятся отдельно для ступеней и каналов; завершение и отмена возвращают исходный диапазон, незавершённый проход не заменяет прежние калибровки. Новый запрос диапазона заменяет ожидающую команду во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
2026-10-25 Измерен сырой шум замкнутого входа CH1
    В документации проверок зафиксированы прямые измерения DMA на шести диапазонах, отдельно для двух чередующихся ветвей AD9288. На каждой настройке обработано 4 194 304 отсчёта без фильтров и калибровочных поправок. Диагностические режимы encode 50, 25 и 12,5 МГц проверены отдельно от штатных 100 МГц на ветвь.
    Подтверждены увеличение RMS при смене аппаратной ст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
2026-10-25 Измерен сырой шум замкнутого входа CH2
    Зафиксированы измерения шести диапазонов CH2 без конденсаторов в делителе: 4 194 304 исходных отсчёта на настройку, отдельно по двум ветвям АЦП. На штатном encode 100 МГц RMS составляет 24–26 кодов и мало зависит от ступени диапазона.
    В диагностических режимах encode 50 и 25 МГц разброс ветви B возрастает, при 12,5 МГц ветвь A даёт около одного кода RMS, а B сохраняет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
2026-10-25 Уточнены ветви АЦП и проверен приём D5
    Разделены логические имена FPGA и физические обозначения A/B на схеме.
    Уточнены подключения данных и тактов, а также линия ADC0_D5A через XS1.17.
    Зафиксированы замеры сырого CH1 при смене фазы приёма и слабых подтяжек D5.
    Изменение фазы не устранило разброс ветви; подтяжки заметного эффекта не дали.
    Причина не объявляется установленной. Штатные BOOT, FIT и на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
2026-10-25 Собраны таблицы сырого шума обоих АЦП
    Измерены оба замкнутых BNC на трёх аппаратных ступенях реле без обработки.
    Для каждой ступени сохранены полная статистика и последовательные коды
    физических ветвей A/B в десятичном и восьмиразрядном двоичном виде.
    Зафиксированы методика, RMS ветвей, проверка передачи и сохранность настроек.
    Подготовлена Excel-таблица с 2048 отсчётами каждой ветви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
2026-10-25 Исправлены разряды CH1 и медленный захват АЦП
    По исходным схемам AD9288 и MINI проверены все 32 линии данных и оба такта. В XDC устранена перестановка D3A/D5A первого АЦП: N17 относится к D3A, W14 — к D5A. Сырые данные не маскируются и не исправляются программной фильтрацией. Уточнена интерпретация прежнего эксперимента с подтяжкой N17.
    При делении физического encode пара фиксируется на один приёмный ц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
2026-10-26 Ускорены захват и расчёт измерений осциллографа
    Измерения частоты, duty и напряжения рассчитываются по обработанной кривой; исходная статистика калибровки хранится отдельно.
    ПЛИС отсеивает участки без возможного пересечения порога с учётом подавления шума. Размер блока согласован с глубиной записи. Захват, обработка и показ выполняются параллельно; первый готовый кадр сохраня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
2026-10-26 Добавлено поточное подавление шума в ПЛИС
    Модуль Wiener вычисляет обработанный отсчёт по среднему и дисперсии окна из 17 точек. Короткие разрешённые импульсы сохраняются; шумовая мощность задаётся отдельно от сигнала. Конвейер принимает новый отсчёт каждый такт и выдаёт результат с дробной частью.
2026-10-26 Добавлены поточные фильтры на 5, 17 и 65 точках
    Добавлено центрированное усреднение на 5, 17 и 65 точках с дробным выходом. Фильтр принимает по две или четыре точки за такт, сохраняет абсолютное время сигнала и исключает точки с неполной предысторией. Деление выполняется конвейером без остановки потока.
2026-10-26 Добавлен аппаратный триггер по обработанному сигналу
    Поток проходит подавление шума, ручной фильтр и детектор переходов через гистерезис. Детектор сохраняет время первоначального пересечения уровня и выдаёт фронты в порядке их появления.
    Каждый взвод принимает один первый подходящий фронт с учётом начального отсчёта и holdoff. Результат удерживается до следующего взвода; канди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
2026-10-27 Добавлена атомарная настройка обработки в ПЛИС
    Новый регистровый банк передаёт параметры фильтра и триггера в домен АЦП одним обновлением. Отдельный ID взвода отделяет результаты разных захватов; повторная фиксация занятого банка отвергается.
    Linux-драйвер предоставляет SET_DSP и определяет наличие банка по признаку в прежнем GPIO, сохраняя совместимость со старой ПЛИС.
2026-10-27 Разделены краткие описания и материалы разработки
    В docs оставлены краткие описания для пользователя, подробные документы перенесены в docs/agents. Обновлены ссылки, исходная схема платы сохранена в тематическом каталоге.
    В AGENTS закреплены требования к предметным сообщениям коммитов и проверке смежного поведения осциллографа.
2026-10-27 Поиск триггера подключён к потоку ПЛИС
    ПЛИС фиксирует первое разрешённое пересечение после фильтрации и передаёт его номер в заголовке захвата. Linux собирает полную запись вокруг аппаратного события без повторного поиска фронтов.
    Настройки DSP передаются атомарно; повторный взвод не останавливает DMA. Контекст и подтверждение показа сохраняют предысторию и первый принятый кадр.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
2026-10-27 Прореживание в ПЛИС учитывает весь интервал сигнала
    Равномерные точки вычисляются из всех исходных отсчётов интервала вместо выбранной пары A/B. Это убирает зависимость шума от случайного попадания высокочастотной составляющей в прореженные точки при смене развёртки.
    Деление выполняется конвейерно, остаток переносится между точками без сдвига нуля. Исходные минимумы и макси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
2026-10-27 Измерения вынесены в общий численный модуль
    Экстремумы, среднее, RMS, частота и duty рассчитываются через единый API без зависимостей от GUI. Рабочую память предоставляет вызывающая сторона; сортировка периодов не требует qsort и указателей на функции.
    Общий детектор сохраняет исходную пару пересечения и вычисляет дробное время после подтверждения фронта. Центрирование целочисленных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
2026-10-27 Добавлено аппаратное ядро измерений записи
    ПЛИС рассчитывает экстремумы, среднее, RMS, частоту и duty повторным проходом по DDR через HP1. Численный алгоритм общий с настольной моделью; блочное чтение отделено от арифметики, для амплитудных статистик доступен проход без поиска периодов.
    Драйвер oscill-analysis передаёт запись и калибровку через ioctl, ожидает аппаратный IRQ и возвращает численн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
2026-10-27 Измерения GUI подключены к ядру ПЛИС
    Обработчик кадра передаёт исходные точки и видимую обработанную кривую через численный интерфейс SignalAnalyzer. Аппаратный адаптер возвращает напряжения, частоту и duty; амплитудные проходы обходятся без поиска периодов.
    Совместимое ядро выбирается при запуске захвата. Ошибка аппаратного расчёта останавливает обработку с source_error, без скрытого повт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
2026-10-27 Устранена потеря точности duty в длинных записях
    Измерения времени вычитают целые номера пересечений до добавления дробных частей. Абсолютные номера около 1M больше не округляются во float перед вычислением ширины импульса.
    Суммы периодов, длительностей и квадратов используют компенсированное накопление, сохраняя точность duty и оценки регулярности на длинных записях.
2026-10-27 Синтез HLS сохраняет исходную причину отказа
    Обработчик отказа выводит сообщение HLS независимо от наличия поля errorinfo. Некорректные параметры запуска завершают сценарий до создания проекта и маркера готовности IP.
2026-10-27 Расчёт ПЛИС совмещён с подготовкой графика
    BEGIN фиксирует входные данные и запускает численный проход, FINISH возвращает результат после IRQ. Во время аппаратного расчёта обработчик готовит экранную проекцию; график и измерения публикуются вместе.
    Дескриптор удерживает одну задачу до получения результата или закрытия. Повторный запуск отвергается, закрытие дожидается задачи, тайм-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
2026-10-27 Глубокая аппаратная запись собирается до распаковки DMA
    При глубине больше payload сборщик удерживает смежные DMA-блоки до набора полной записи. AUTO и FORCE продолжают обновлять экран, когда распаковка одного блока медленнее прихода следующего.
    Готовность учитывает смежную историю, sequence, номера отсчётов, Fs и формат пиков. Накопление контекста не отмечается как отбрасывание сигнала; лими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
2026-10-27 Фильтрация записи выделена в общий код для ПЛИС и ПК
    Wiener и ручной FILTER используют общий численный тип с выбором double или float. API signal_filter_trace принимает коды АЦП либо физические значения и возвращает физические значения после обеих стадий.
    Запись обрабатывается плитками с полным соседним контекстом. Границы плиток не меняют форму сигнала, а рабочая память не растёт вместе с глубиной з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
2026-10-27 Wiener и FILTER записи перенесены в ПЛИС
    Ядро повторного прохода по DDR выполняет общий фильтр записи и возвращает значения в физических единицах. Оконный контекст сохраняется между плитками, исходная запись АЦП остаётся доступной для STOP и увеличения.
    Драйвер предоставляет FILTER_RECORD с отдельным признаком возможности и копирует вход и выход через принадлежащую устройству память. GUI пере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
2026-10-27 Сокращена разрядность индексов и ускорены окна фильтра
    Аппаратный повторный проход использует 32-битные индексы записи вместо size_t компьютера сборки. Настольный API сохраняет прежний тип, целые моменты амплитуды остаются 64-битными.
    Wiener и FILTER сдвигают окно одним добавлением и удалением отсчёта. Обратные размеры окон заданы таблицей, циклы оценивания конвейеризованы с сохранением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
2026-10-27 Доступ ядра обработки к DDR объединён в один интерфейс
    Исходные коды, физические значения и результат используют общий AXI master. Плиточные фазы выполняются последовательно, отдельный арбитраж между тремя подключениями ядра не требуется.
    SmartConnect согласует общий интерфейс с HP1. Карта управления, частота ядра и контракт драйвера сохранены.
2026-10-27 Счётчики окон фильтра ограничены их фактическим размером
    В Wiener и ручном FILTER количество отсчётов хранится в 8 битах при максимуме 65. Байтовая сумма Wiener занимает 16 бит: даже до удаления уходящего отсчёта она не превышает 4590.
    Убрана лишняя широкая арифметика локального окна; длина записи и её индексы сохраняют прежний диапазон.
2026-10-27 Сравнения float в ядре записи разделены регистрами
    Компаратор DDR replay использует задержку HLS 3: сравнение и последующая управляющая логика выполняются в разных стадиях. Частота ядра остаётся 100 МГц, карта управления и численные операции сохраняются.
2026-10-27 Пользовательская документация объединена в три темы
    В корне docs оставлены работа с прибором, сборка и запись, устройство и подключение. Удалены отдельные краткие обёртки технических документов, обновлены ссылки README и инструкций.
    Подробные материалы остаются в docs/agents, оригинальные схемы и даташиты — в тематических каталогах. В AGENTS закреплено объединение пользовательских описан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
2026-10-27 NaN и Inf распознаются одинаково в модели и ПЛИС
    Общий signal_number_finite определяет допустимость float по экспоненте IEEE-754. Фильтры, измерения и параметры DDR replay больше не зависят от несовместимых флагов Windows fpclassify и библиотеки HLS.
    Пропуск остаётся в своей точке и не распространяется на соседние значения. Для настольного double сохранён стандартный isfinite.
2026-10-27 ROLL сохраняет ширину кривой при смещении и разрывах
    В RUN окно ROLL следует за концом принятой истории независимо от горизонтального положения триггера. В STOP смещение ограничено сохранёнными отсчётами, чтобы край экрана не уходил за запись.
    После разрыва захвата полный кадр сохраняется до накопления новой истории с не меньшим покрытием времени. Кривая больше не заменяется коротким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
2026-10-27 Отдельные отчёты создаются только по явному запросу
    В правилах закреплён запрет на создание и дополнение файлов отчётов без прямой просьбы владельца. Результаты работы сообщаются в чате.
2026-10-27 Проект Vivado и его IP сохранены в Git
    Добавлены oscill.xpr, блок-схема system, wrapper и локальные пакеты HLS и Digilent. Проект использует относительные ссылки и содержит необходимые исходники для открытия в Vivado.
    Аппаратная сборка открывает сохранённый проект и использует его настройки. Повторное Tcl-описание схемы удалено; HLS обновляет опубликованный RTL-пакет своего IP. Отключены автоматические отчёт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
2026-10-27 Обновлён корпус в составе проекта
    Субмодуль PCB использует актуальные модели усиленного корпуса и STL, связанные с геометрией деталей. Усиления передних стоек импортируются без дублирования посадок втулок; задняя рамка имеет угловые заполнения и сплошную опору PCB.
    В docs/agents/DECISIONS.md отражены положение зарядника для совмещения J8/P1, крепление на M2 и способ повторного использования STL.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
2026-10-27 Обновлены панель корпуса и скос экрана
    Субмодуль PCB содержит колпачки энкодеров диаметром 11,5 мм, выровненные фоновые зоны и уточнённые подписи накладки. Внутренний край скоса LCD сохранён без скругления, которое укорачивало его вылет к активной области.
    В решениях проекта зафиксированы расположение подписей, оформление каналов BNC и геометрия кромок экранного окна.
2026-10-27 Обновлён скос корпуса со скруглённым бортиком
    В субмодуле PCB сохранён внутренний бортик экранного окна R0,4 и пересчитан наклон граней по границам активной области LCD. Окантовки RUN/STOP и светодиода на панели выполнены красными.
    В решениях проекта описаны геометрия светового проёма и углы граней с учётом радиуса кромки.
2026-10-27 Обновлена окантовка BNC на панели корпуса
    Субмодуль PCB содержит накладку с круглыми внутренними контурами колец BNC. Плашки с номерами каналов не перекрывают внутреннюю кромку окантовки.
2026-10-28 Добавлена яркость сетки и полное скрытие измерений
    DISPLAY содержит регулировку GRID BRIGHTNESS от 0 до 10; уровень 5 сохраняет прежний контраст. Яркость входит в последние настройки и пресеты, документы версий 1–5 получают значение по умолчанию при загрузке.
    Скрытая таблица измерений полностью исчезает с главного экрана и освобождает сенсорную область. Повторное отображение доступно чере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
2026-10-28 Упрощён дисплей и включено мгновенное перемещение измерений
    В DISPLAY пункты расположены в порядке LAYOUT, GRID, GRID BRIGHTNESS. Выбор шрифта и отдельное меню шрифтов удалены; при загрузке прежних настроек и пресетов используется Inter с сохранением совместимости документа.
    MEASURE X/Y в LAYOUT перемещают таблицу сразу во время редактирования и при нажатии «− / +». COARSE задаёт шаг 8 пикселей, FINE — 1 пиксель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
2026-10-28 Шаг COARSE для таблицы измерений увеличен до 10 пикселей
    Перемещение MEASURE X/Y в LAYOUT энкодером и кнопками «− / +» использует шаг 10 пикселей в COARSE. В FINE сохранён шаг 1 пиксель; координаты применяются сразу и ограничиваются доступной областью экрана. Описание управления приведено в соответствие с новым шагом.
    Обевлен PCB
2026-10-29 Уточнено разрешение на закрытие занятых приложений
    В правилах проекта закреплено постоянное разрешение владельца закрывать мешающее приложение после нескольких минут ожидания ответа. Явный запрет пользователя сохраняет приоритет; создание обходных копий не допускается.
2026-10-29 Обновлены параметры проекта Vivado
    В oscill.xpr включён отчёт использования ресурсов после размещения с выводом RPT и PB. Сохранены описания стандартных стратегий синтеза и реализации, путь проекта и порядок служебных записей IP.
2026-10-29 Уточнена подпись платы и обновлён PCB с видами корпуса
    Подпись и альтернативный текст изображения платы описывают видимые экран, BNC-входы и органы управления. Указатель субмодуля PCB и ссылка на его README обновлены на ревизию с видами корпуса спереди и сзади.
2026-10-30 Добавить XY и управление применением калибровок
    В DISPLAY добавлен выбор YT/XY. Координаты XY формируются из синхронных пар CH1/CH2 после обработки каналов, с независимыми положениями осей и сохранением настроек временного отображения.
    FILTER перенесён из PROCESSING в настройки соответствующего канала перед CALIBRATE. Общие меню, панель, сенсор и команды ПК используют одинаковые параметры каналов.
    ZE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
2026-10-30 Добавить множитель щупа x100
    PROBE обоих каналов и ПК-терминала содержит x1, x10 и x100. Общая таблица множителей пересчитывает шкалы напряжения, ADC, измерения, курсоры и уровень триггера без изменения ступени реле.
    Настройки, пресеты, CSV и команды ПК сохраняют прежние имена полей probe_ten: значения 0 и 1 означают x1 и x10, значение 2 задаёт x100. Загрузка CSV сохраняет множитель и физическую шкалу до 500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
2026-10-30 Восстановить генерацию IP сохранённого проекта Vivado
    Выходные файлы исходной system.bd генерируются до поиска и обновления HLS IP. Служебные конфигурации журналов исключены из отключения отчётов, чтобы сохранялась корректная запись проекта Vivado 2019.1.
    Незавершённые IP сбрасываются для повторного запуска, завершённые сохраняются. Параллелизм ограничен двумя заданиями и четырьмя потоками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
2026-10-30 Запланировать расширение захвата, MATH и два Ethernet
    В ADC_CAPTURE запланированы расширенный триггер до прореживания и аппаратное кольцо предыстории в DDR. В ARCHITECTURE описан отдельный канал MATH на ARM: арифметика сигналов, интеграл и производная, физические единицы и обработка разрывов.
    Для двух Ethernet выбран PS GEM0 через MIO к U18/J3 и PS GEM1 через EMIO и мост GMII–RGMII в PL к U17/J2. Описаны независимые интерфейсы L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
